3XAY/aPeacefulSceneBlot/README.md

# UPDATE: BLOT HAS BEEN CANCELLED, THIS REPO IS NO LONGER BEING WORKED ON - 3XAY

# Blot, the plotter bot from Hack Club

**[🕸 Landing Page](https://blot.hackclub.com)** | **[💻 Online Editor](https://blot.hackclub.com/editor)** | **[👀 Gallery](https://blot.hackclub.com/gallery)**

Create programmatic art in our web-based editor and submit it to the gallery and we'll send you a CNC machine which can make that art for free.
Blot is a [**You Ship, We Ship**](https://github.com/hackclub/blot/tree/main?tab=readme-ov-file#you-ship-we-ship) project from [Hack Club](https://hackclub.com). 

> Everything about Blot is open source. The online editor and drawing library can be freely used by anyone, and we encourage all to submit to the gallery through PRs! However, you must be a teenager or younger to receive a free machine.

blot-white-bg

A piece of art made for Blot can be the first program you ever write, but it can also be a challenge for a master programmer. Check out some of the art made already in our [gallery](https://blot.hackclub.com/gallery). Every piece of art you see is actually a program. Many of them create unique pieces every time the art is run. You may be looking at an artwork which has never been seen before, even by the creator.

For a short video introduction to Blot [check out our 38 second trailer](https://www.youtube.com/watch?v=d1noJNmfvC0).

<a href="https://www.youtube.com/watch?v=d1noJNmfvC0">
  
</a>

# How It Works

### 1) Create a piece of programmatic art in the web editor.

To learn the Blot drawing library follow our [getting started guide](https://blot.hackclub.com/editor?guide=start). Check out the examples in the [gallery](https://blot.hackclub.com/gallery) and then follow along with some of our [guides](https://blot.hackclub.com/guides).

editor

### 2) Submit that art to the public gallery.

The [submission rules to get a Blot for a PR are here](https://github.com/hackclub/blot/blob/main/docs/GET_A_BLOT.md). **You must be a teenager (or younger to qualify for a free machine)** but anyone can make art and make a PR.

[](https://blot.hackclub.com/gallery)

### 3) Receive the parts to build your own Blot that can draw that art in real life.

The [bill of materials can be found here](/docs/BOM.toml) and an [assembly guide here](https://blot.hackclub.com/assembly).

all-parts



<!-- <img height="341" alt="drawing" src="https://github.com/hackclub/blot/assets/27078897/2f7c9c17-3b67-4674-b2ca-2a4dbd26a3d1" /> -->

# Blot is...

**A custom CNC drawing machine** designed from scratch to introduce you to digital fabrication. 
It's made of 6 unique 3D printed parts with a custom control board and easy to understand firmware, which can be interfaced with through JavaScript in the browser.
Blot is designed in OnShape. Check out the [3D model of the project](https://cad.onshape.com/documents/536478c2ac00624edd8e2182/w/945ceabd15096661108b7650/e/61fd4346c9fdab983c6ba24d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).
You can find the [bill of materials here](https://blot.hackclub.com/assembly) and, if you'd like to 3D print your Blot, [the parts are here](https://github.com/hackclub/blot/tree/main/hardware/mechanical/drawing-thing-v4). The entire build costs about $150 dollars. If you're a teen we will give you all the parts for a PR with your an art piece you coded yourself.

**A web based editor for programmatic art** that we designed specifically for pen plotting with a [custom geometry library](/docs/DOCUMENTATION.md).
We practiced programmatic pen plotting with [some](https://github.com/LingDong-) [amazing artists](https://static1.squarespace.com/static/63fbc39db5b01b5fa30423db/t/649b424d33b2ce3e0d5b63a5/1687896656015/June+Cohort+Zine.pdf). 
There is so much to learn and explore on the programming and the aesthetic side. 

parts



# Blot Docs

Here are a collection of resources for Blot:

- [Complete documentation of the drawing library in the editor](https://github.com/hackclub/blot/blob/main/docs/DOCUMENTATION.md)
- [Short documentation shown in the Blot editor](https://github.com/hackclub/blot/blob/main/public/TOOLKIT.md)
- [The Blot assembly and operation guide](https://github.com/hackclub/blot/blob/main/docs/assembly/ASSEMBLY.md)
- [The source of truth bill of materials (BOM)](https://github.com/hackclub/blot/blob/main/docs/BOM.toml)
- [Criteria for how to get a Blot and a guide on how to submit a PR](https://github.com/hackclub/blot/blob/main/docs/GET_A_BLOT.md)
- [A guide on how to review Blot submissions](https://github.com/hackclub/blot/blob/main/docs/BLOT_REVIEW.md)
- [A brief guide on how to approve Blot requests for Blot shipments](https://github.com/hackclub/blot/blob/main/docs/APPROVING_BLOT_REQUESTS.md)
- [Information on how we order Blot supplies from our manufacturing partners](https://github.com/hackclub/blot/blob/main/docs/ORDERING_BLOT_KITS.md)
- [The files for the 3D printed parts](https://github.com/hackclub/blot/tree/main/hardware/mechanical/blot-v6)
- [The source files for the control PCB](https://github.com/hackclub/blot/tree/main/hardware/motor-control-board/circuit/controller)
- [The source files for the power delivery PCB](https://github.com/hackclub/blot/tree/main/hardware/motor-control-board/circuit/power-delivery)
- [The firmware for the Blot control board](https://github.com/hackclub/blot/blob/main/hardware/motor-control-board/firmware/firmware.ino)
- [Sample Blot based lesson plan](https://github.com/hackclub/blot/blob/main/docs/lesson/LESSON-PLAN.md)
- [Video of a Blot being assembled](https://www.youtube.com/watch?v=7N-Nu6_oo4I)
- [Video of operating a Blot](https://www.youtube.com/watch?v=qDP5CNjFHJE)
- [Video of making a Blot submission](https://www.youtube.com/watch?v=AmbjNEPuv14)
- [Video Blot promo trailer](https://www.youtube.com/watch?v=d1noJNmfvC0)
- [Video introduction to JavaScript in the context of Blot](https://www.youtube.com/watch?v=3KAan1PzmxA)
- [Video introduction to Blot editor](https://www.youtube.com/watch?v=OZ9KaFr1V_o)
- [Video demonstrating working through a Blot guide](https://www.youtube.com/watch?v=mP4rUdaF8ng)

# What are People Making with Blot

Blot has been in development since January 2023 and was released April 2024. We've had lots of people use the Blot editor and the Blot machine to create visual art, run workshops and as part of interactive installations. Here's a sense of what can be done with Blot.

### Programmatic Art

There are all sorts of styles of programmatic art. Here are some examples of great Blot submissions that show a range of styles. This list is by no means exhaustive.

**The natural scene** is a common source of artistic inspiration. This could be called figurative or representational art when it tries to depict a real thing with some fidelity. One example are these roots by Kai (age 17).

<a href="https://blot.hackclub.com/editor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">
  collection
</a>

**The geometric pattern** is natural avenue to pursue when making art with computers because code is a great way to describe patterns. Oz's approach of clipping overlapping segments creates a wonderful sense of depth.

<a href="https://blot.hackclub.com/editor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">
  
</a>

**The tech demo (with composition)** is focusing on a specific technical approach like in Henry's (age 15) ray marcher. The art piece isn't complete though until the artists uses the technique to make a composition.

<a href="https://blot.hackclub.com/editor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">
  <picture>
    <source media="(prefers-color-scheme: dark)" srcset="https://github.com/hackclub/blot/assets/61765149/d65464eb-8cc2-4bf3-be82-0b4cc12070bd">
    <source media="(prefers-color-scheme: light)" srcset="https://github.com/hackclub/blot/assets/27078897/90c01a52-0404-423f-8ae9-763bc591ff9f">
    
  </picture>
</a>

**The data transformation** can be seen in Kieran's (age 15) self portrait. It takes data from an SVG but modifies it programmatically to produce an art piece. This approach could be used to visualize data that may not of been visual to begin with.

<a href="https://blot.hackclub.com/editor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">
  
</a>

**The concept** is important with any artwork and can be mixed with any of the genres above. Ultimately an interesting idea can be what elevates something that is visually pretty simple, one example by Ayush is the Blot's own self portrait.

<a href="https://blot.hackclub.com/editor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">
  <picture>
    <source media="(prefers-color-scheme: dark)" srcset="https://github.com/hackclub/blot/assets/61765149/12044cdf-a498-438c-814b-48622488e42f">
    <source media="(prefers-color-scheme: light)" srcset="https://github.com/hackclub/blot/assets/27078897/1f367d9b-aa74-4fca-8623-259a06800335">
    
  </picture>
</a>

For way more examples check out the [gallery](https://blot.hackclub.com/gallery).

### Blot as Creative Material

You ship we ship projects are developed to provide technological creative material. The Blot was developed to not just create visual programs on computers but also to explore robotic and interactive technology. Here are some ways the machine or project has been used to create interactive technology experiences.

[**Lineflow**](https://github.com/leomcelroy/lineflow) was developed as an interactive art piece for an MIT Museum event. Participants would create a single line drawing on the computer and would then watch a simulation of a line folding into their drawing. Three frames of that simulation were strung together to create a timeline of the animation that would be drawn by a Blot to be brought home by the participant.





**The infinite gallery** at [Outernet](https://www.youtube.com/watch?v=O1s5HqSqKi0) (Hack Club's 2023 summer hackathon). Leo, Kai, and Henry constructed a black out box that contained an infinite art gallery. Participant's entered a room sized black box with one wall illuminated with artwork and a giant joystick in the center. They could navigate the gallery with the joystick and as they explored new (possibly never before seen) art was generated based on their location. 



**Chinese calligraphy workshop** was developed for and run at the [Hack Club leader summit 2024](https://www.youtube.com/watch?v=UZEm5lONg7g) by Bright Li (age 15). During it participants learned how to draw Chinese calligraphy programmatically and then handed ink brushes to Bright's Blot robot to put the drawings to the page.



# It's All Open Source

Every part of Blot is freely available for you to investigate and discover. 
That includes the editor, the hardware design, the electronics, and even the finances around the project.
We think people deserve tools they can take ownership of. That's why we give away the source for free. 

Our projects at Hack Club have hundreds of teenage contributors from all over the world. If you want to learn how to program, we invite you to jump in and start building tools used by thousands.

You're also welcome to participate and use our tools if you aren't a teen (like making art or building your own blot), but our [online community](https://hackclub.com/slack) is for teens only.

# You Ship, We Ship

At Hack Club we're reimagining a new type of public education for technology. We believe people learn best by creating things they care about and sharing them with others. We build open source creative tools with young people all around the world. These tools are gateways to new subjects in technology like [embedded systems](https://sprig.hackclub.com), [circuits](https://onboard.hackclub.com) or digital fabrication robotics. When teenagers build things with our tools we send them more creative materials for free. 

Our goal is to build a new type of library online that offers learners not just media to consume but tools to create. And it is free and open source to all. We're just getting started...

# Development

Join the `#blot` channel on the [Hack Club Slack](https://hackclub.com/slack). 

The Blot editor is run with an Express server.

After installing `Git`, `Node.js`, and `Yarn`, clone the repo.

```
git clone https://github.com/hackclub/blot/
yarn install
```

To run the development server:

```
yarn dev
```

# License
The Hack Club Blot is open source and licensed under the [MIT License](https://github.com/hackclub/blot/LICENSE.md). Fork, remix, and make it your own! Pull requests and other contributions greatly appreciated.

# Acknowledgements

Many people have contributed to Blot, to mention a few and give much thanks too...

MIT's Center for Bits and Atoms for providing expert advice and occasionally a space to work. 

Sam Hu and his team at ISourceAsia for supplying Blot parts and becoming a critical part of the Blot team. 

Paul Hamilton for his contributions to embedded circuit designs.

Oz Nova for writing an excellent getting started guide.
