3XAY/aPeacefulSceneBlot/art/3D-Raycasting-Jaiden/snapshots/snapshot3.png

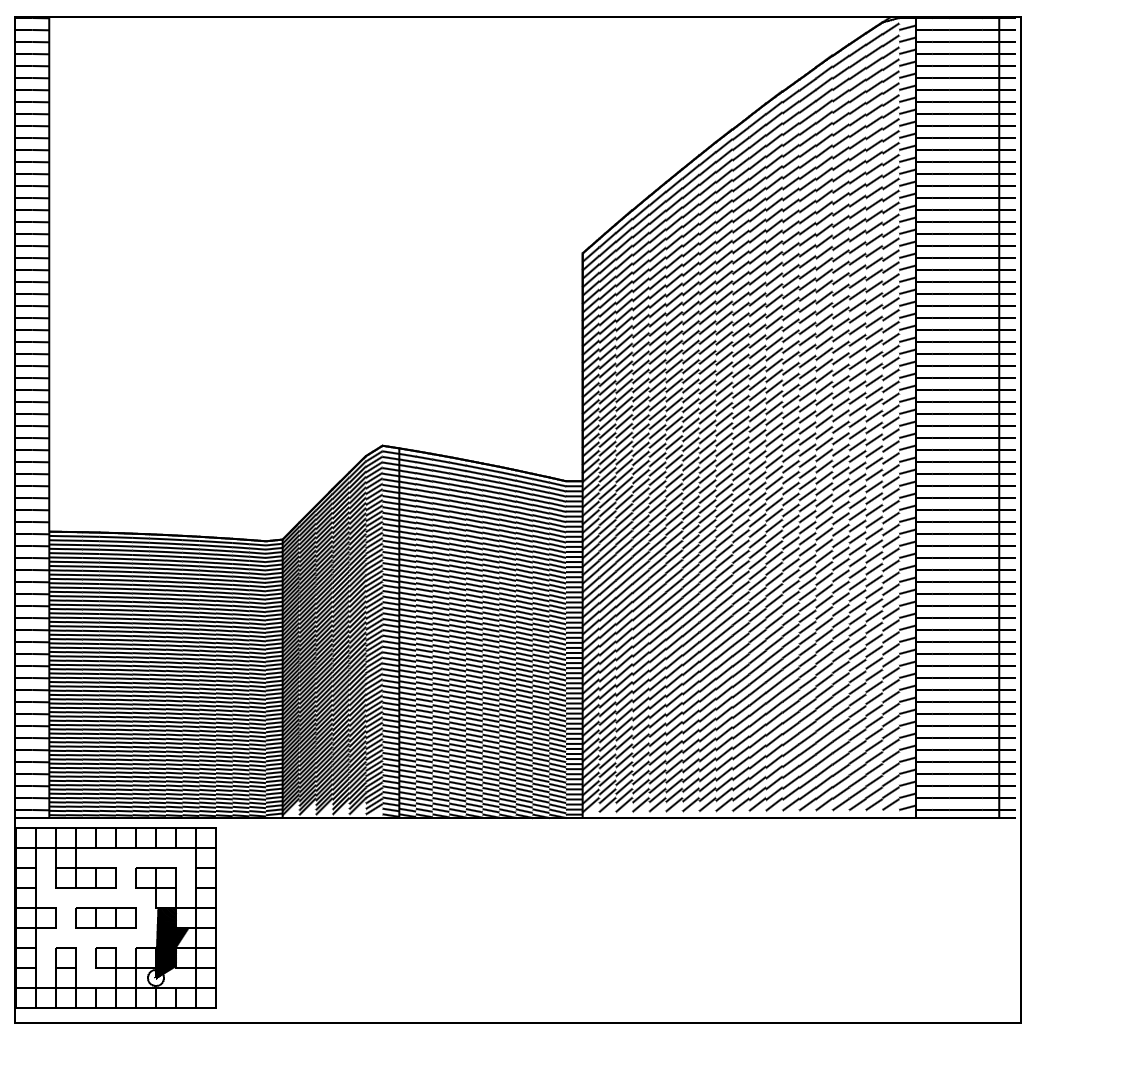
art/3D-Raycasting-Jaiden/snapshots/snapshot3.png
