3XAY/aPeacefulSceneBlot/art/3DGameOfLife/snapshots/snapshot0.png

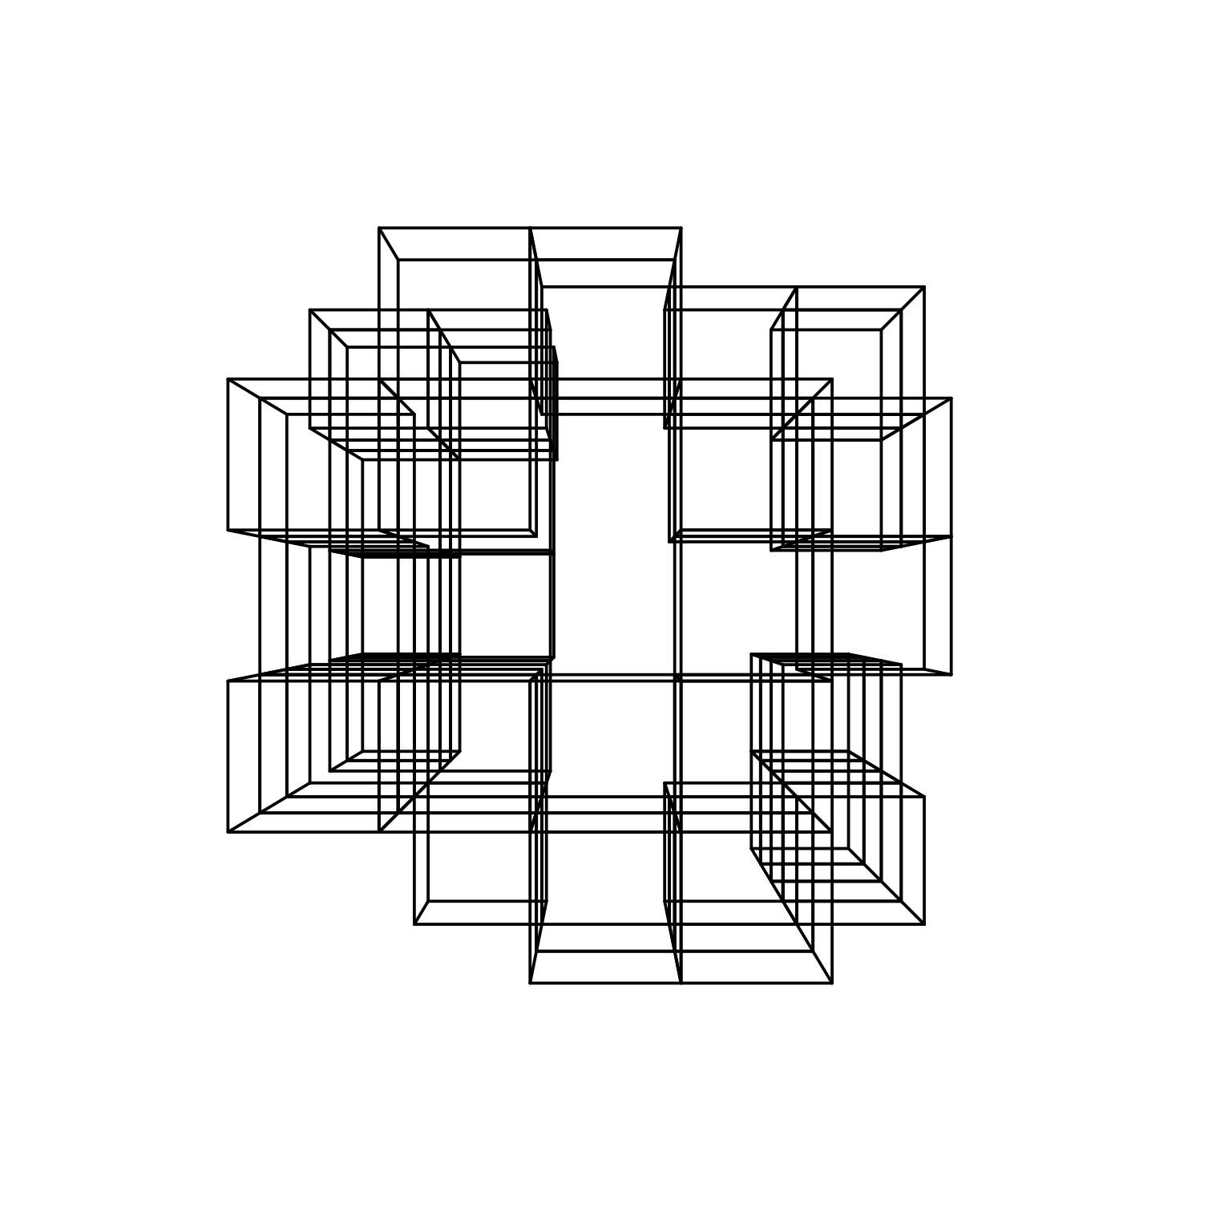
art/3DGameOfLife/snapshots/snapshot0.png
