3XAY/aPeacefulSceneBlot/art/3DGameOfLife/snapshots/snapshot1.png

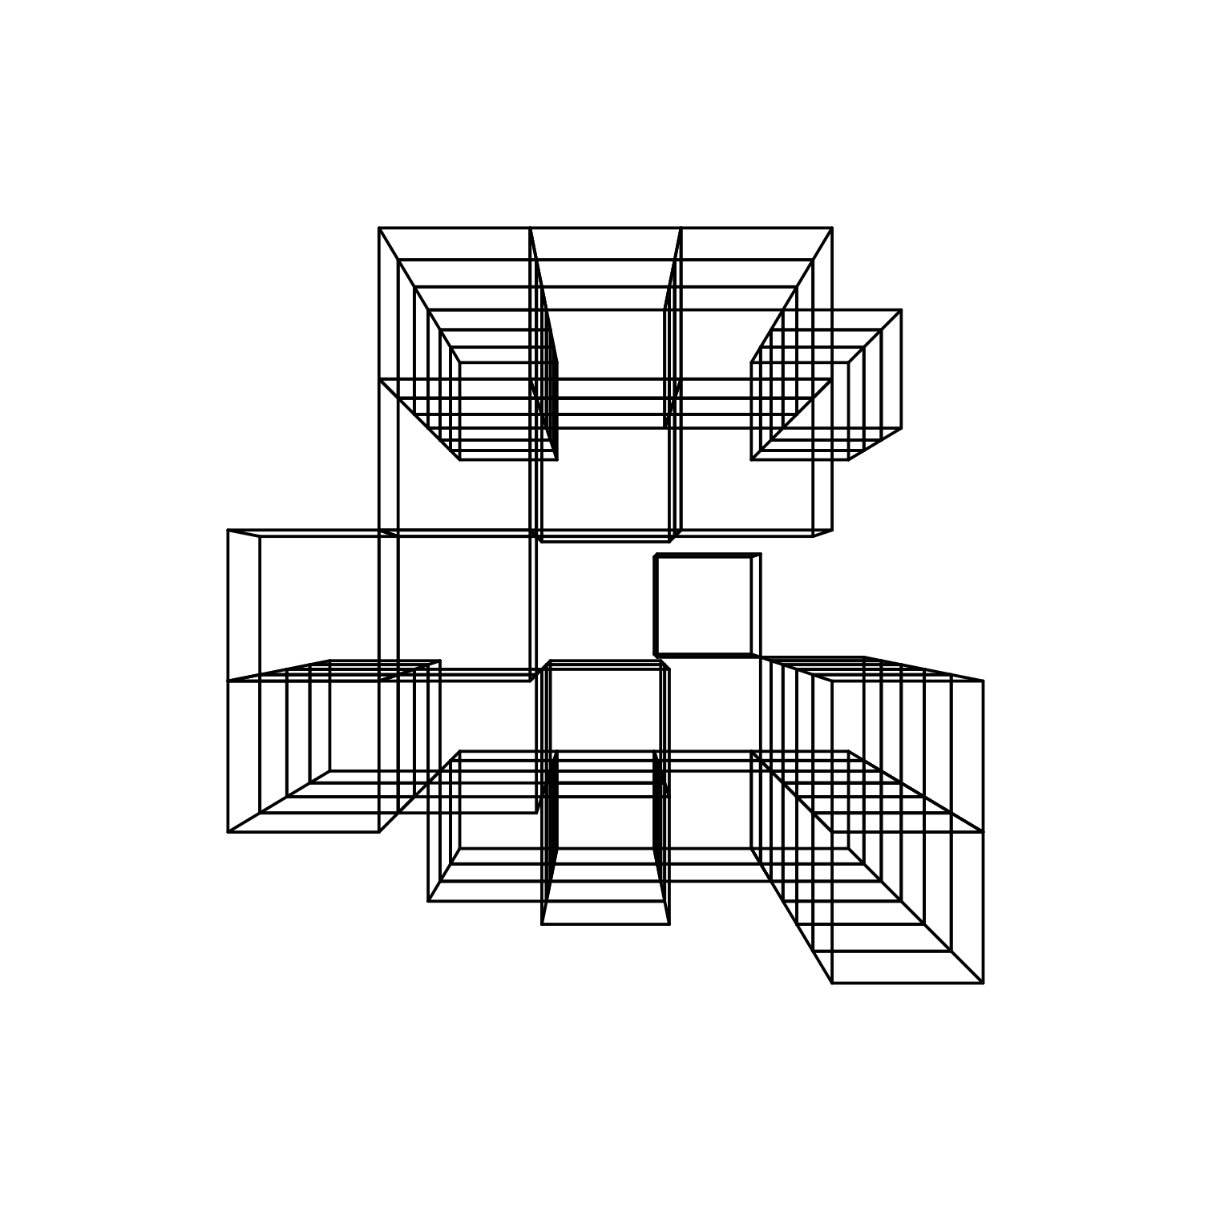
art/3DGameOfLife/snapshots/snapshot1.png
