3XAY/aPeacefulSceneBlot/art/3DRoom-AgrimBansal/snapshots/1.png

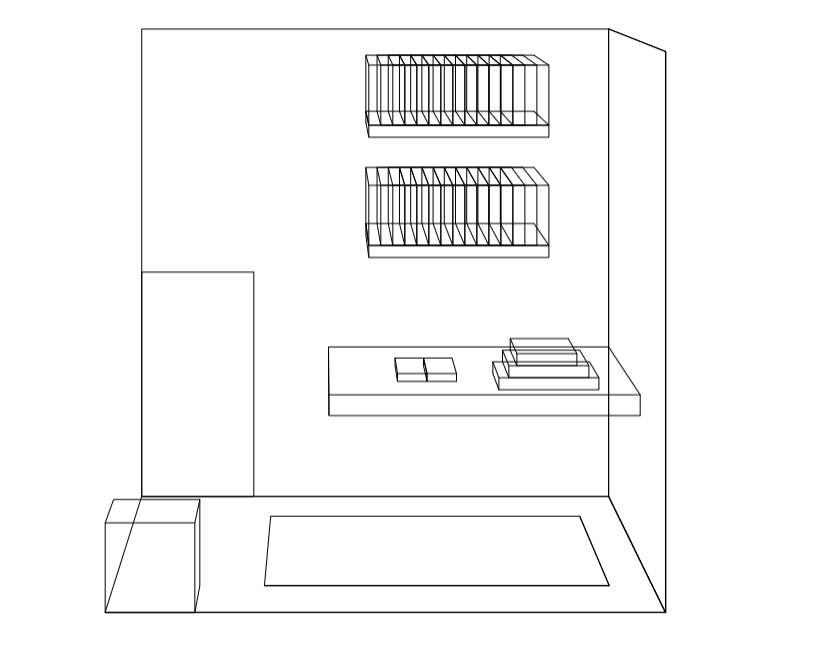
art/3DRoom-AgrimBansal/snapshots/1.png
