3XAY/aPeacefulSceneBlot/art/3DRoom-AgrimBansal/snapshots/2.png

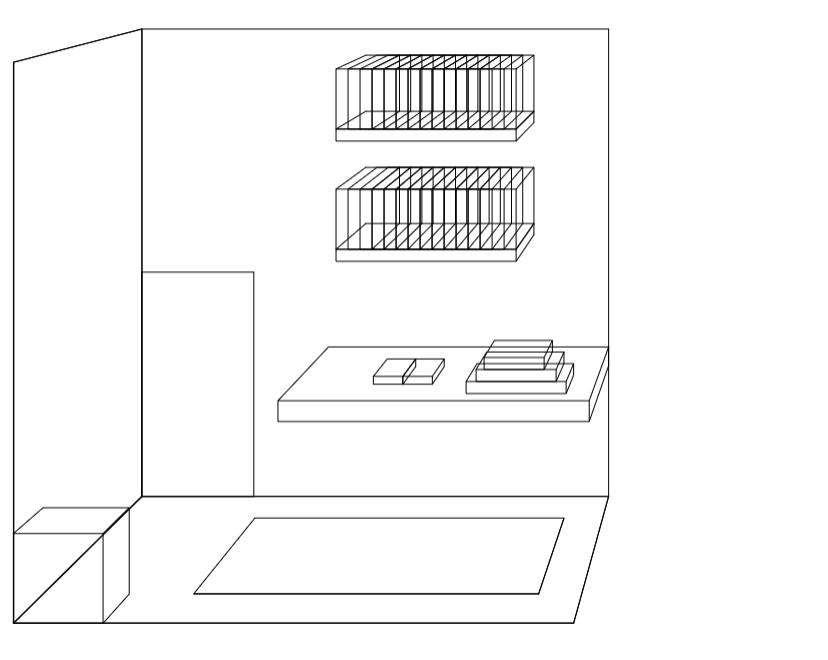
art/3DRoom-AgrimBansal/snapshots/2.png
