3XAY/aPeacefulSceneBlot/art/AtomElectronConfig-Jonak-Adipta-Kalita/snapshots/snapshot2-Magnesium.png

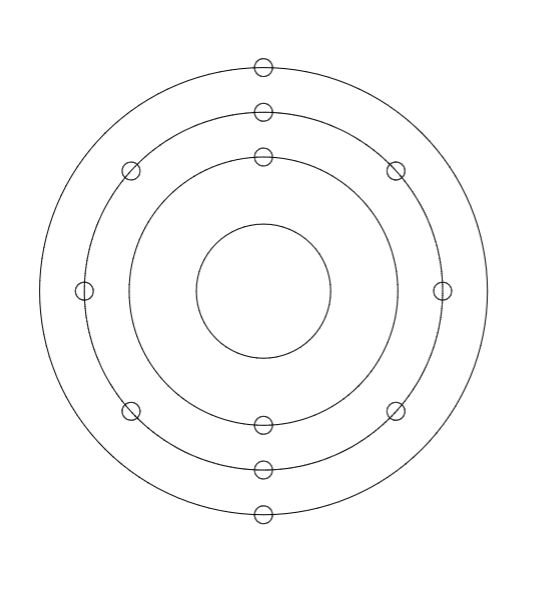
art/AtomElectronConfig-Jonak-Adipta-Kalita/snapshots/snapshot2-Magnesium.png
