3XAY/aPeacefulSceneBlot/art/AtomElectronConfig-Jonak-Adipta-Kalita/snapshots/snapshot2-Oxygen.png

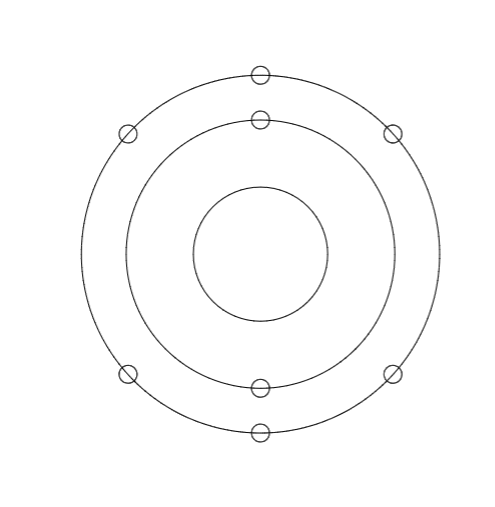
art/AtomElectronConfig-Jonak-Adipta-Kalita/snapshots/snapshot2-Oxygen.png
