3XAY/aPeacefulSceneBlot/art/BeautifulSaturn-AlexB/snapshots/snapshot1.png

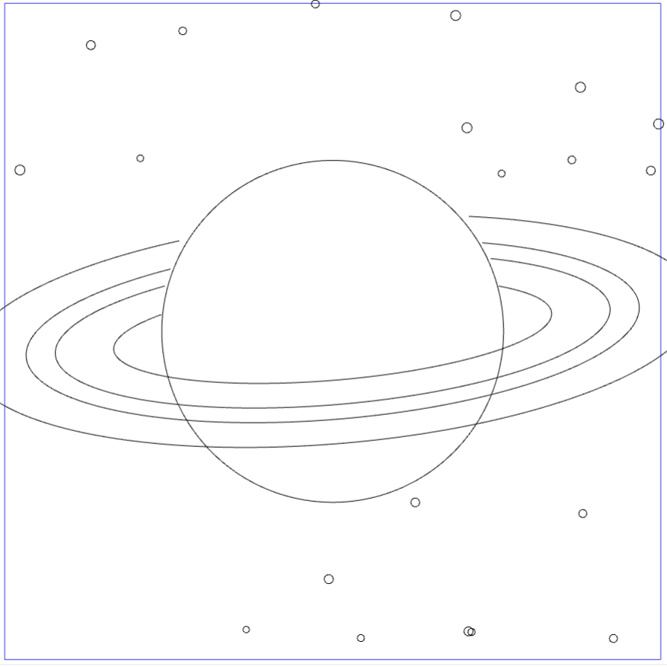
art/BeautifulSaturn-AlexB/snapshots/snapshot1.png
