3XAY/aPeacefulSceneBlot/art/blog!-alan/snapshots/blog1!.png

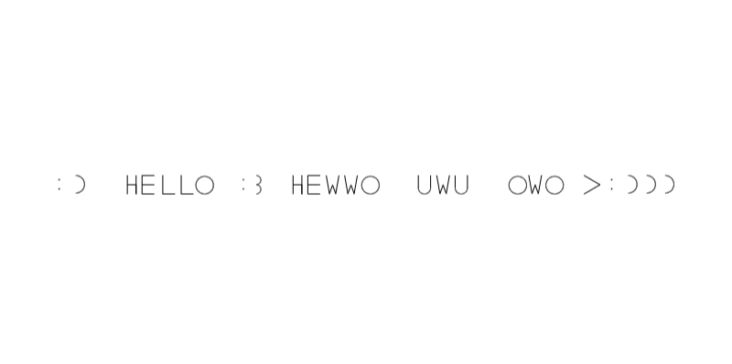
art/blog!-alan/snapshots/blog1!.png
