3XAY/aPeacefulSceneBlot/art/blotchess-blazecoding2009/snapshots/snapshot2.png

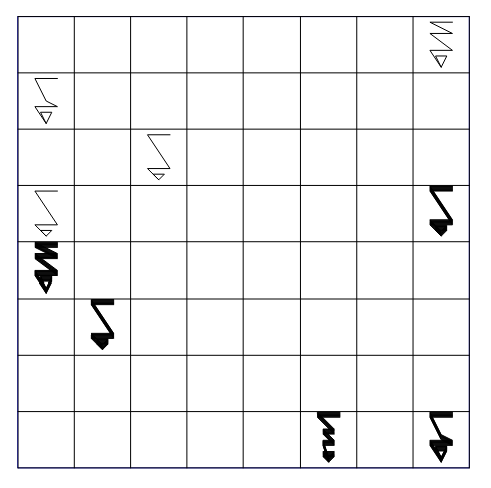
art/blotchess-blazecoding2009/snapshots/snapshot2.png
