3XAY/aPeacefulSceneBlot/art/BlottleShip-LinusC/snapshots/Blottleship2.png

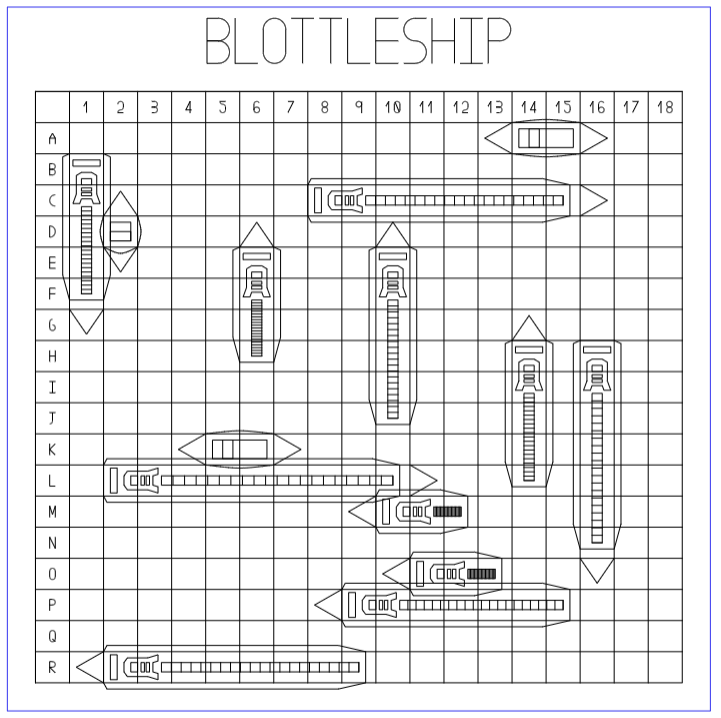
art/BlottleShip-LinusC/snapshots/Blottleship2.png
