3XAY/aPeacefulSceneBlot/art/BlottleShip-LinusC/snapshots/Blottleship.png

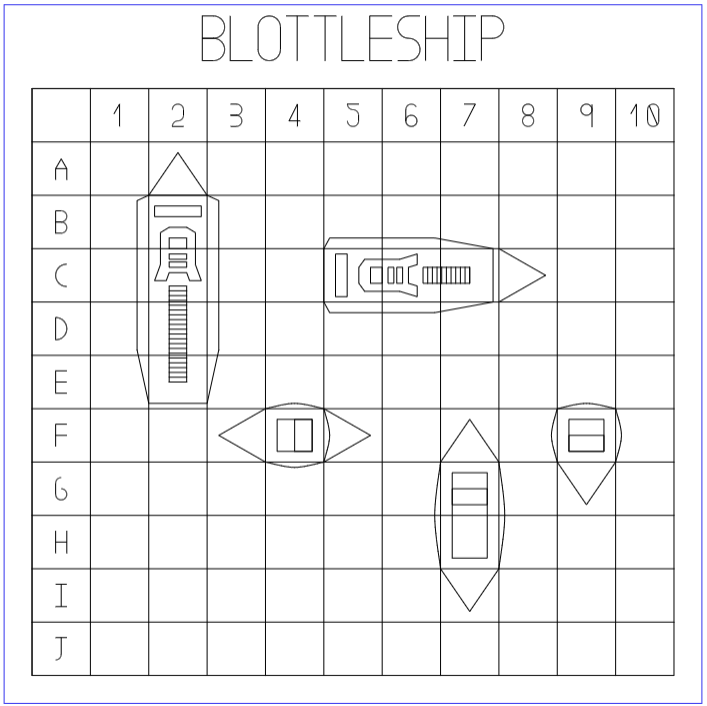
art/BlottleShip-LinusC/snapshots/Blottleship.png
