3XAY/aPeacefulSceneBlot/art/chaosGame-hughWilks/snapshots/DetailedPentagon.png

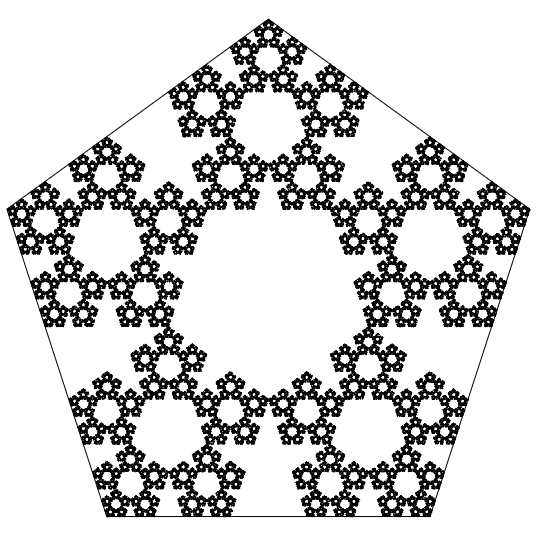
art/chaosGame-hughWilks/snapshots/DetailedPentagon.png
