3XAY/aPeacefulSceneBlot/art/circleDisarray--tyler/snapshots/3.png

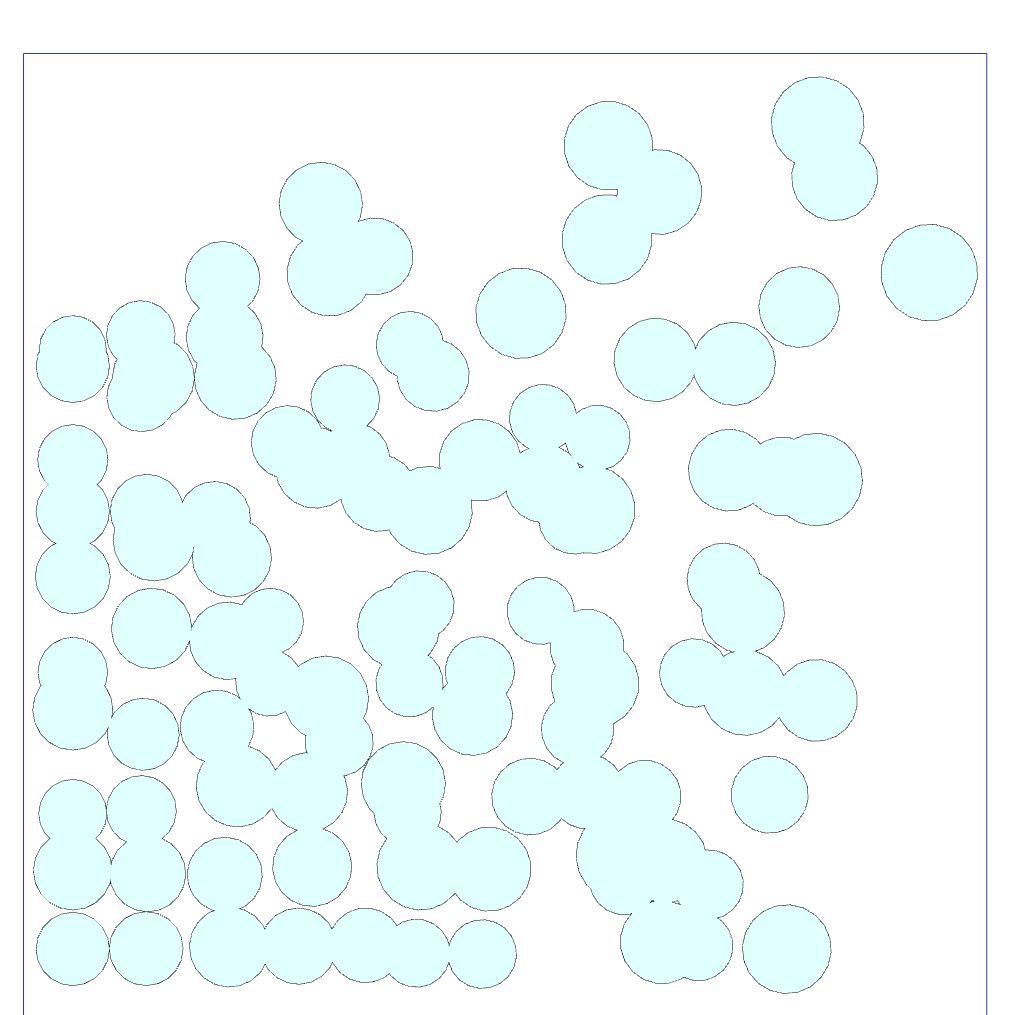
art/circleDisarray--tyler/snapshots/3.png
