3XAY/aPeacefulSceneBlot/art/circlePacker-Brendan/snapshots/circlePacker2.png

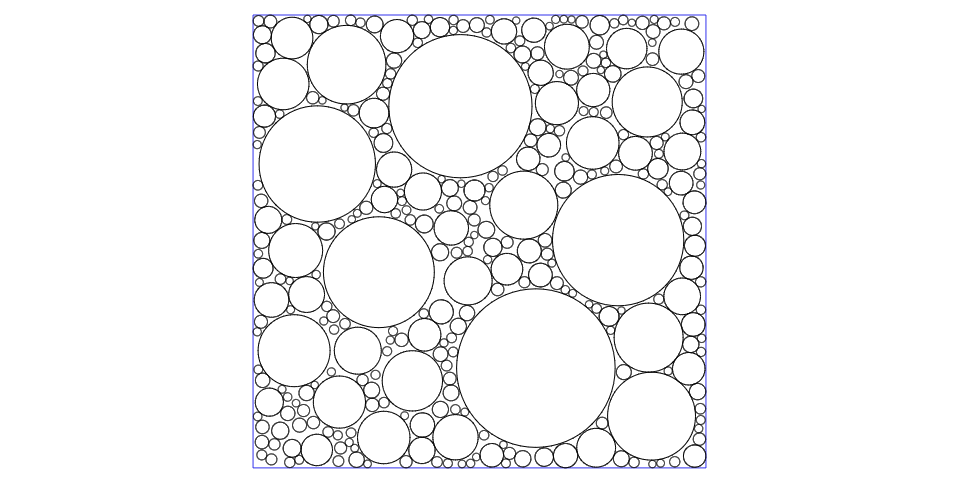
art/circlePacker-Brendan/snapshots/circlePacker2.png
