3XAY/aPeacefulSceneBlot/art/convergence-sashmitAarya/snapshots/screenshot1.png

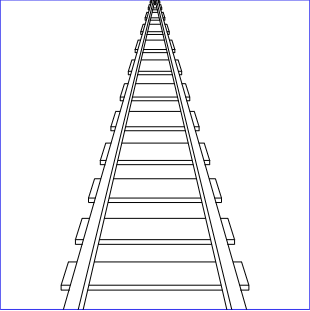
art/convergence-sashmitAarya/snapshots/screenshot1.png
