3XAY/aPeacefulSceneBlot/art/convergence-sashmitAarya/snapshots/screenshot3.png

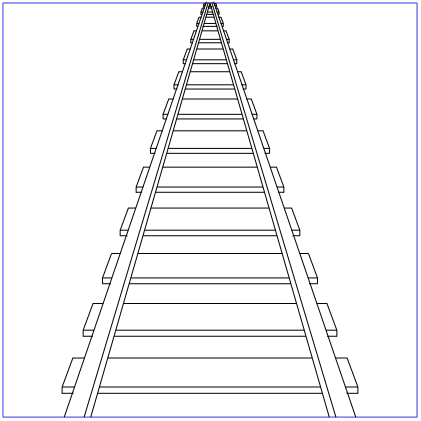
art/convergence-sashmitAarya/snapshots/screenshot3.png
