3XAY/aPeacefulSceneBlot/art/convergence-sashmitAarya/snapshots/screenshot4.png

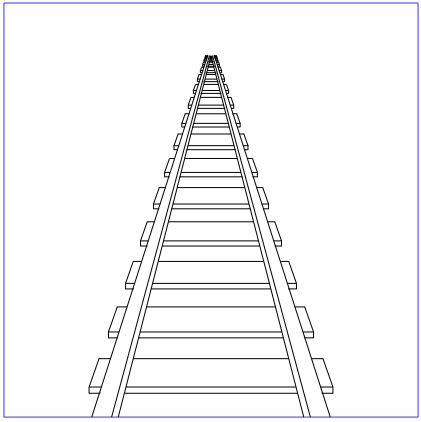
art/convergence-sashmitAarya/snapshots/screenshot4.png
