3XAY/aPeacefulSceneBlot/art/DellPowerEdge-Ssmidge/snapshots/snapshot2.png

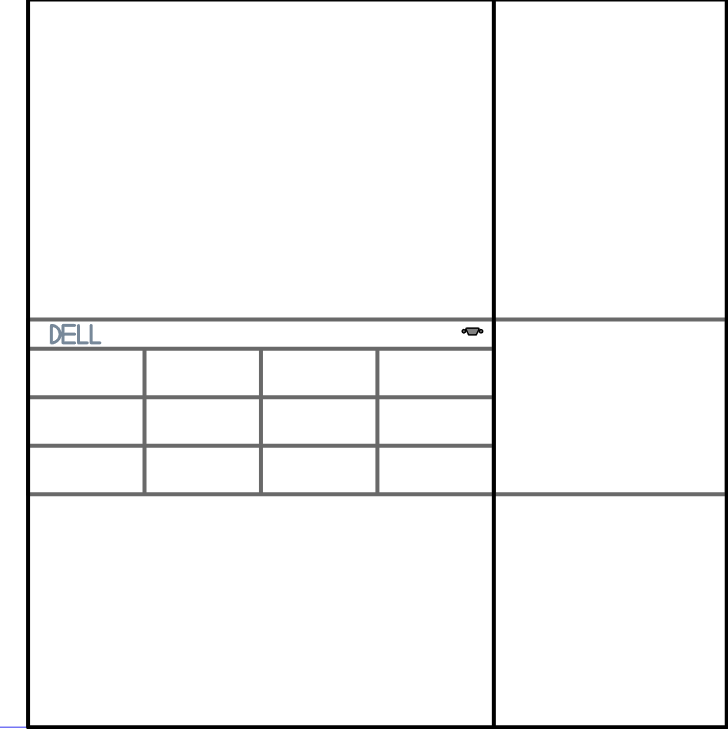
art/DellPowerEdge-Ssmidge/snapshots/snapshot2.png
