3XAY/aPeacefulSceneBlot/art/Desert-minimal-Nikhil/snapshots/2.png

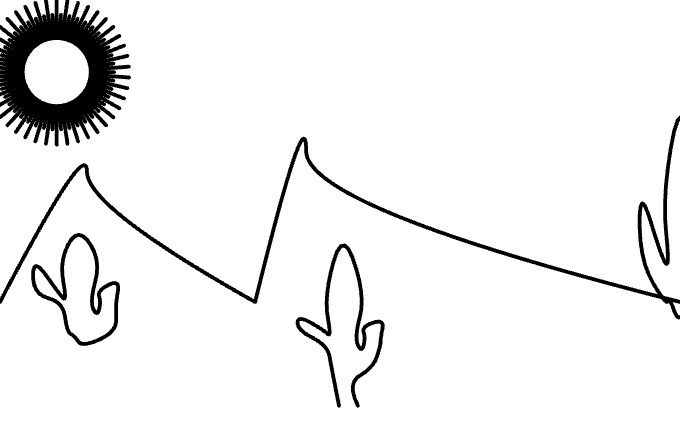
art/Desert-minimal-Nikhil/snapshots/2.png
