3XAY/aPeacefulSceneBlot/art/dexter_sunnyhouse/snapshots/image_4.png

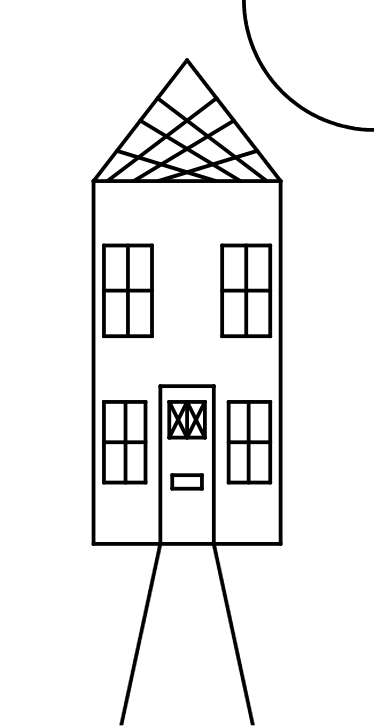
art/dexter_sunnyhouse/snapshots/image_4.png
