3XAY/aPeacefulSceneBlot/art/eca-henry/snapshots/eca3.png

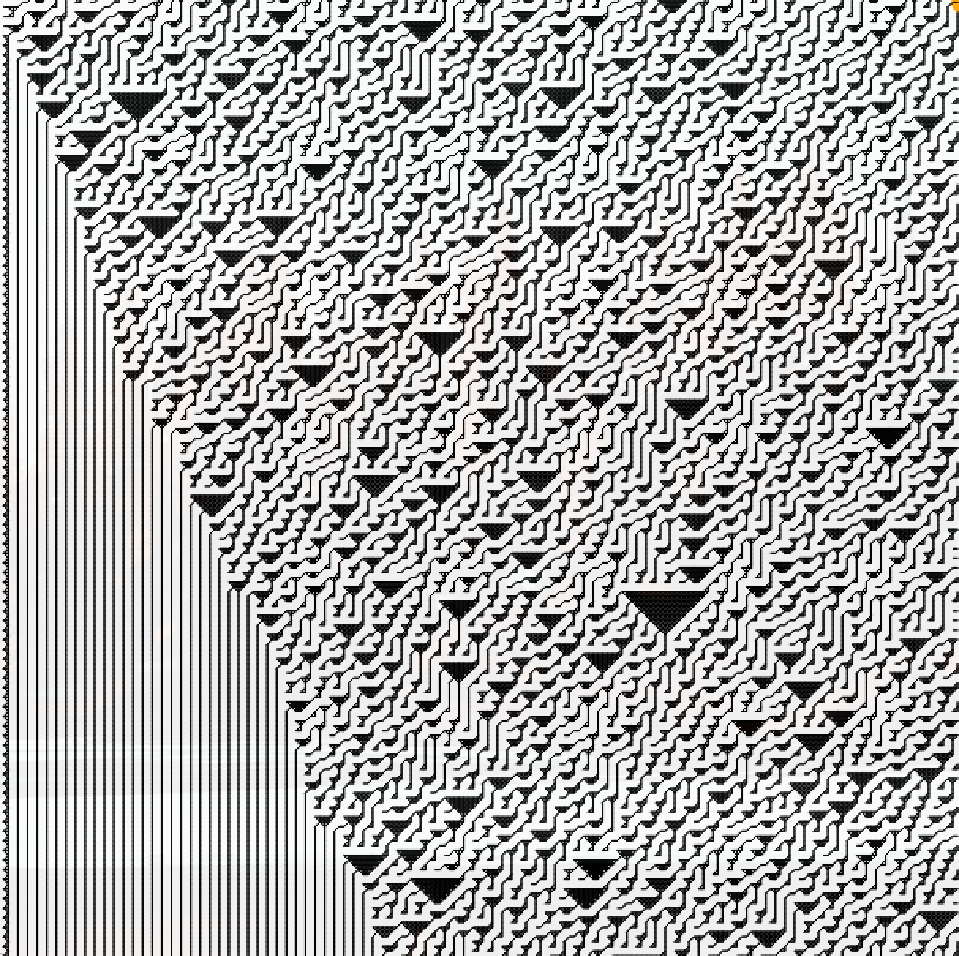
art/eca-henry/snapshots/eca3.png
