3XAY/aPeacefulSceneBlot/art/ena-edna/snapshots/snapshot2.png

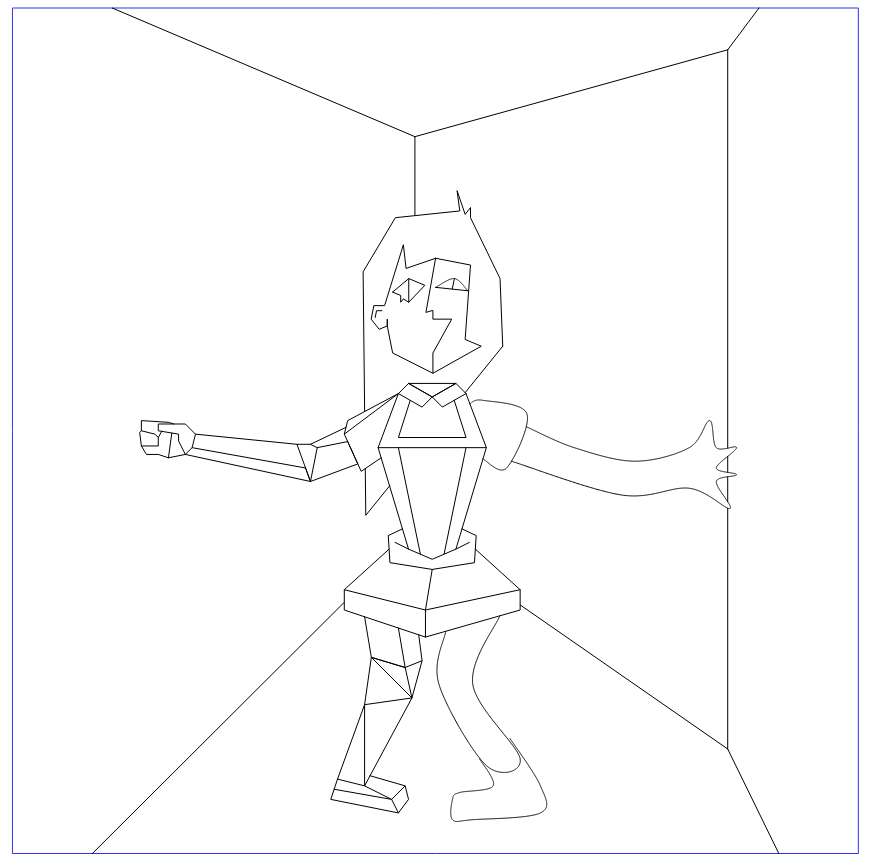
art/ena-edna/snapshots/snapshot2.png
