3XAY/aPeacefulSceneBlot/art/endlessFaces-mithilp/snapshots/image4.png

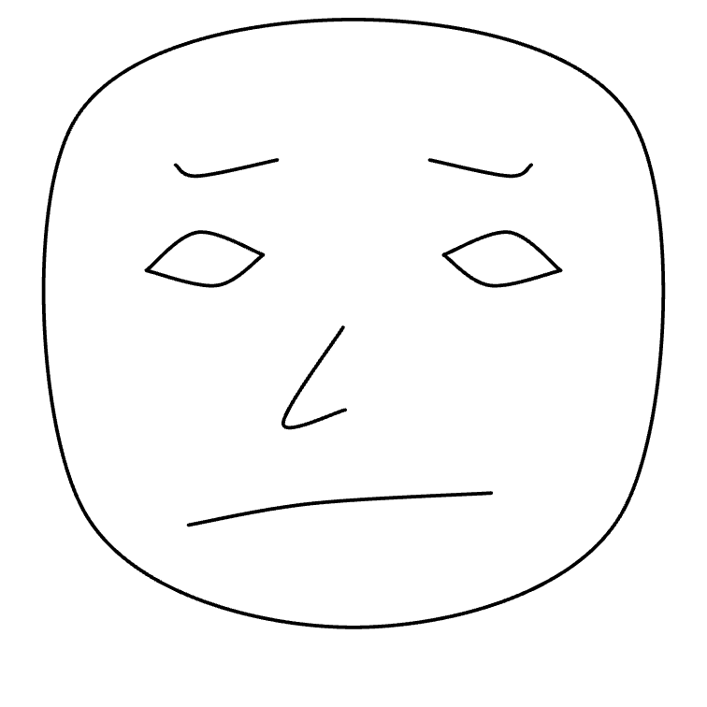
art/endlessFaces-mithilp/snapshots/image4.png
