3XAY/aPeacefulSceneBlot/art/energyBall-not_a_robot/snapshots/ball1.png

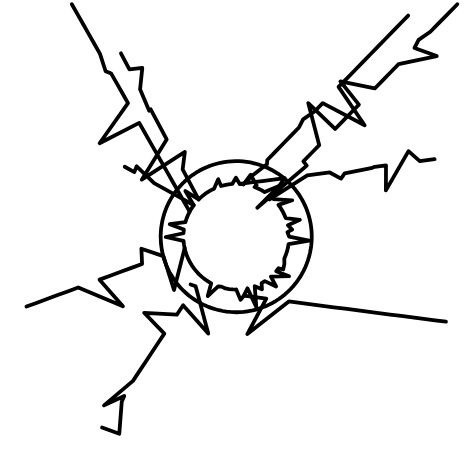
art/energyBall-not_a_robot/snapshots/ball1.png
