3XAY/aPeacefulSceneBlot/art/energyBall-not_a_robot/snapshots/ball2.png

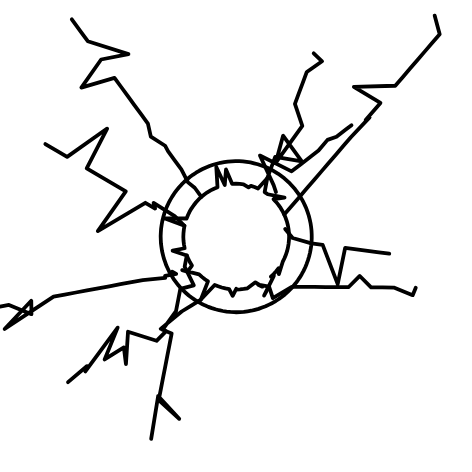
art/energyBall-not_a_robot/snapshots/ball2.png
