3XAY/aPeacefulSceneBlot/art/EulerClimbsTheTreeOfPythagoras-JuliusRompf/snapshots/1.png

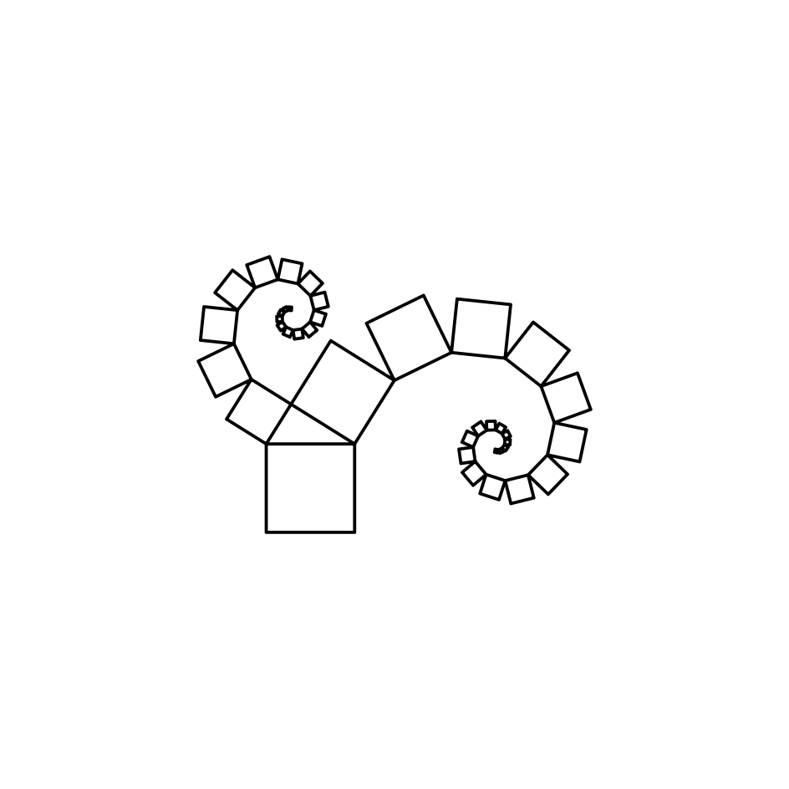
art/EulerClimbsTheTreeOfPythagoras-JuliusRompf/snapshots/1.png
