3XAY/aPeacefulSceneBlot/art/flower-gwentigges/snapshots/flower2.png

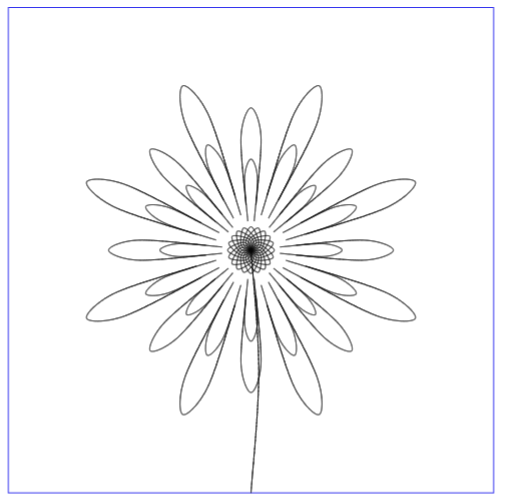
art/flower-gwentigges/snapshots/flower2.png
