3XAY/aPeacefulSceneBlot/art/FlowingCurrents-KfirElyahu/snapshots/2.png

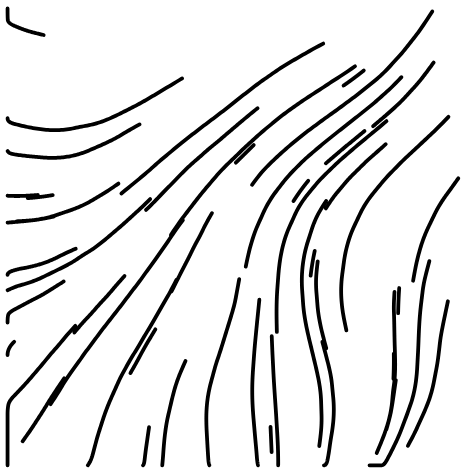
art/FlowingCurrents-KfirElyahu/snapshots/2.png
