3XAY/aPeacefulSceneBlot/art/Flute-Apoorv/snapshots/Snap2.png

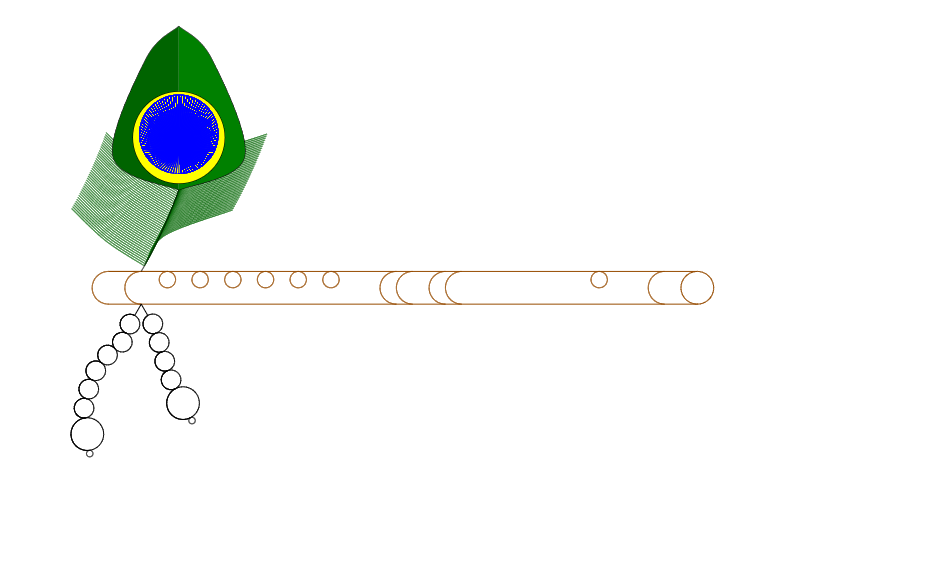
art/Flute-Apoorv/snapshots/Snap2.png
