3XAY/aPeacefulSceneBlot/art/fractal_circle-Nicolas_Landucci/snapshots/1.png

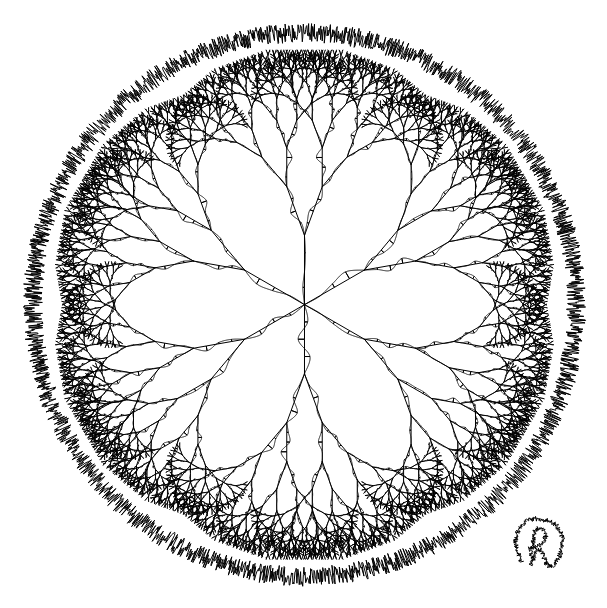
art/fractal_circle-Nicolas_Landucci/snapshots/1.png
