3XAY/aPeacefulSceneBlot/art/fractal_circle-Nicolas_Landucci/snapshots/2.png

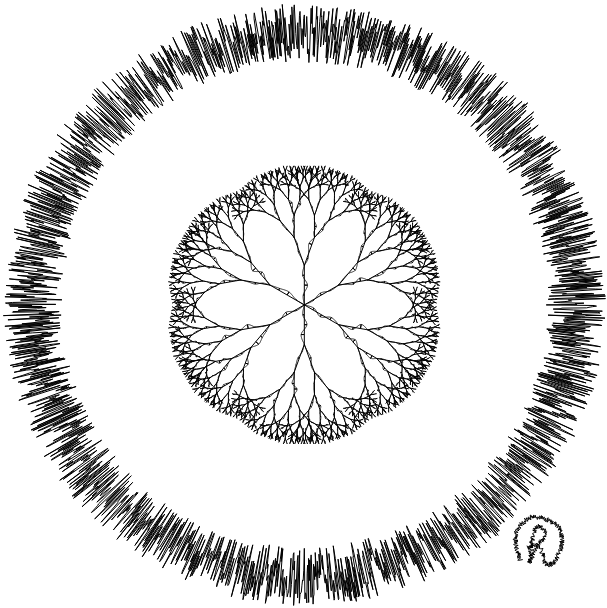
art/fractal_circle-Nicolas_Landucci/snapshots/2.png
