3XAY/aPeacefulSceneBlot/art/fractures-msw/snapshots/image_17.png

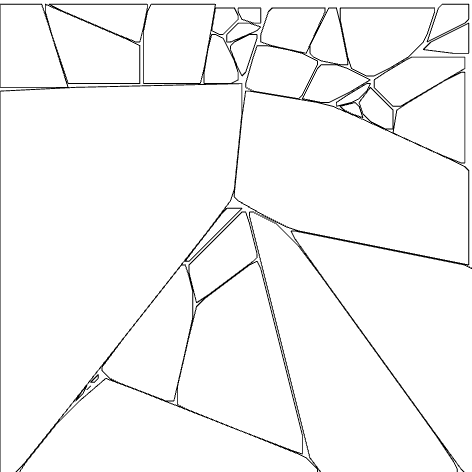
art/fractures-msw/snapshots/image_17.png
