3XAY/aPeacefulSceneBlot/art/FragmentedHorizon-Aleks/snapshots/snapshot2.png

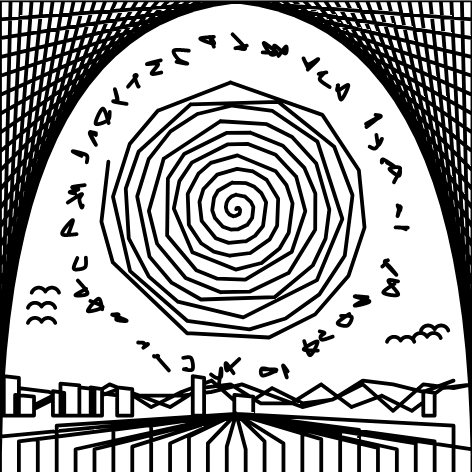
art/FragmentedHorizon-Aleks/snapshots/snapshot2.png
