3XAY/aPeacefulSceneBlot/art/FramedChildishDrawing-ValeriaDA/snapshots/snapshot1.png

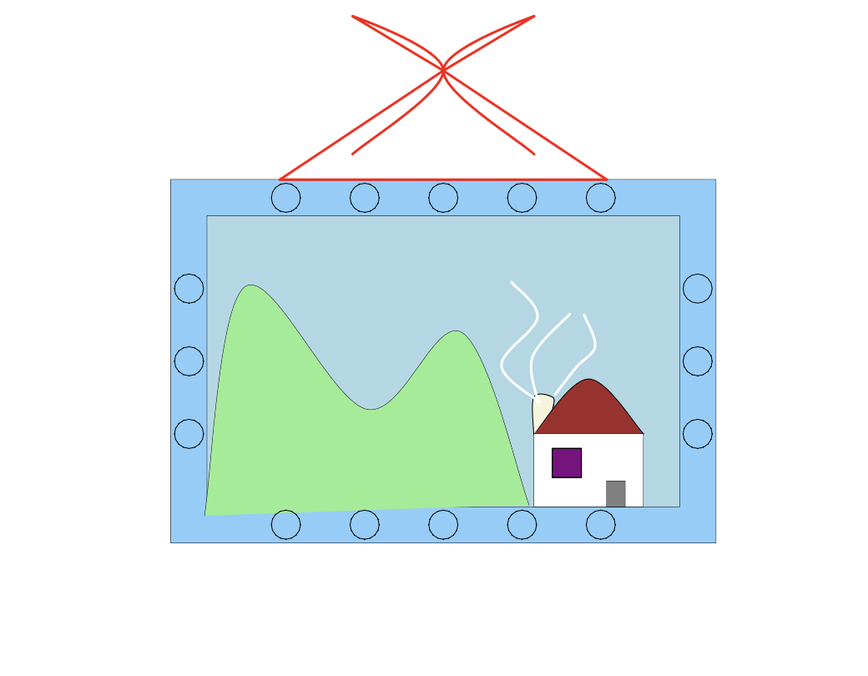
art/FramedChildishDrawing-ValeriaDA/snapshots/snapshot1.png
