3XAY/aPeacefulSceneBlot/art/Gallifreyan/snapshots/snapshot0.png

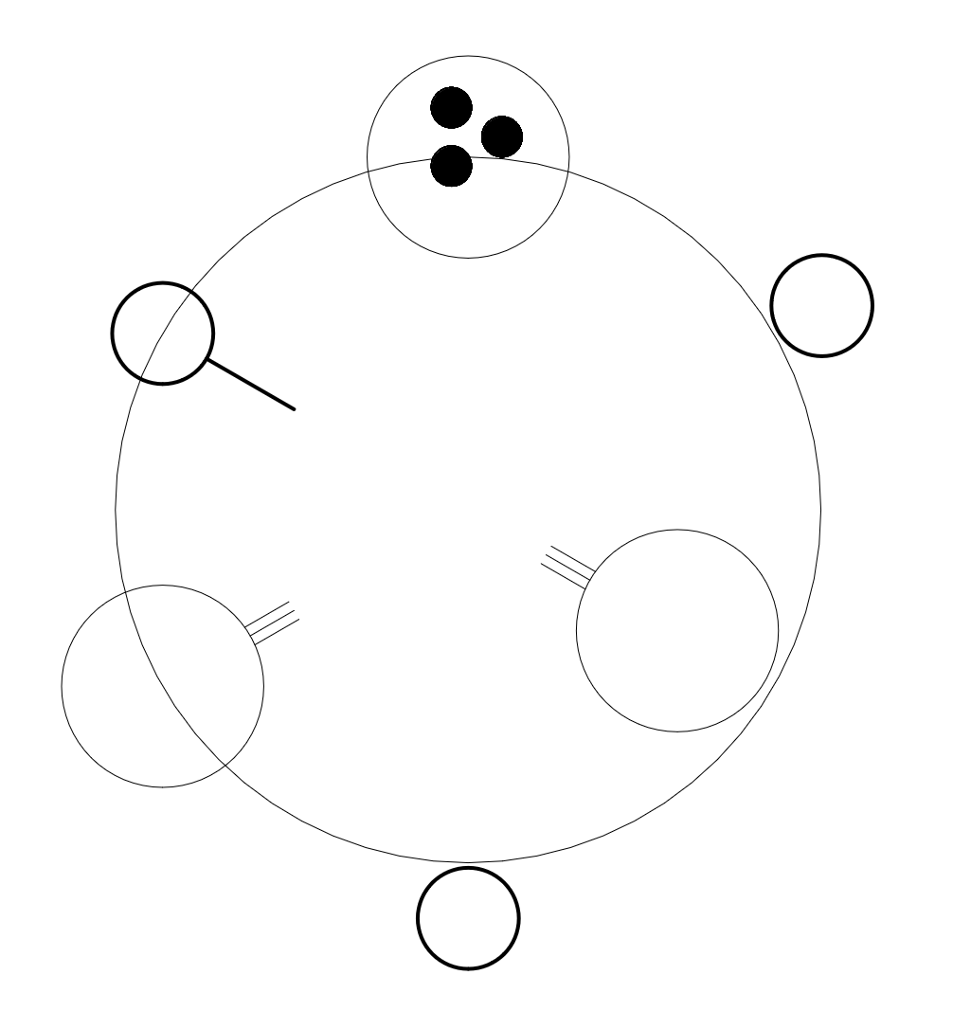
art/Gallifreyan/snapshots/snapshot0.png
