3XAY/aPeacefulSceneBlot/art/girlface-gianna/snapshots/Screenshot 2024-05-30 172307.png

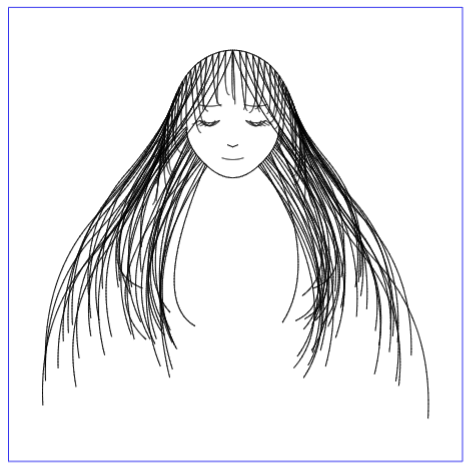
art/girlface-gianna/snapshots/Screenshot 2024-05-30 172307.png
