3XAY/aPeacefulSceneBlot/art/kirby-thaddeuskkr/snapshots/random-2.png

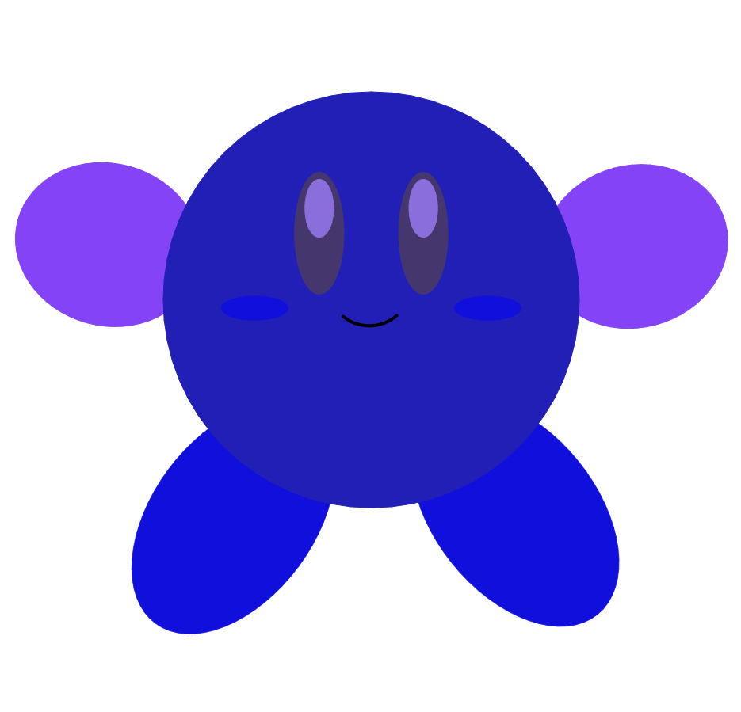
art/kirby-thaddeuskkr/snapshots/random-2.png
