3XAY/aPeacefulSceneBlot/art/KochsEye-AdwayaGupta/snapshots/depth10full.png

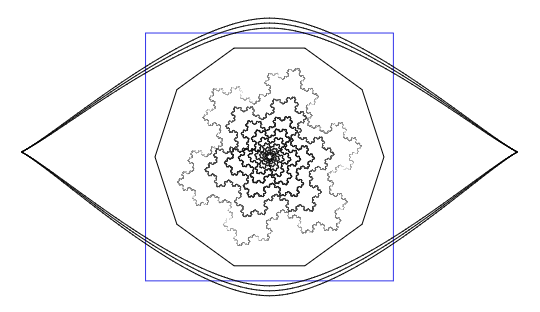
art/KochsEye-AdwayaGupta/snapshots/depth10full.png
