3XAY/aPeacefulSceneBlot/art/L-system-reva/snapshots/branches.png

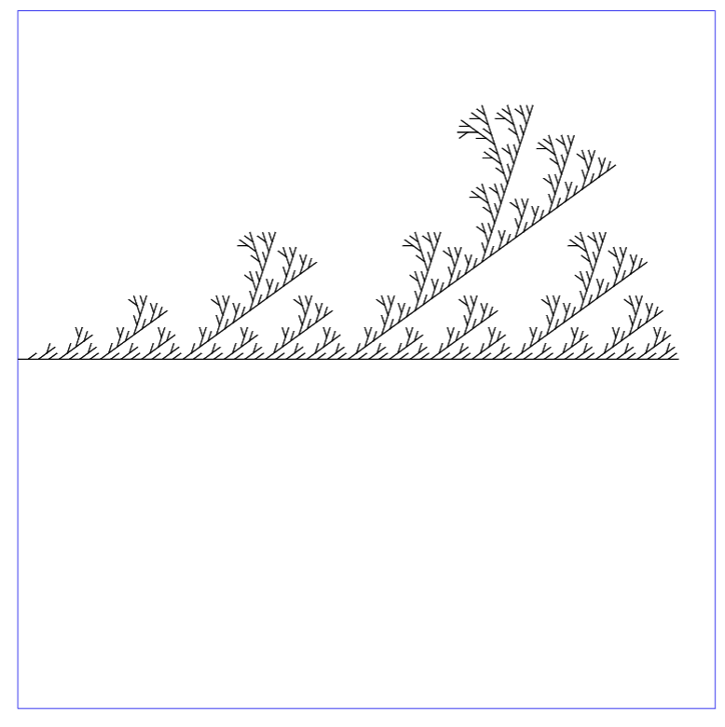
art/L-system-reva/snapshots/branches.png
