3XAY/aPeacefulSceneBlot/art/L-system-reva/snapshots/person.png

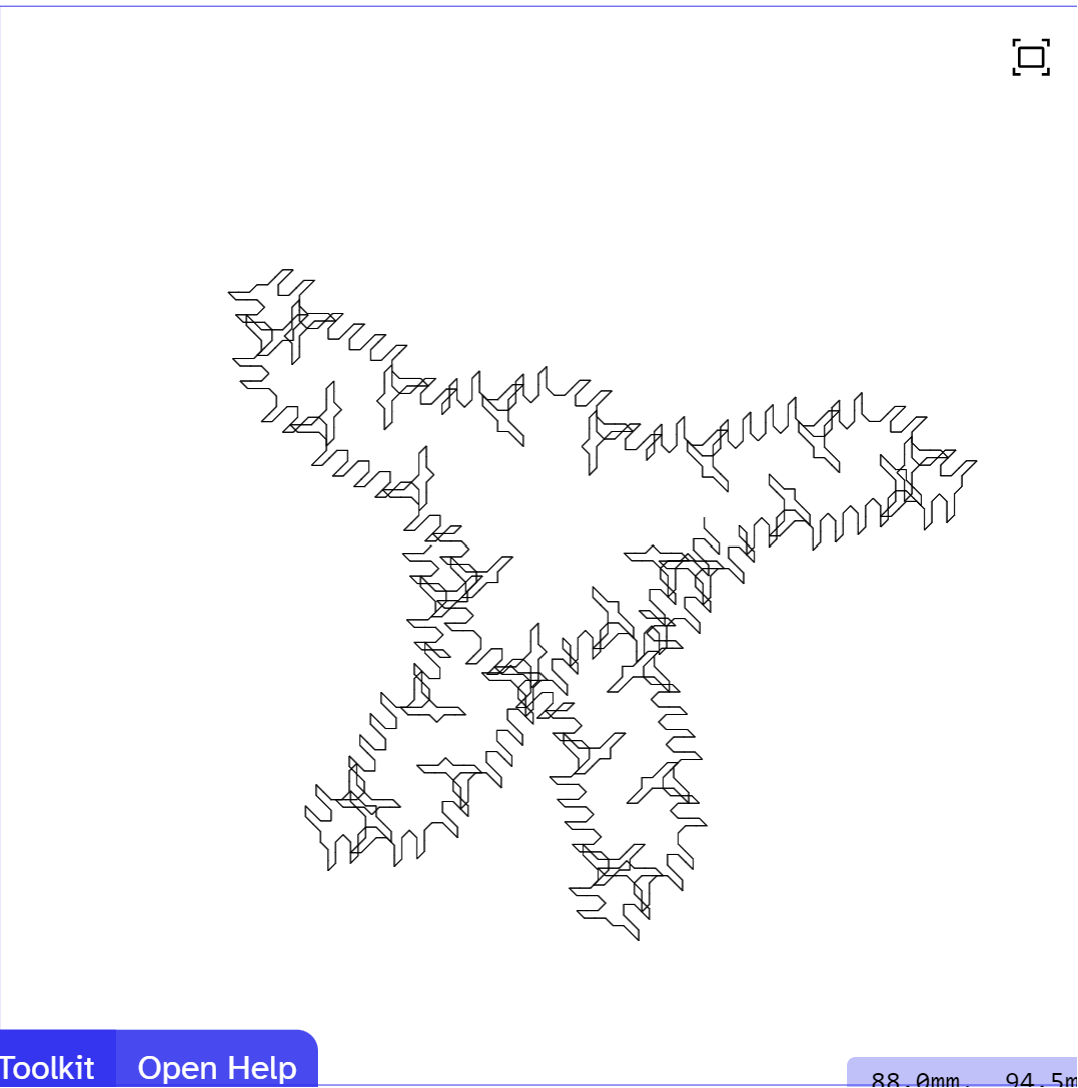
art/L-system-reva/snapshots/person.png
