3XAY/aPeacefulSceneBlot/art/LineyPeaks-Jannik/snapshots/2.png

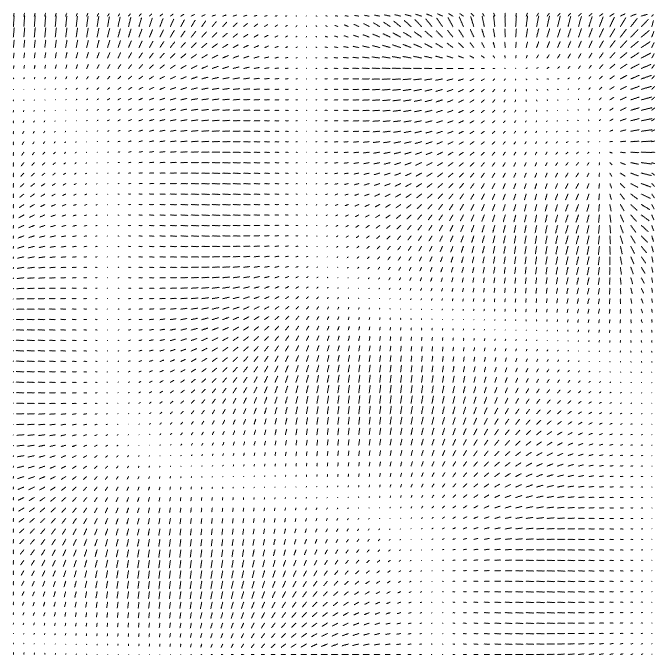
art/LineyPeaks-Jannik/snapshots/2.png
