3XAY/aPeacefulSceneBlot/art/LineyPeaks-Jannik/snapshots/3.png

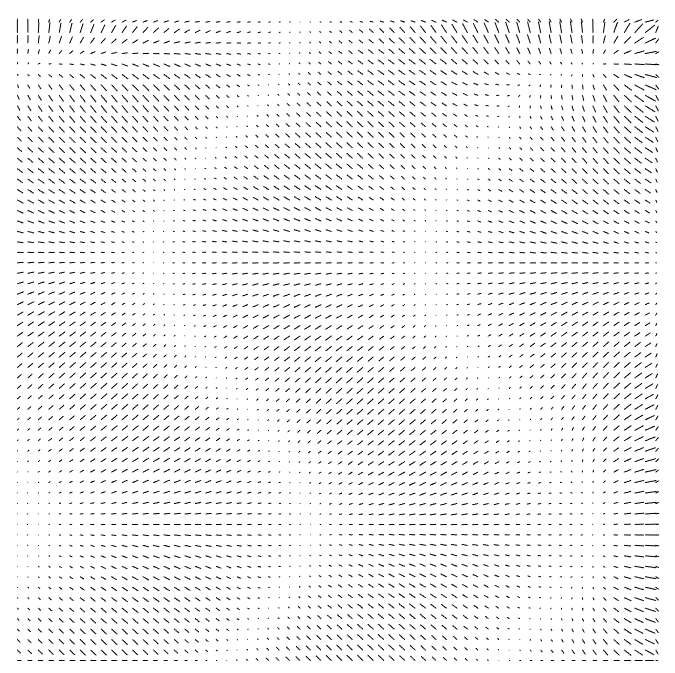
art/LineyPeaks-Jannik/snapshots/3.png
