3XAY/aPeacefulSceneBlot/art/Mandelbrot-Oskar/snapshots/1.png

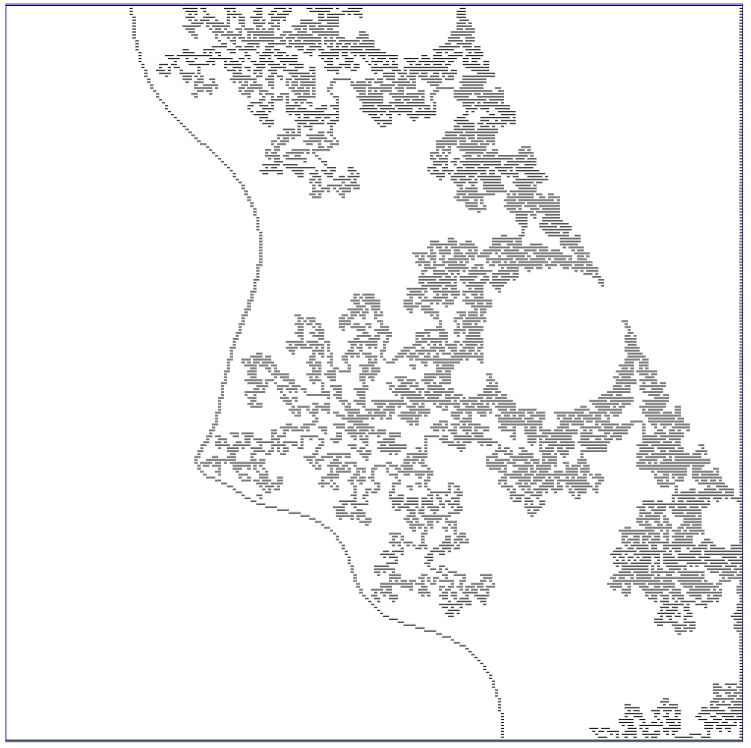
art/Mandelbrot-Oskar/snapshots/1.png
