3XAY/aPeacefulSceneBlot/art/MazeGenerator-IsaacWu/snapshots/snapshot0.png

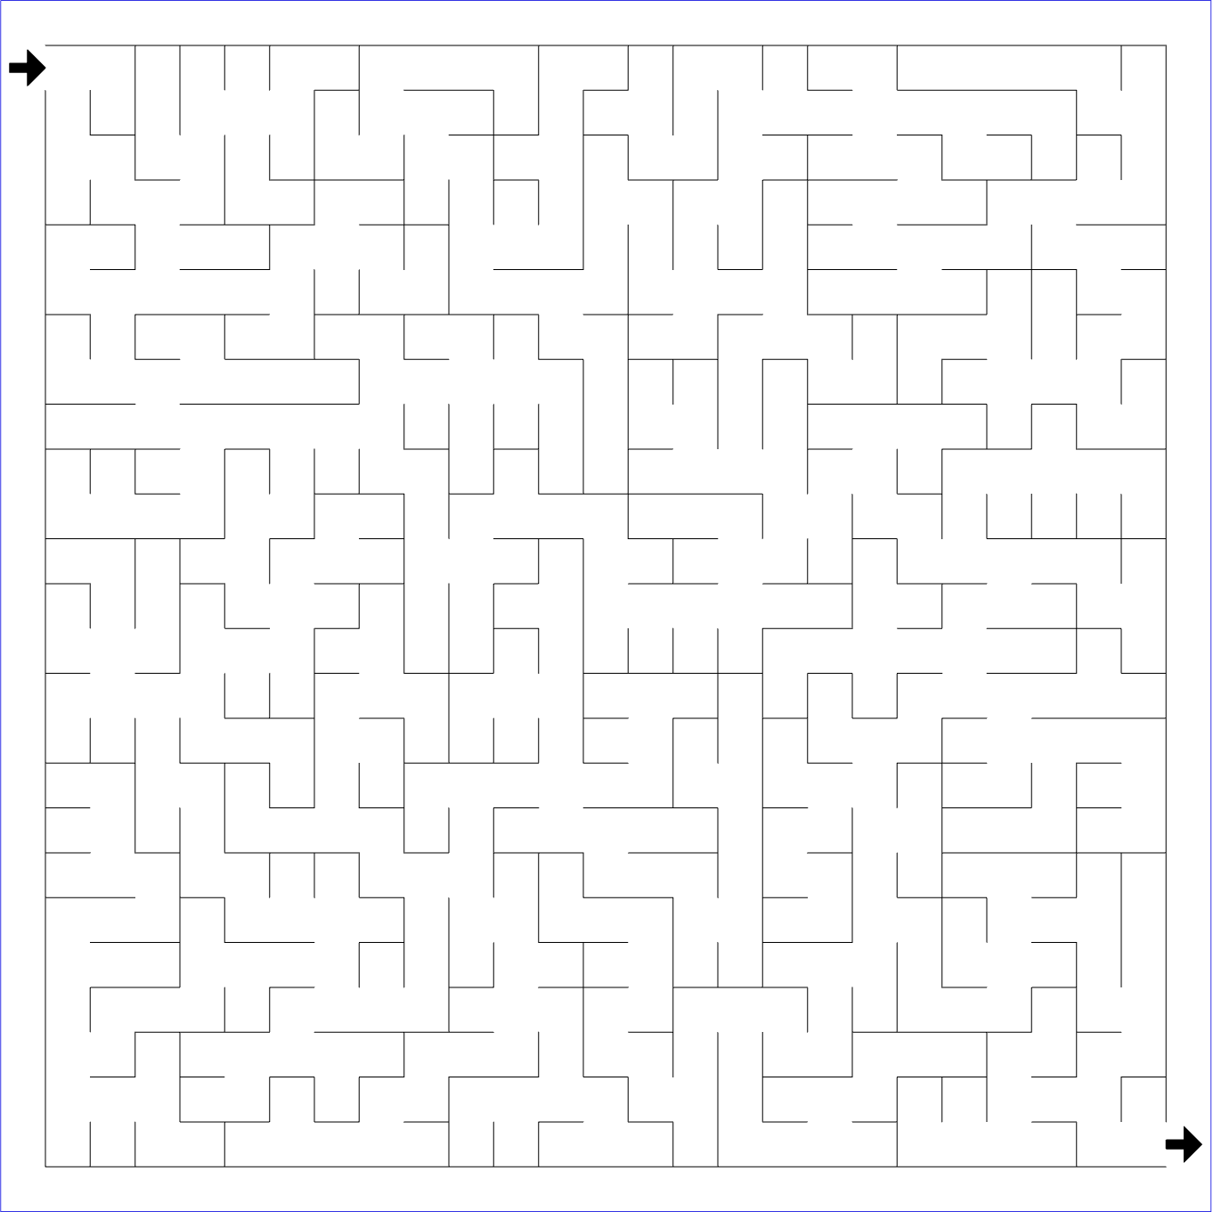
art/MazeGenerator-IsaacWu/snapshots/snapshot0.png
