3XAY/aPeacefulSceneBlot/art/MazeGenerator-IsaacWu/snapshots/snapshot1.png

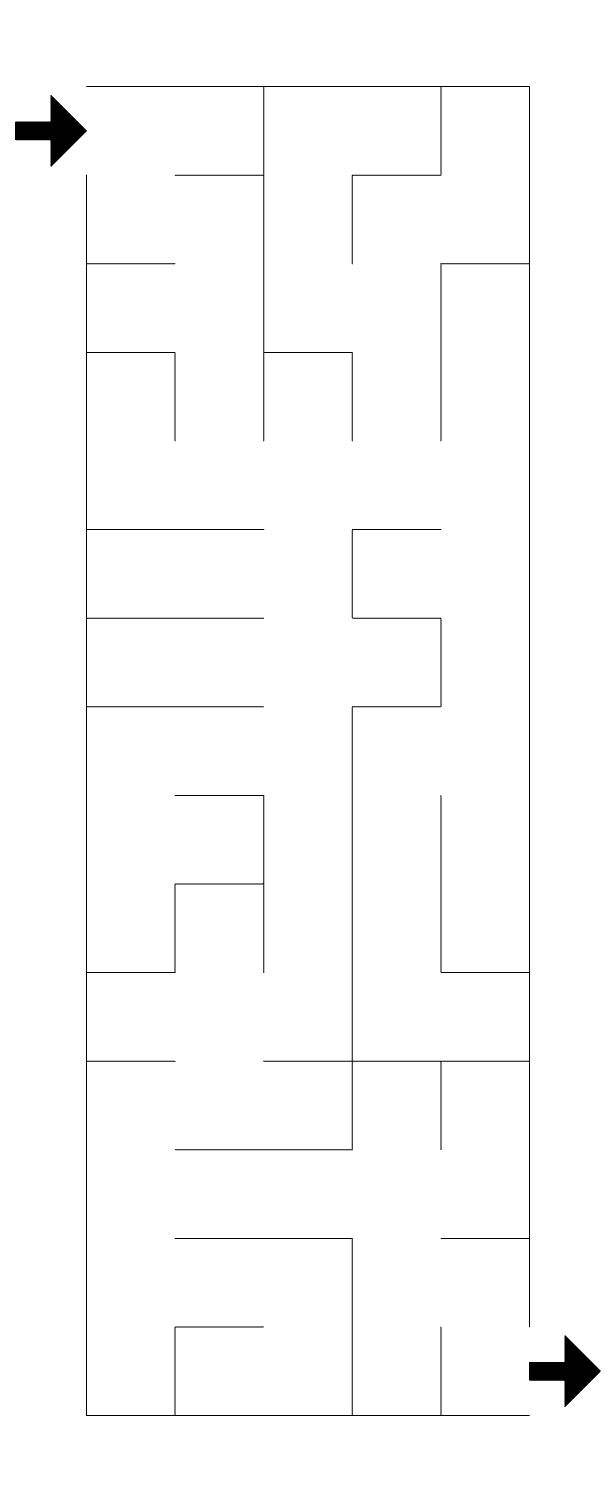
art/MazeGenerator-IsaacWu/snapshots/snapshot1.png
