3XAY/aPeacefulSceneBlot/art/Metal_Gear_Solid_Codec-Avyan/snapshots/Heroes.jpg

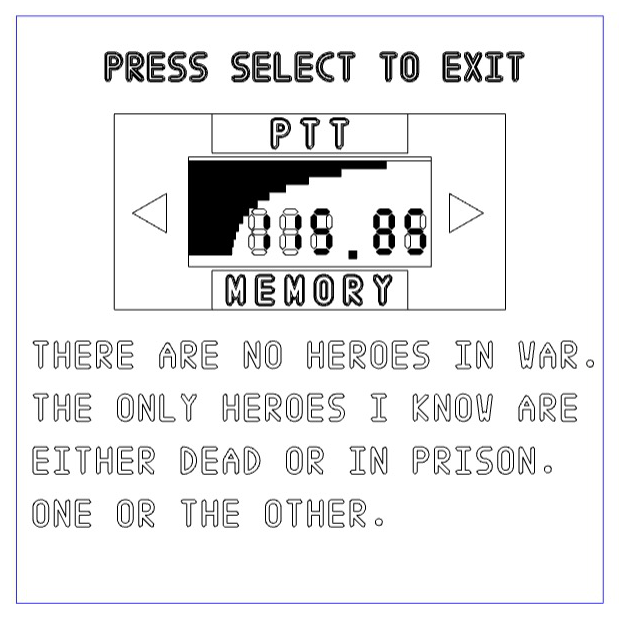
art/Metal_Gear_Solid_Codec-Avyan/snapshots/Heroes.jpg
