3XAY/aPeacefulSceneBlot/art/Minesweeper-LiterallyEverything/snapshots/image3.png

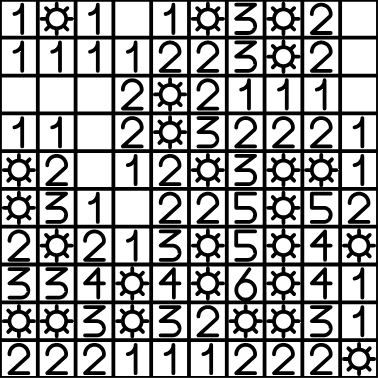
art/Minesweeper-LiterallyEverything/snapshots/image3.png
