3XAY/aPeacefulSceneBlot/art/MoonlitRoad-Ben/snapshots/2.PNG

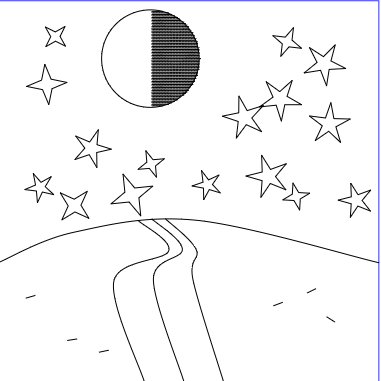
art/MoonlitRoad-Ben/snapshots/2.PNG
