3XAY/aPeacefulSceneBlot/art/nightLandscape-Yancheng/snapshots/snapshot3.png

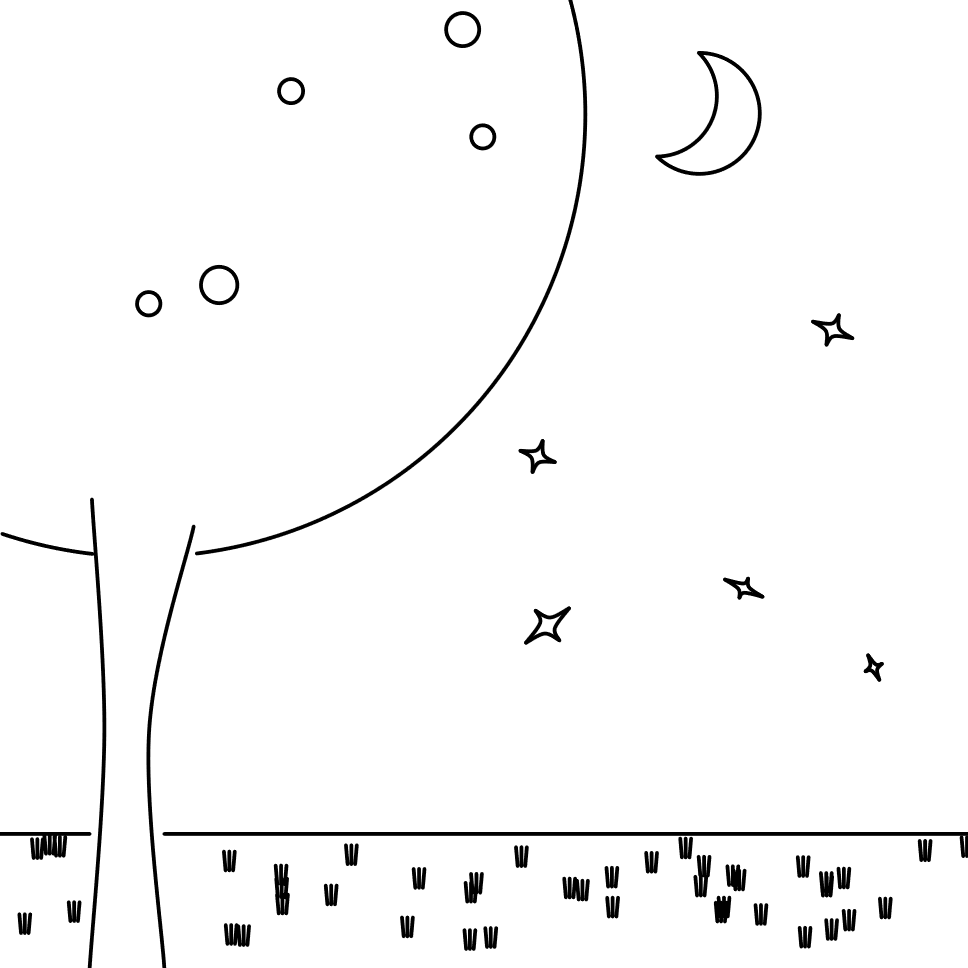
art/nightLandscape-Yancheng/snapshots/snapshot3.png
