3XAY/aPeacefulSceneBlot/art/Ocean-dkim19375/snapshots/snapshot0.png

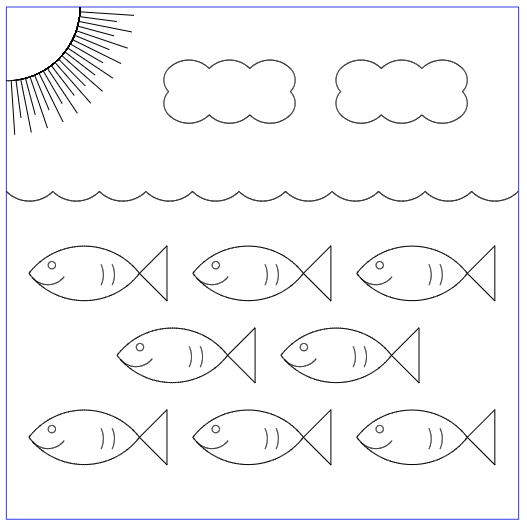
art/Ocean-dkim19375/snapshots/snapshot0.png
