3XAY/aPeacefulSceneBlot/art/Ocean-dkim19375/snapshots/snapshot2.png

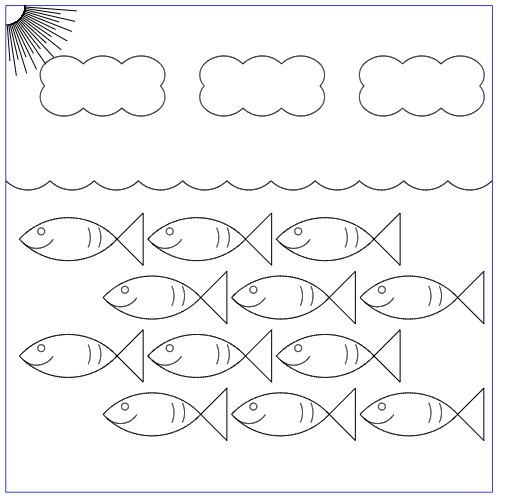
art/Ocean-dkim19375/snapshots/snapshot2.png
