3XAY/aPeacefulSceneBlot/art/optical-illusion-Sajeg/snapshots/image0.png

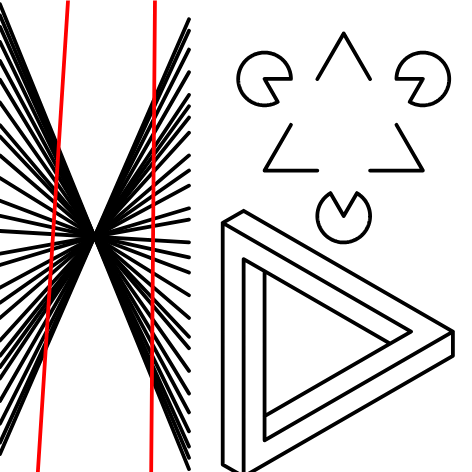
art/optical-illusion-Sajeg/snapshots/image0.png
