3XAY/aPeacefulSceneBlot/art/optical-illusion-Sajeg/snapshots/image1.png

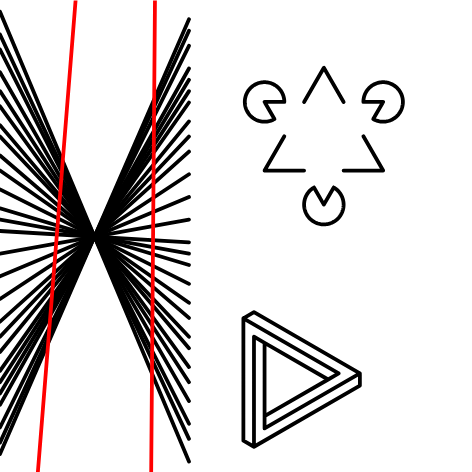
art/optical-illusion-Sajeg/snapshots/image1.png
