3XAY/aPeacefulSceneBlot/art/optical-illusion-Sajeg/snapshots/image2.png

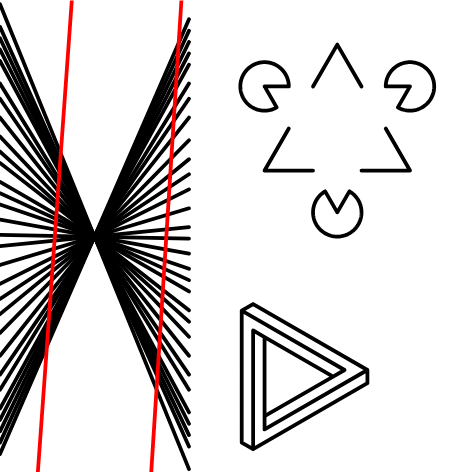
art/optical-illusion-Sajeg/snapshots/image2.png
