3XAY/aPeacefulSceneBlot/art/outer_space-Loewe111/snapshots/snapshot2.png

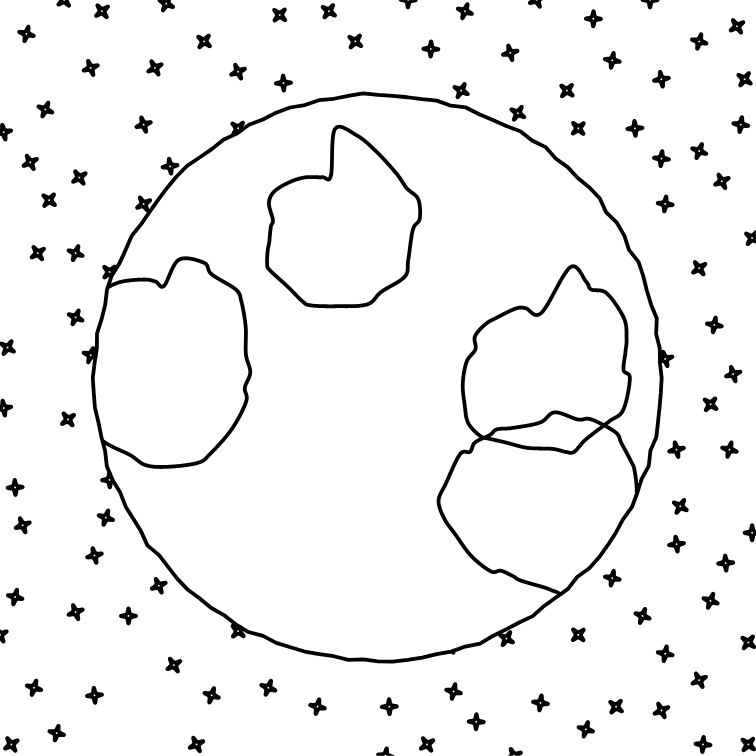
art/outer_space-Loewe111/snapshots/snapshot2.png
