3XAY/aPeacefulSceneBlot/art/palmTree-Daniel/snapshots/image3.png

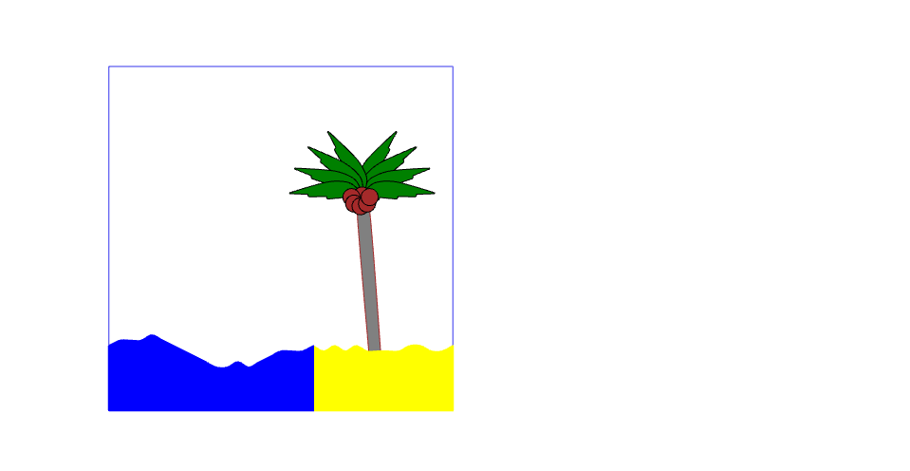
art/palmTree-Daniel/snapshots/image3.png
