3XAY/aPeacefulSceneBlot/art/PaperCrunch.io-Shaunak/snapshots/snapshot0.png

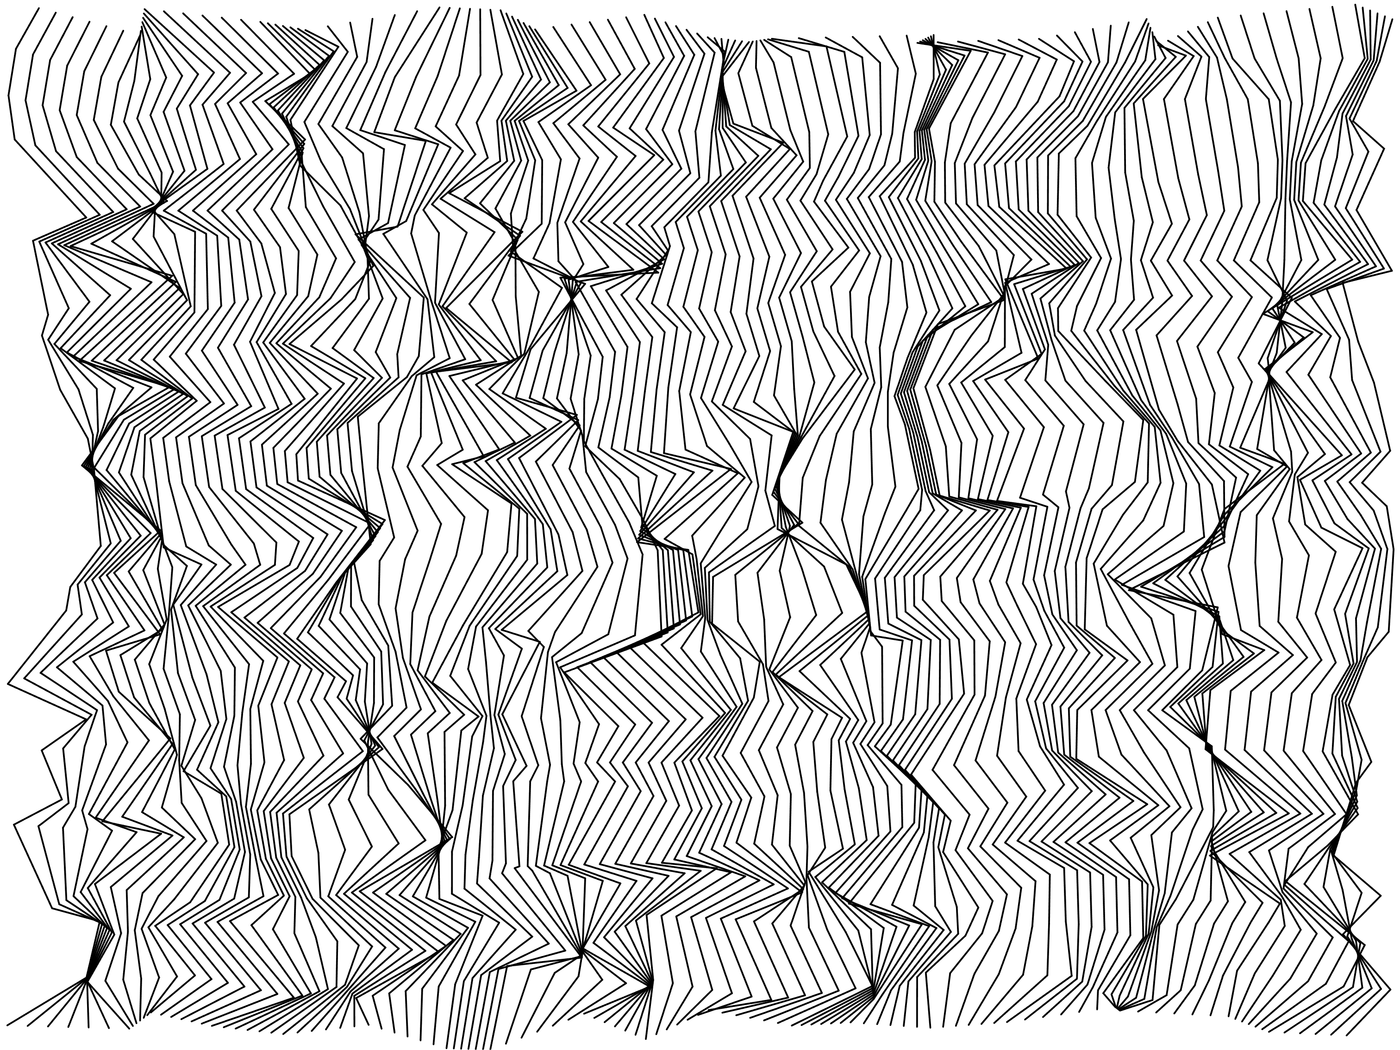
art/PaperCrunch.io-Shaunak/snapshots/snapshot0.png
