3XAY/aPeacefulSceneBlot/art/PaperCrunch.io-Shaunak/snapshots/snapshot1.png

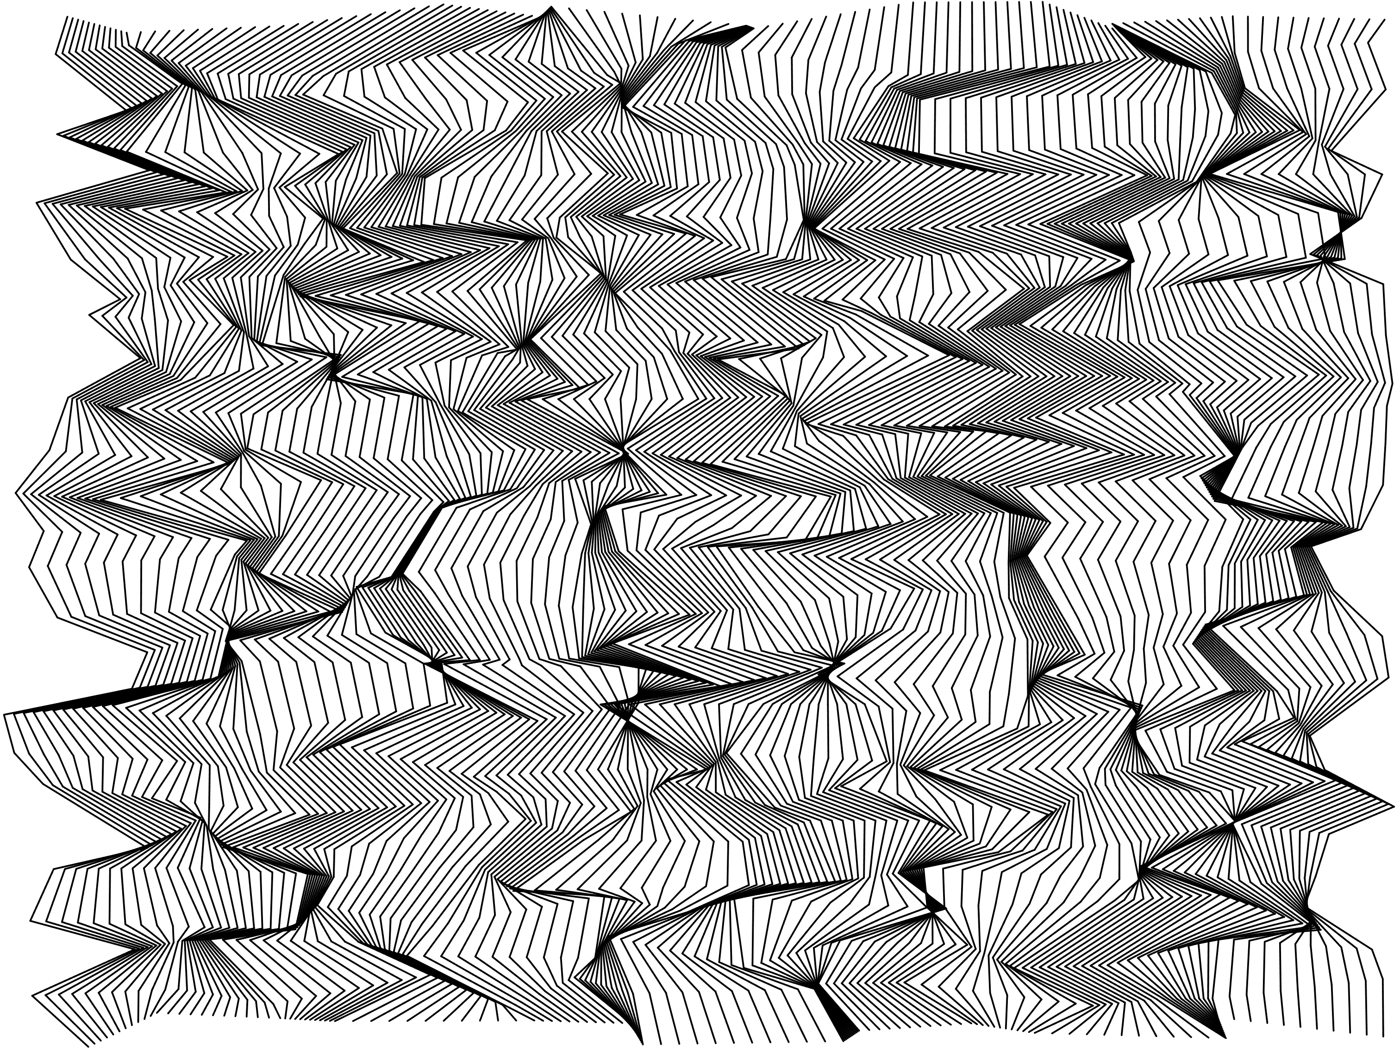
art/PaperCrunch.io-Shaunak/snapshots/snapshot1.png
