3XAY/aPeacefulSceneBlot/art/PaperCrunch.io-Shaunak/snapshots/snapshot2.png

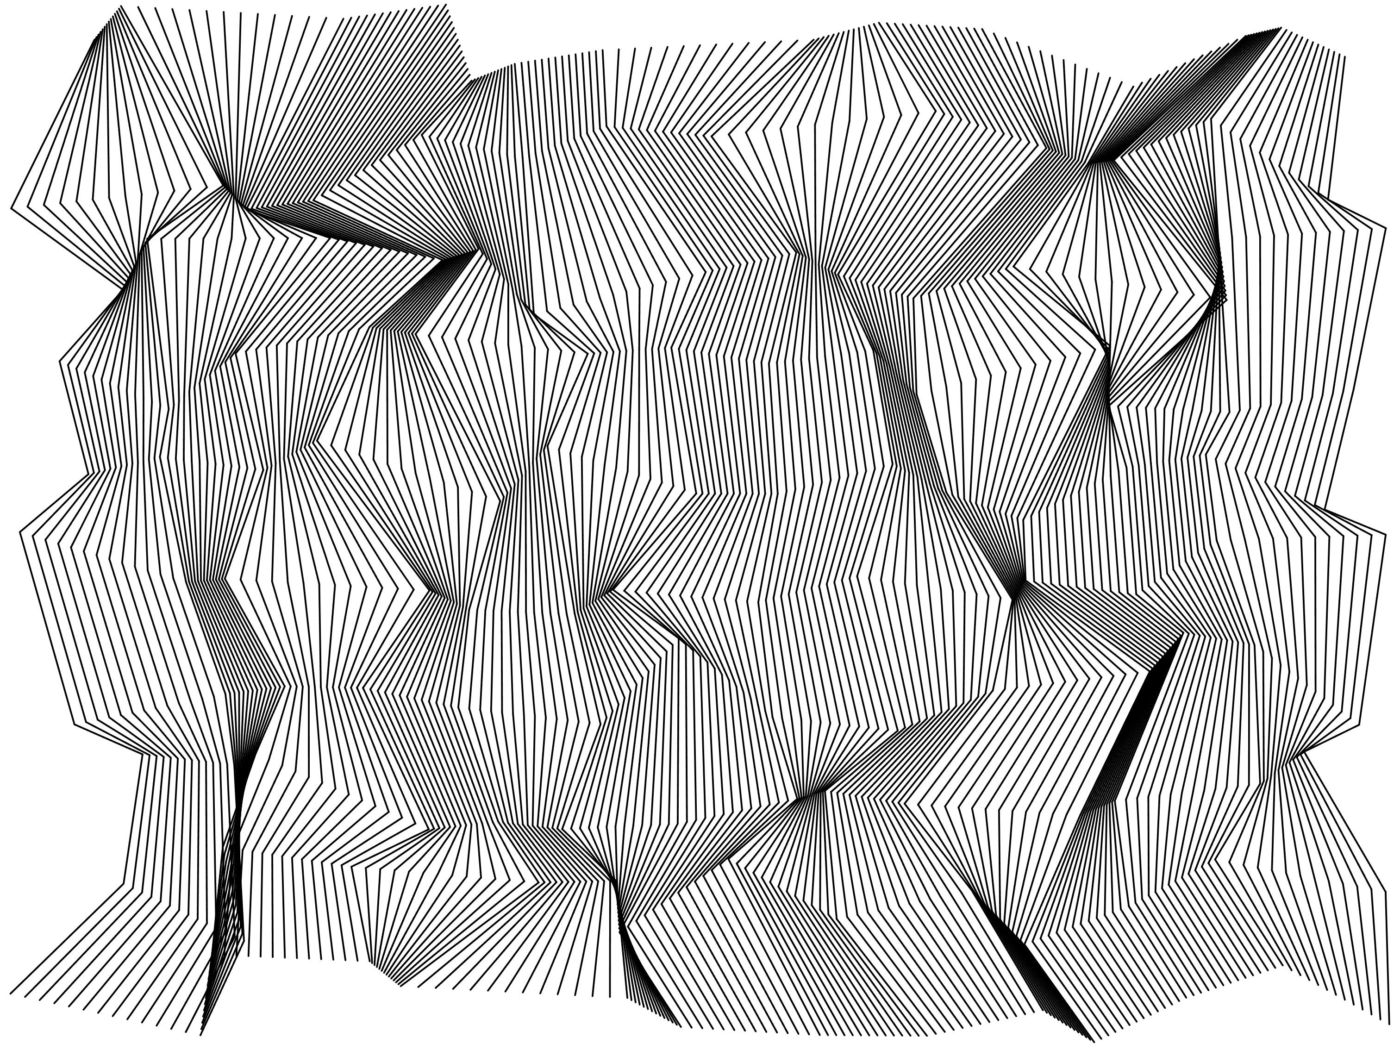
art/PaperCrunch.io-Shaunak/snapshots/snapshot2.png
