3XAY/aPeacefulSceneBlot/art/PartialHatsScenery-Arnav/snapshots/0.png

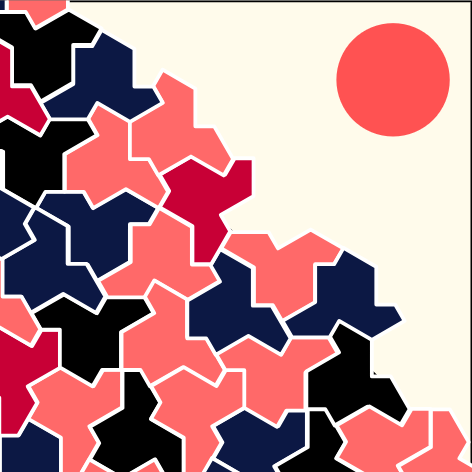
art/PartialHatsScenery-Arnav/snapshots/0.png
