3XAY/aPeacefulSceneBlot/art/PasswordGen/Snapshots/Screenshot 2024-09-16 203122.png

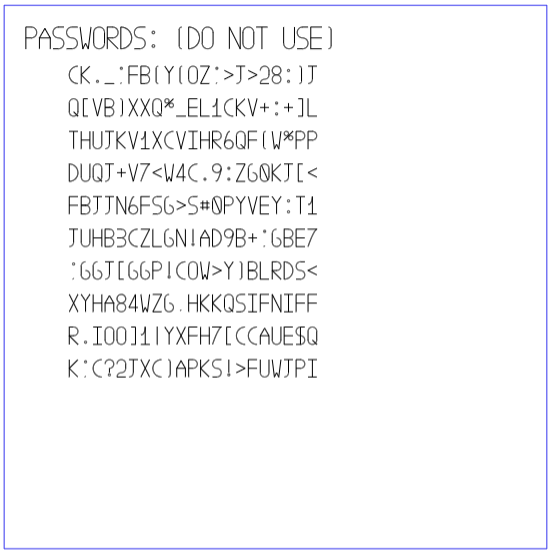
art/PasswordGen/Snapshots/Screenshot 2024-09-16 203122.png
