3XAY/aPeacefulSceneBlot/art/pete_the_cat-AlexRabochii/snapshots/snapshot0.png

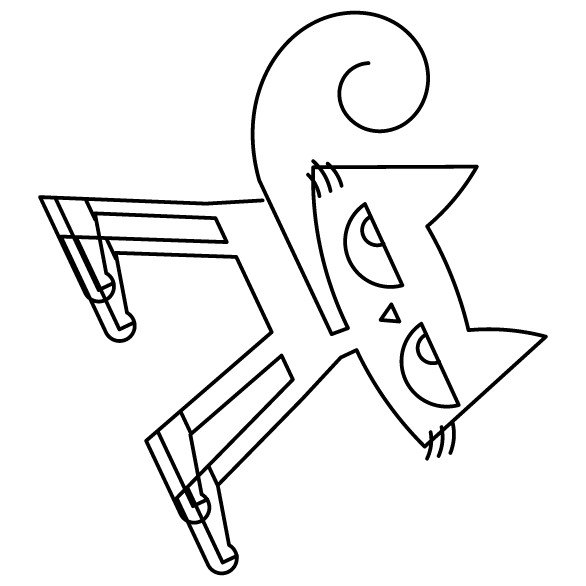
art/pete_the_cat-AlexRabochii/snapshots/snapshot0.png
