3XAY/aPeacefulSceneBlot/art/PokeballShaking-Sriven/snapshots/caught.png

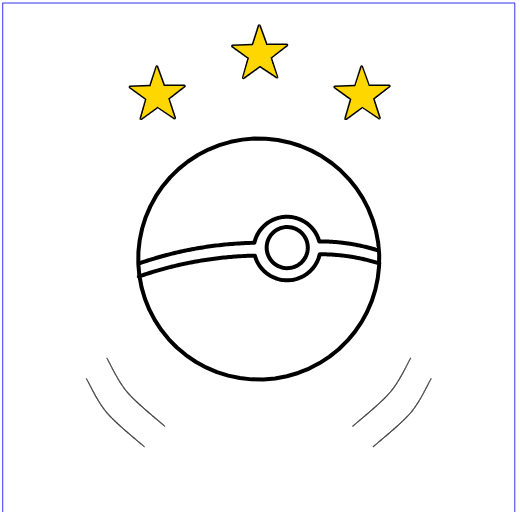
art/PokeballShaking-Sriven/snapshots/caught.png
