3XAY/aPeacefulSceneBlot/art/Pong-Jorge/snapshots/nameOfPicture.png

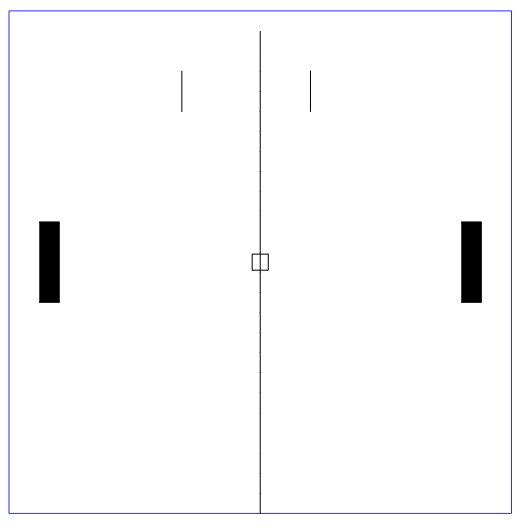
art/Pong-Jorge/snapshots/nameOfPicture.png
