3XAY/aPeacefulSceneBlot/art/Pong-Jorge/snapshots/pong3.png

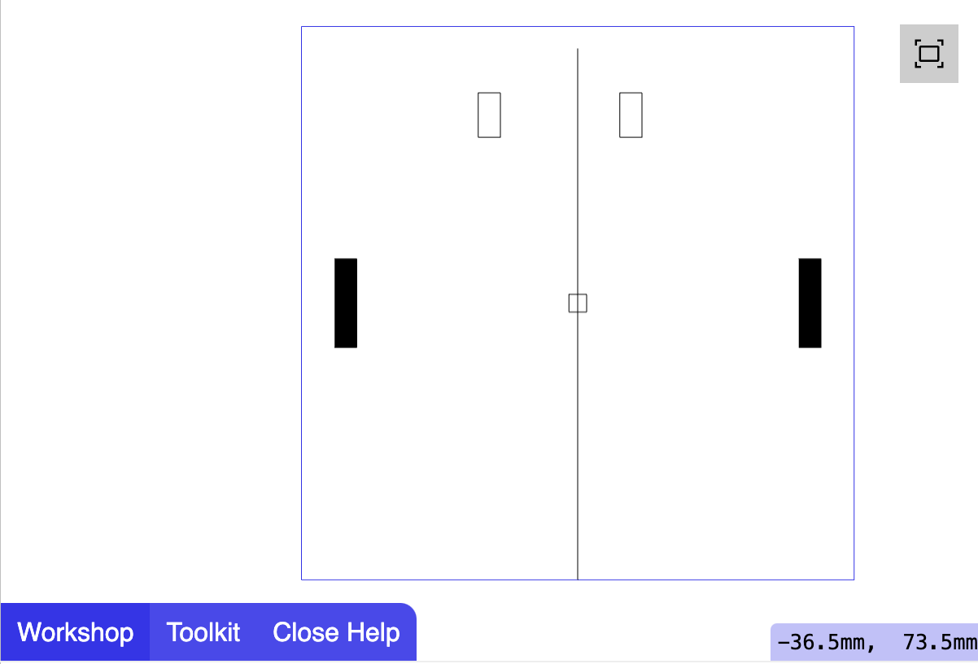
art/Pong-Jorge/snapshots/pong3.png
