3XAY/aPeacefulSceneBlot/art/puzzleGenerator-MaxElder/snapshots/screenshot1.png

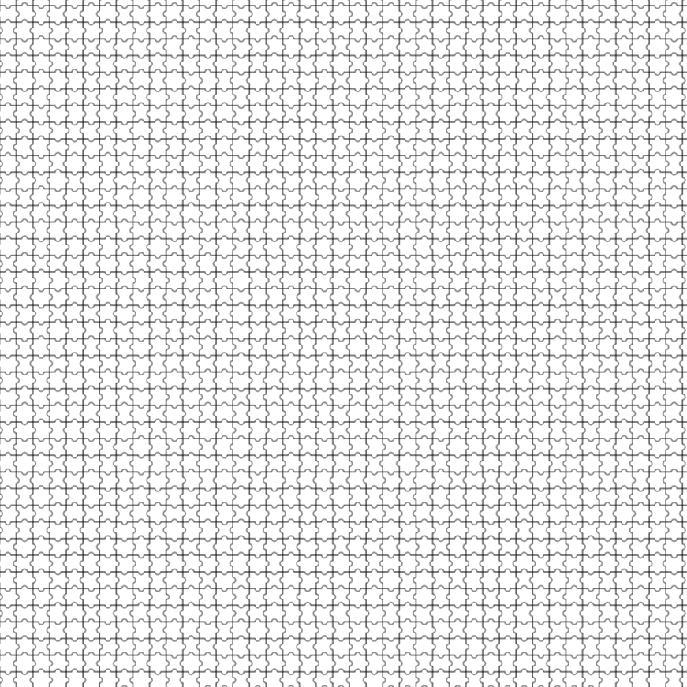
art/puzzleGenerator-MaxElder/snapshots/screenshot1.png
