3XAY/aPeacefulSceneBlot/art/Radio-Neon/snapshots/snapshot3.png

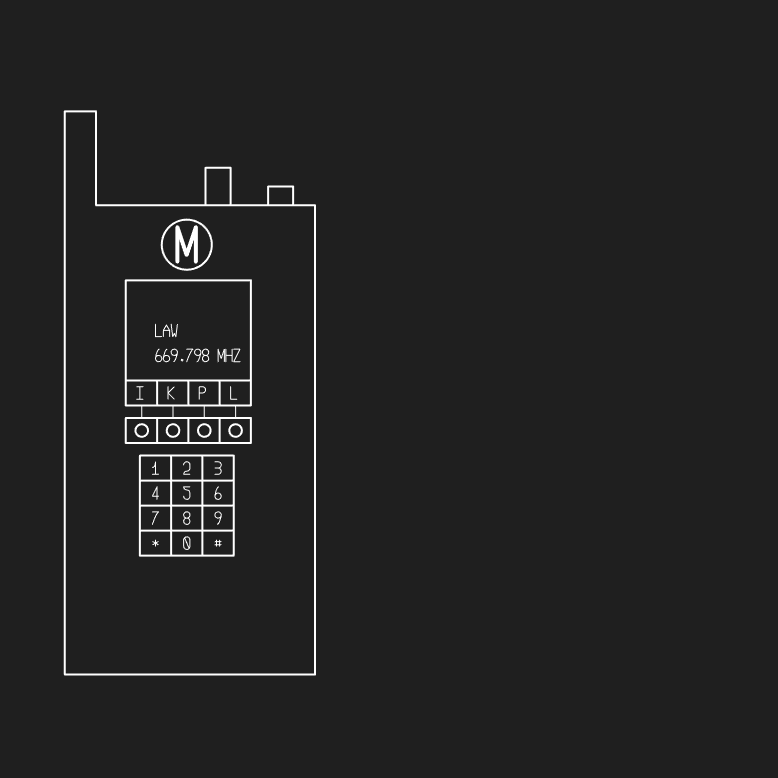
art/Radio-Neon/snapshots/snapshot3.png
