3XAY/aPeacefulSceneBlot/art/ragna-eddie/images/image1.png

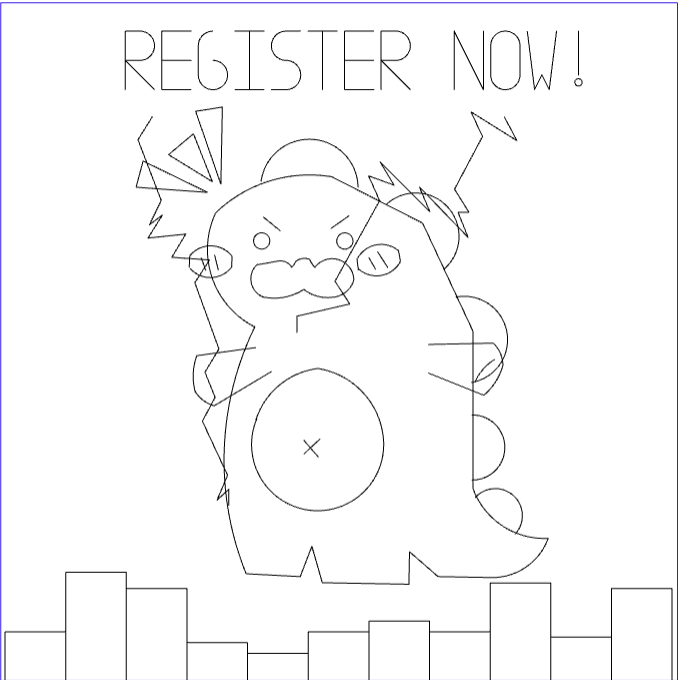
art/ragna-eddie/images/image1.png
