3XAY/aPeacefulSceneBlot/art/ragna-eddie/images/image2.png

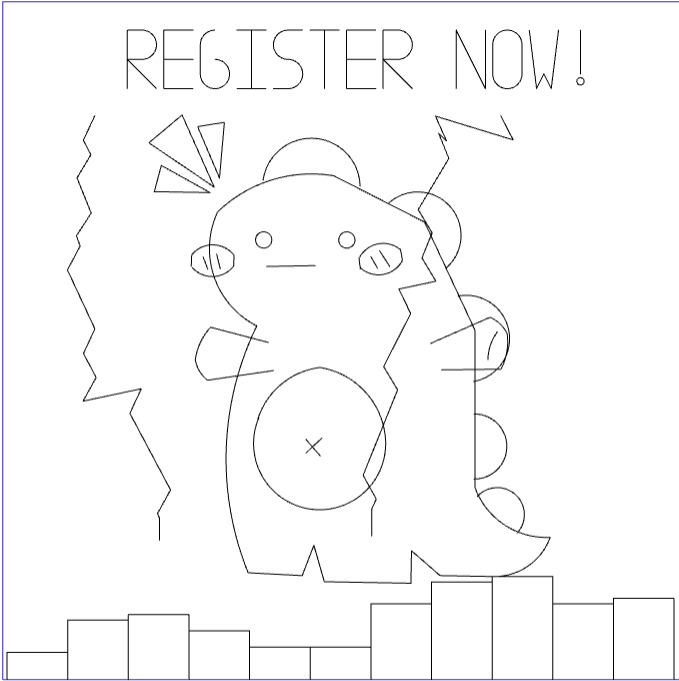
art/ragna-eddie/images/image2.png
