3XAY/aPeacefulSceneBlot/art/ragna-eddie/images/image3.png

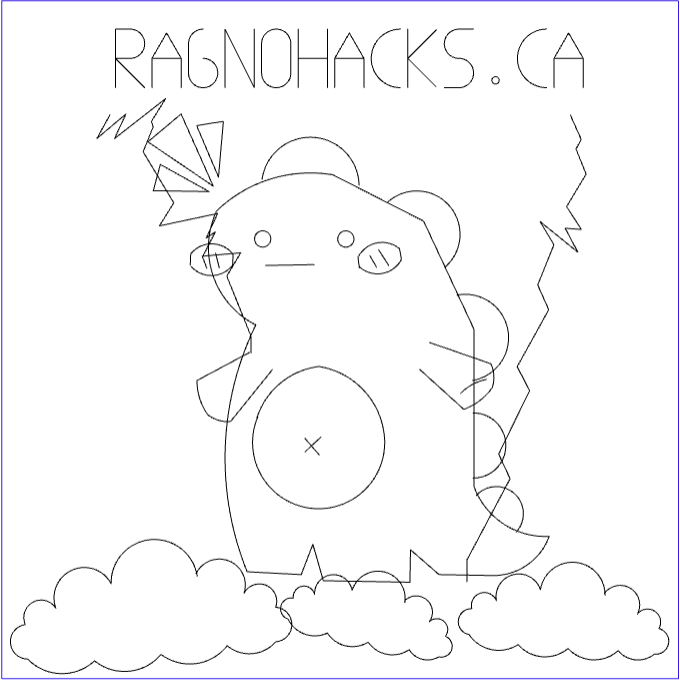
art/ragna-eddie/images/image3.png
