3XAY/aPeacefulSceneBlot/art/raymarching-henry/snapshots/raymarching1.png

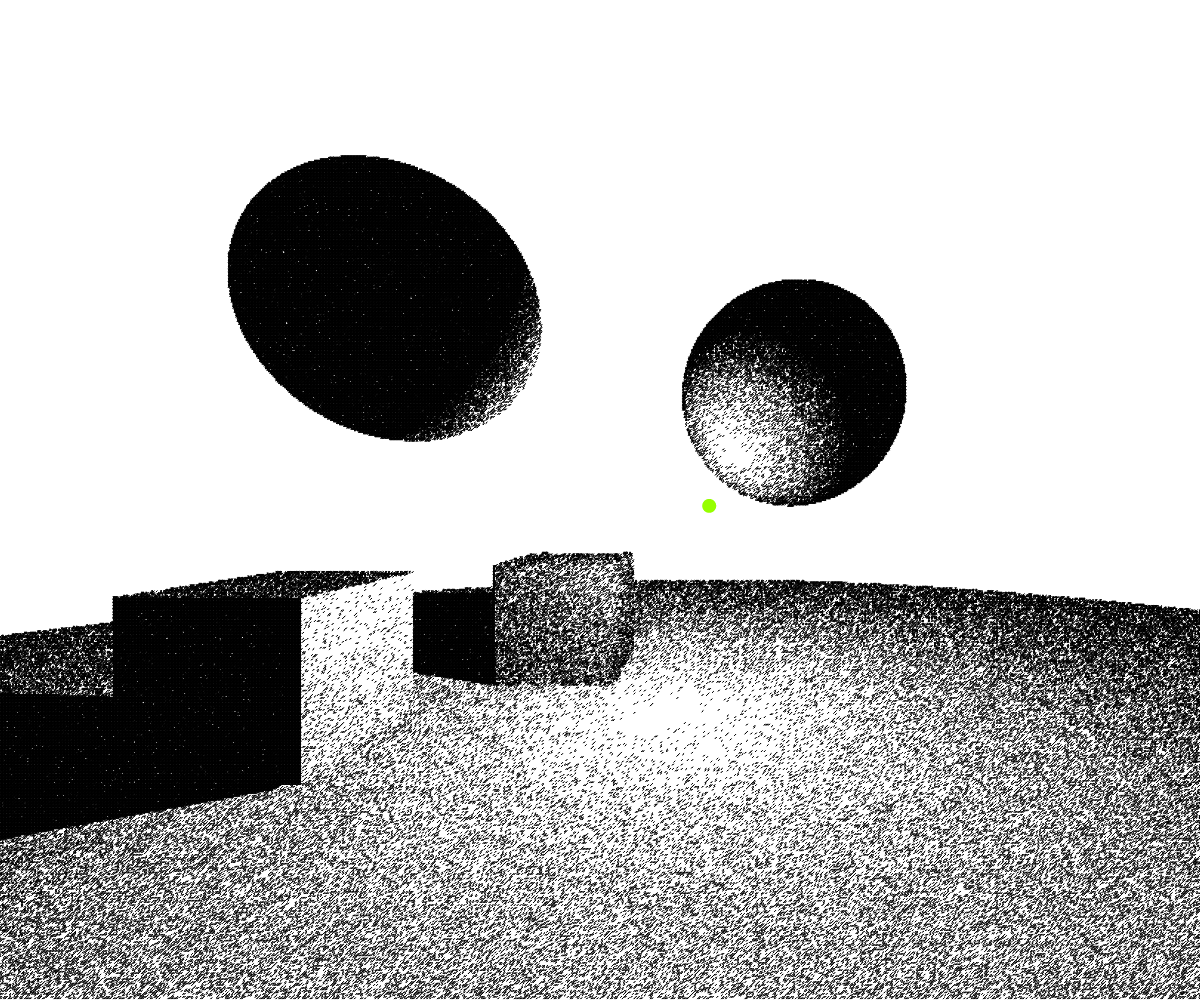
art/raymarching-henry/snapshots/raymarching1.png
