3XAY/aPeacefulSceneBlot/art/RobotClipart-Krishnan/snapshots/image1.png

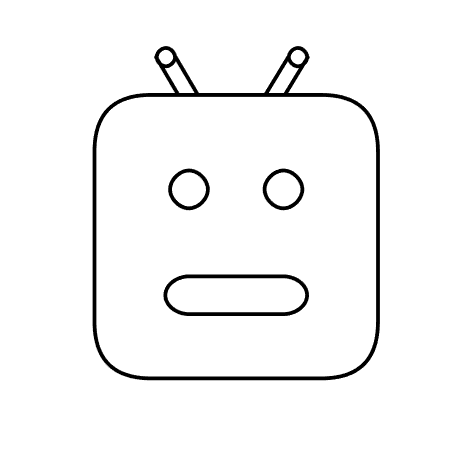
art/RobotClipart-Krishnan/snapshots/image1.png
