3XAY/aPeacefulSceneBlot/art/Royal-Jayden/snapshots/snapshot2.png

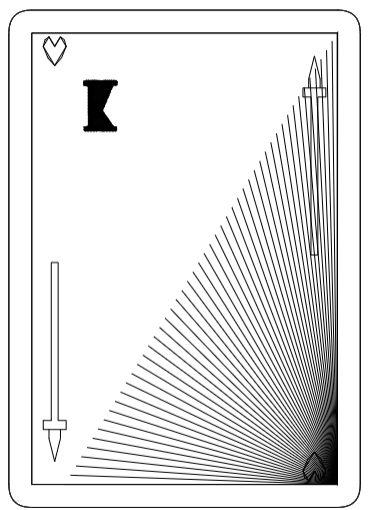
art/Royal-Jayden/snapshots/snapshot2.png
