3XAY/aPeacefulSceneBlot/art/ScannableQRArt-AdrianR3/snapshots/snapshot-3.png

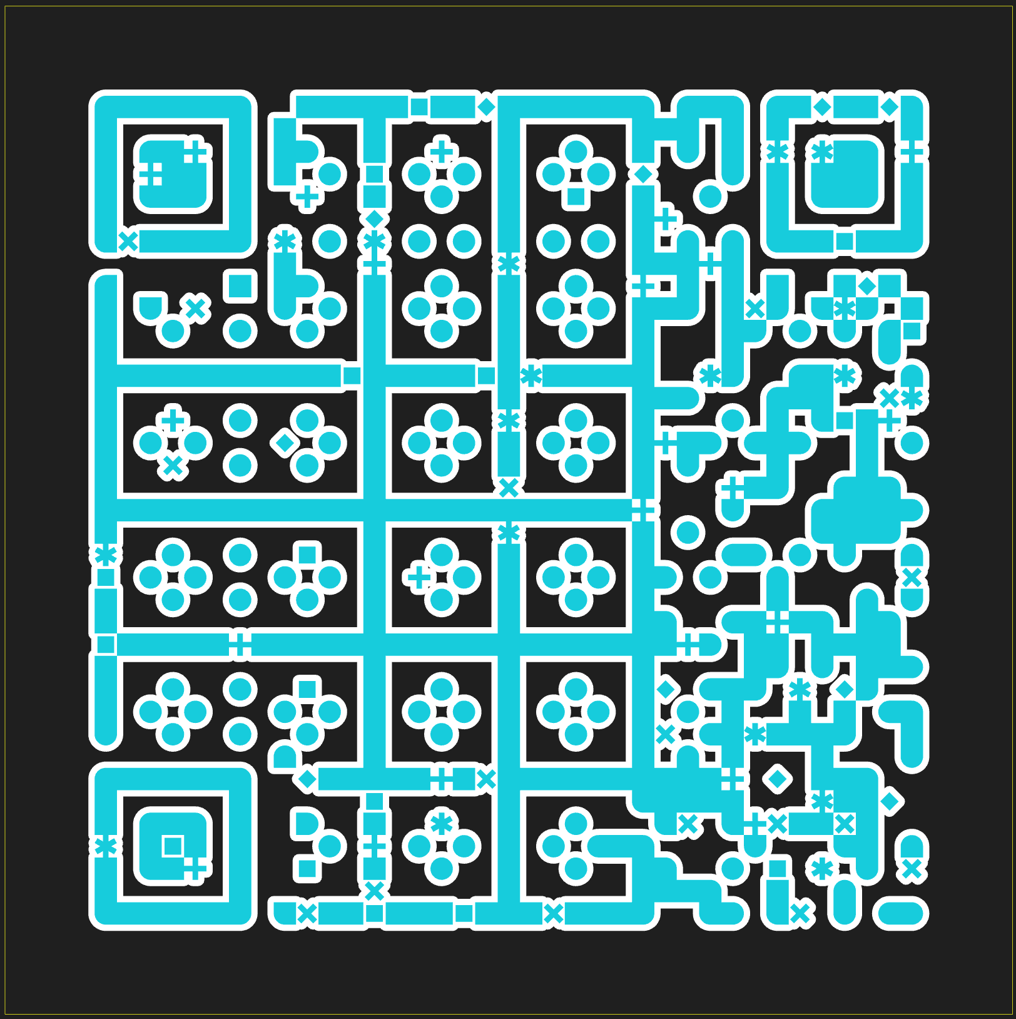
art/ScannableQRArt-AdrianR3/snapshots/snapshot-3.png
