3XAY/aPeacefulSceneBlot/art/self_portrait-kieran/snapshots/snapshot-3.png

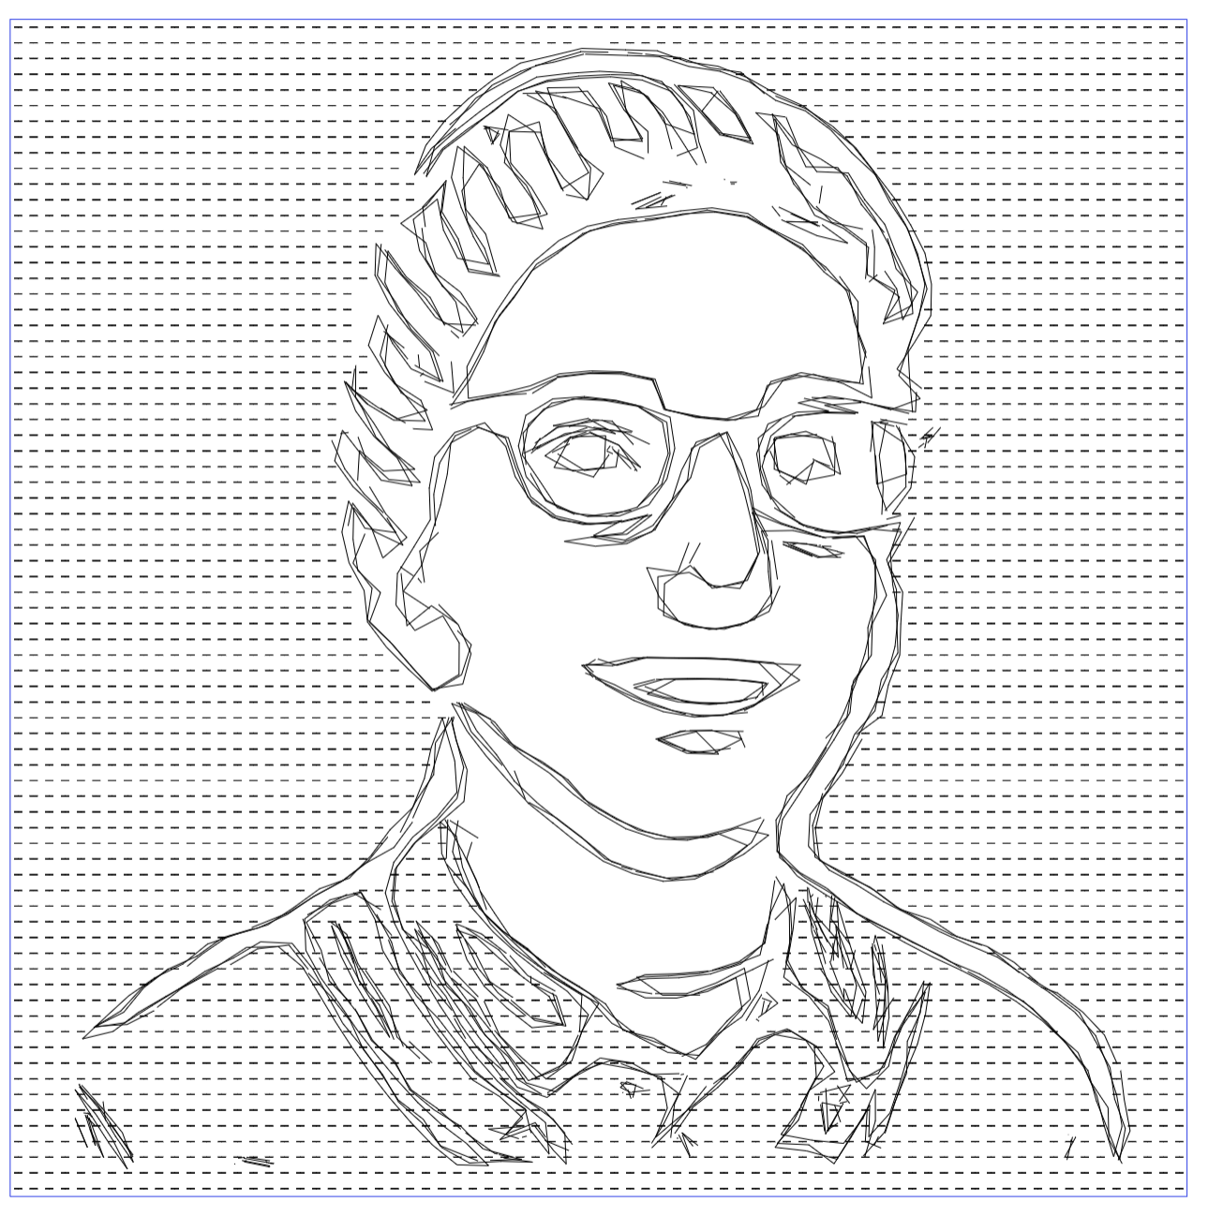
art/self_portrait-kieran/snapshots/snapshot-3.png
