3XAY/aPeacefulSceneBlot/art/shapeGen3D-AliMustafa/snapshots/ShapeGen1.png

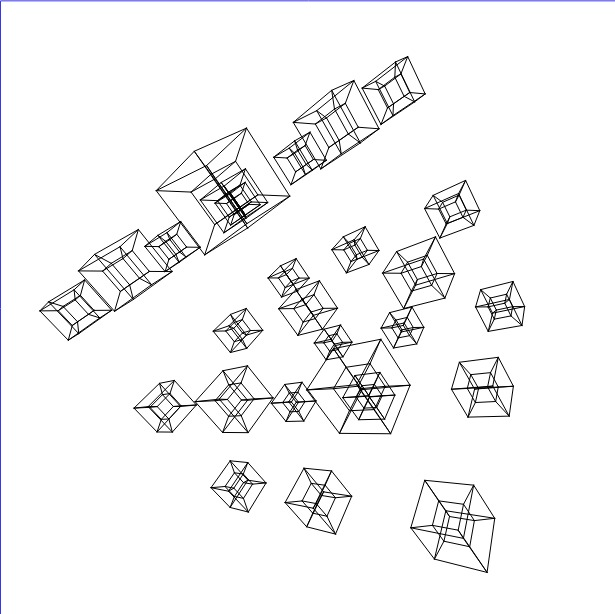
art/shapeGen3D-AliMustafa/snapshots/ShapeGen1.png
