3XAY/aPeacefulSceneBlot/art/sheet_music-nicholasz2510/snapshots/sheet_music3.png

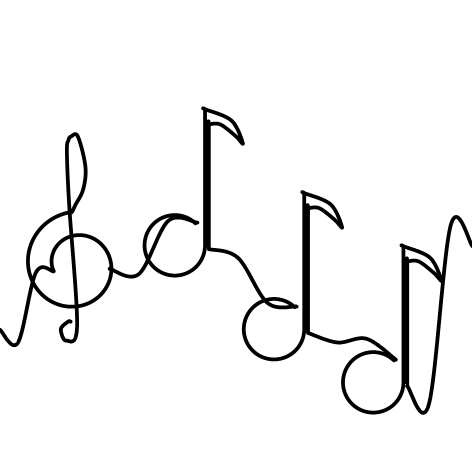
art/sheet_music-nicholasz2510/snapshots/sheet_music3.png
