3XAY/aPeacefulSceneBlot/art/SillyCat-MichaelJ/snapshots/silly_cat3.png

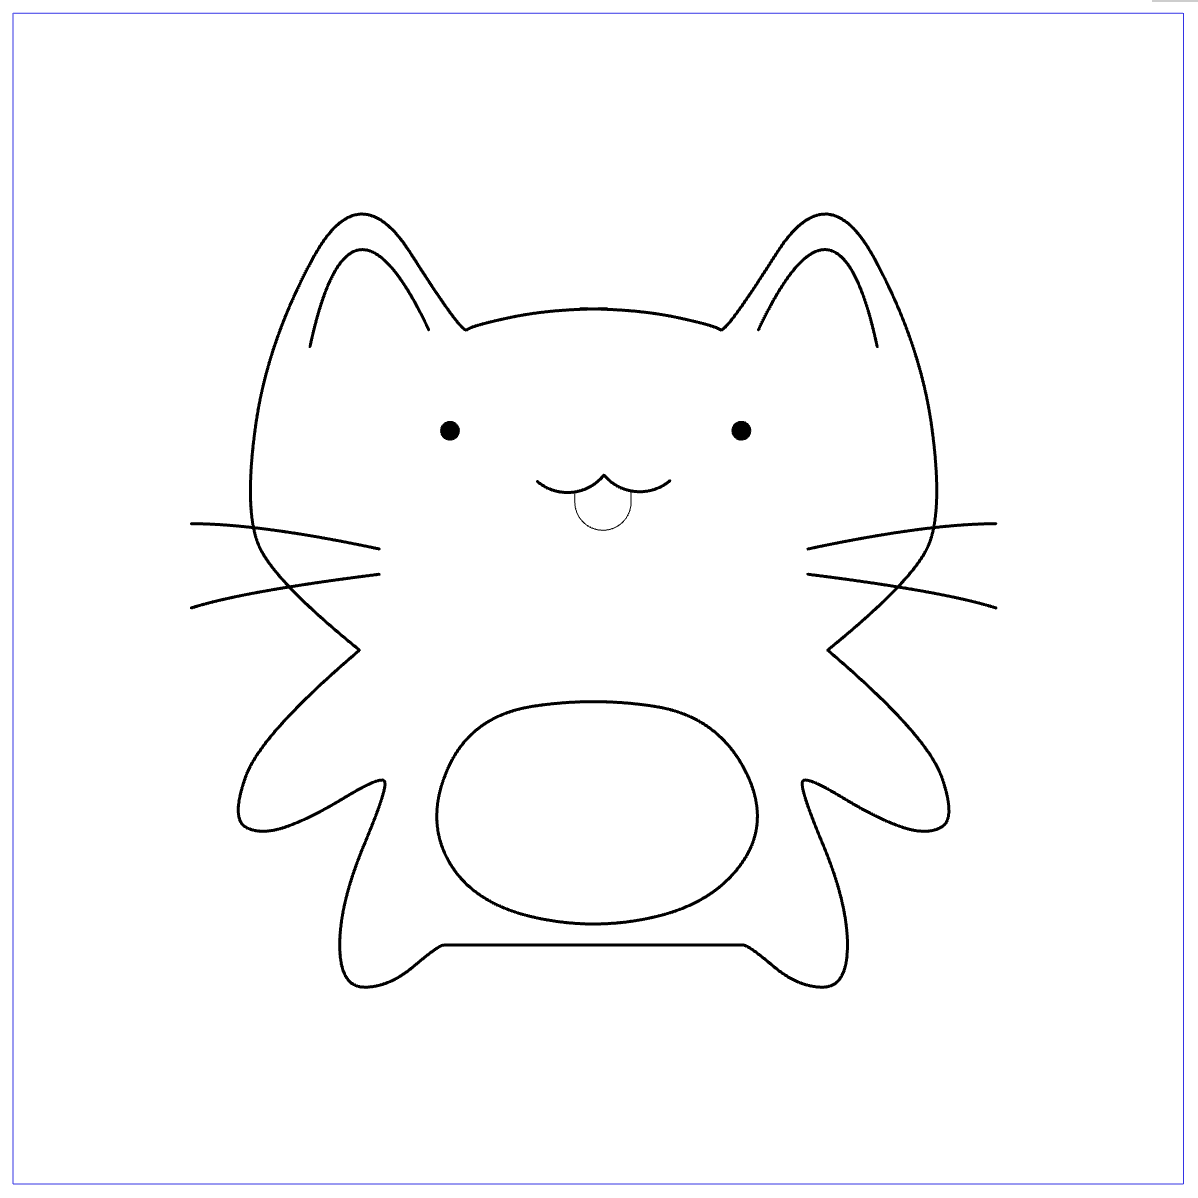
art/SillyCat-MichaelJ/snapshots/silly_cat3.png
