3XAY/aPeacefulSceneBlot/art/SineArt-Ruben/snapshots/bird.png

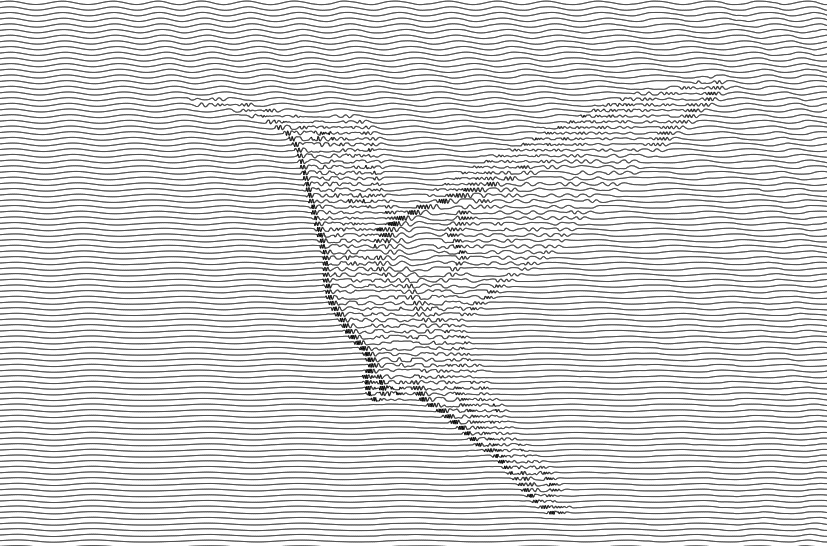
art/SineArt-Ruben/snapshots/bird.png
