3XAY/aPeacefulSceneBlot/art/SpiderWeb-Michelle/snapshots/2.png

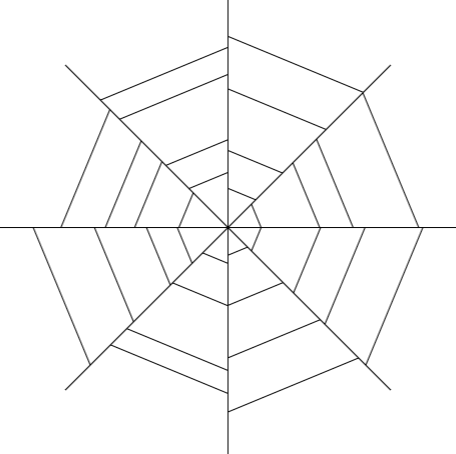
art/SpiderWeb-Michelle/snapshots/2.png
