3XAY/aPeacefulSceneBlot/art/Sunflower-Ofir/snapshots/sunflower1.png

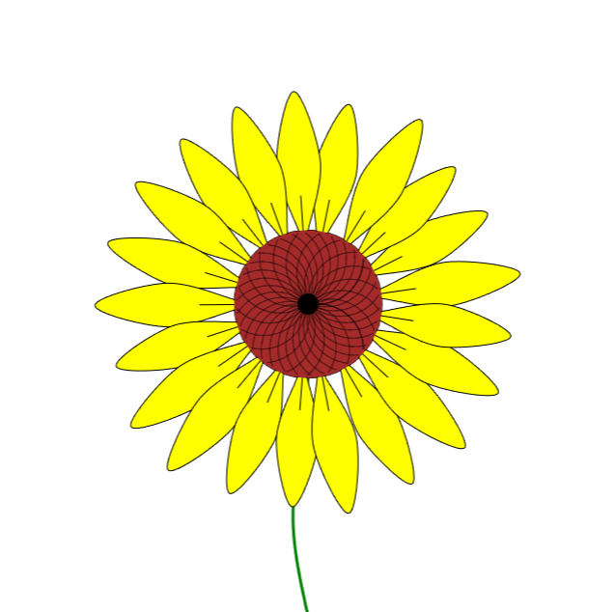
art/Sunflower-Ofir/snapshots/sunflower1.png
