3XAY/aPeacefulSceneBlot/art/tidal-flats-leo-mcelroy/snapshots/3.png

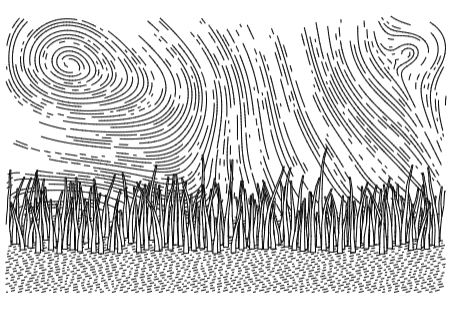
art/tidal-flats-leo-mcelroy/snapshots/3.png
