3XAY/aPeacefulSceneBlot/art/Turtle-Andrew/snapshots/image(8).png

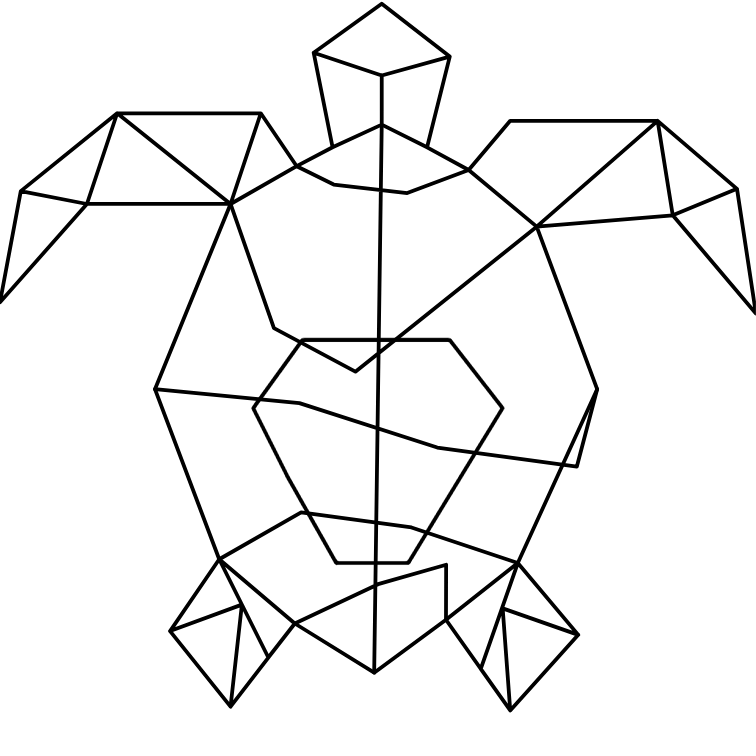
art/Turtle-Andrew/snapshots/image(8).png
