3XAY/aPeacefulSceneBlot/art/usaFlag-gautam/snapshots/snapshot3.png

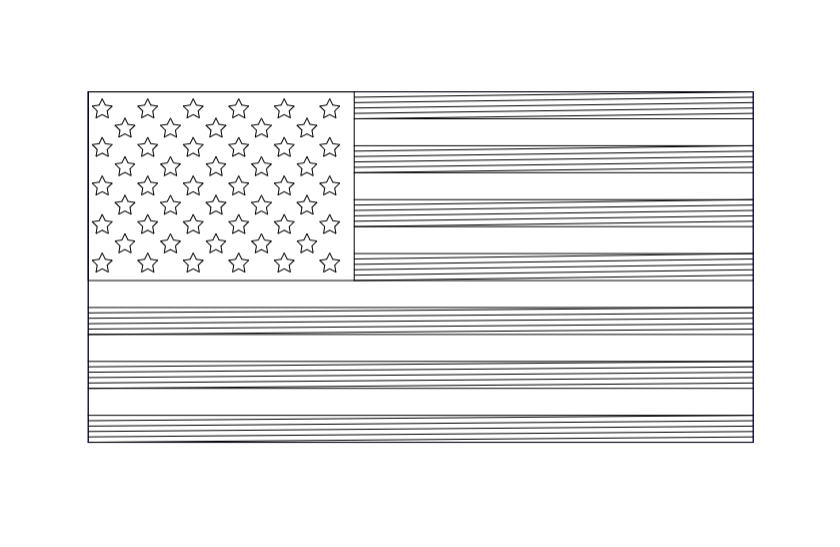
art/usaFlag-gautam/snapshots/snapshot3.png
