3XAY/aPeacefulSceneBlot/art/WaveGrid-Infinity/snapshots/snap_1.png

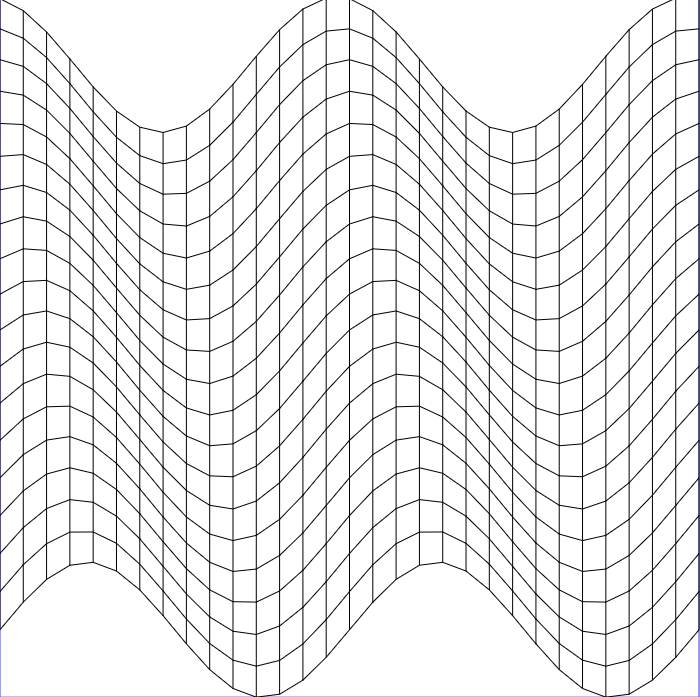
art/WaveGrid-Infinity/snapshots/snap_1.png
