3XAY/aPeacefulSceneBlot/art/weatherreport-rivques/snapshots/weatherreport-main.png

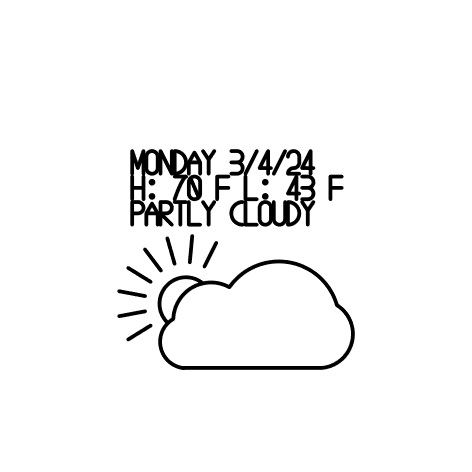
art/weatherreport-rivques/snapshots/weatherreport-main.png
