3XAY/aPeacefulSceneBlot/art/weatherreport-rivques/snapshots/weatherreport-sunshower.png

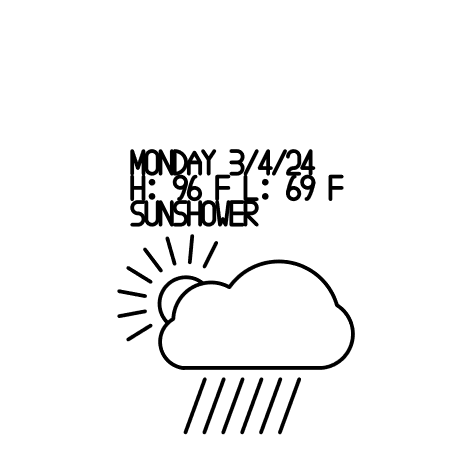
art/weatherreport-rivques/snapshots/weatherreport-sunshower.png
