3XAY/aPeacefulSceneBlot/art/weatherreport-rivques/snapshots/weatherreport-thundersnow.png

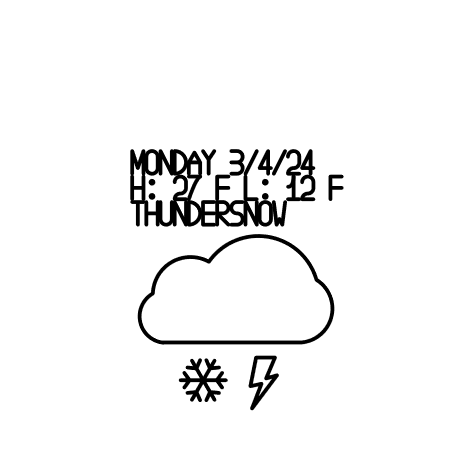
art/weatherreport-rivques/snapshots/weatherreport-thundersnow.png
