3XAY/aPeacefulSceneBlot/art/word_search-scott_c/snapshots/snapshot03.png

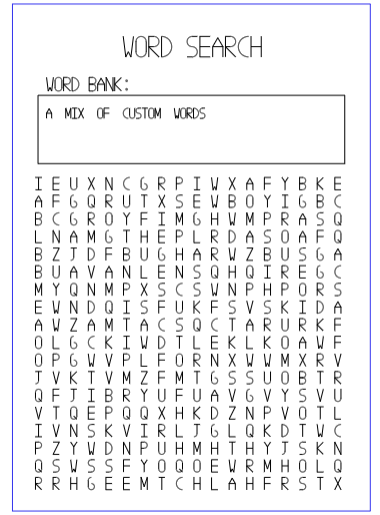
art/word_search-scott_c/snapshots/snapshot03.png
