3XAY/aPeacefulSceneBlot/docs/lesson/assets/base-editor.png

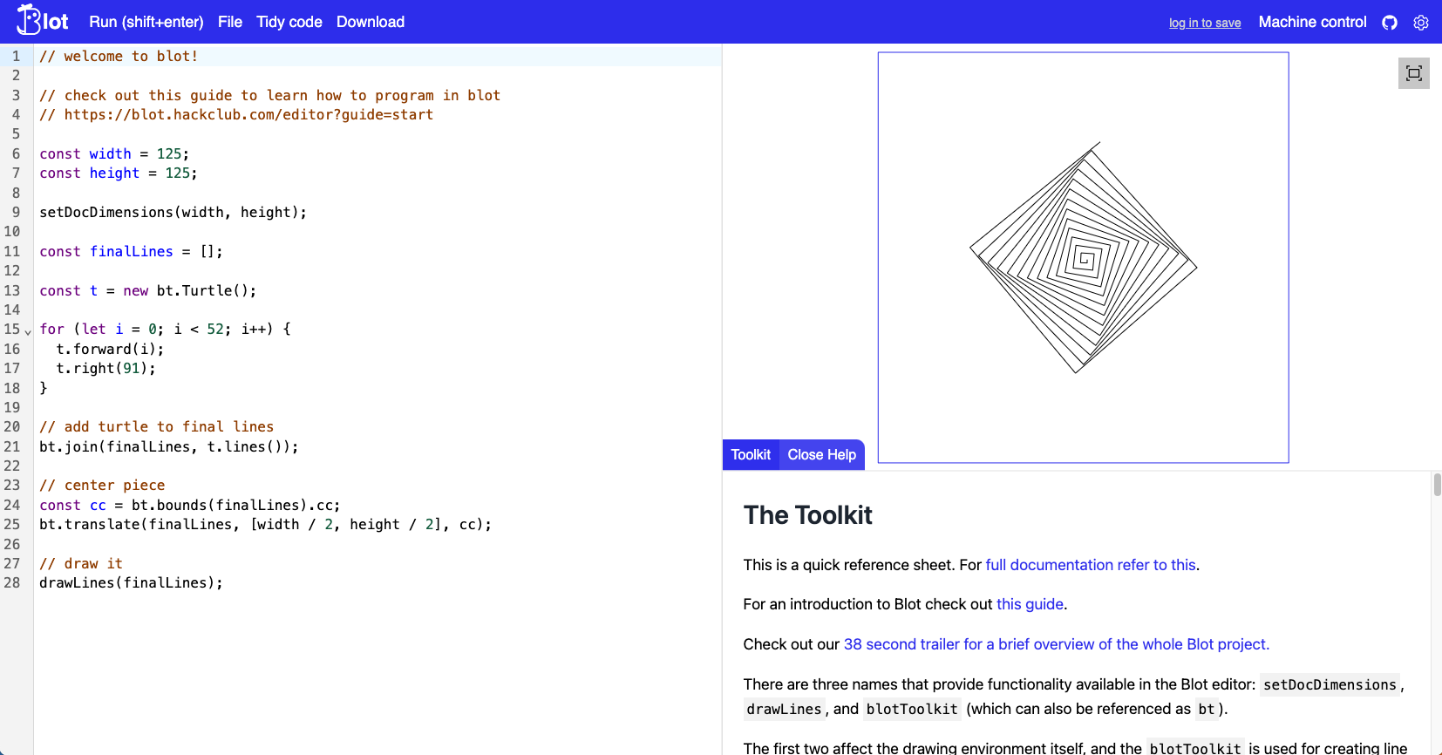
docs/lesson/assets/base-editor.png
