3XAY/aPeacefulSceneBlot/docs/lesson/assets/center-button.png

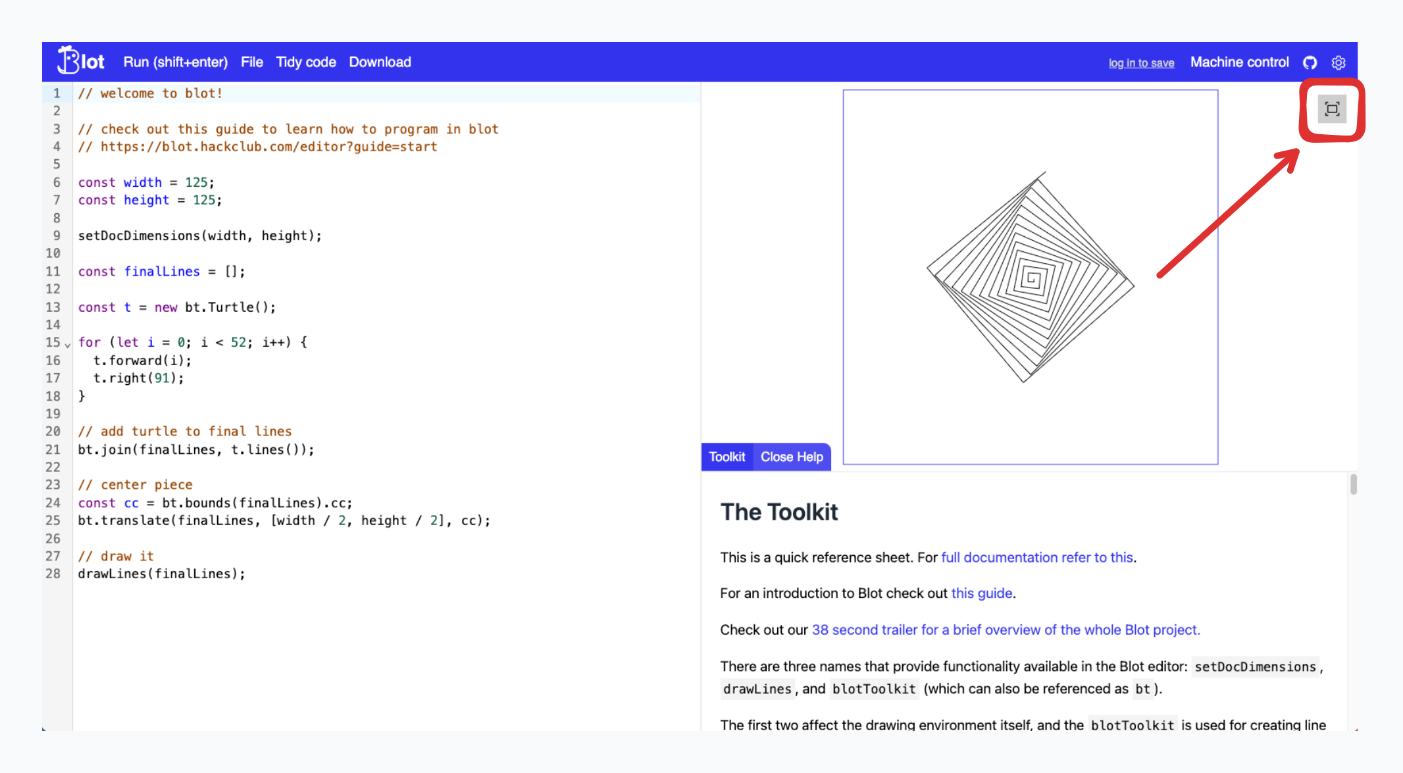
docs/lesson/assets/center-button.png
