3XAY/aPeacefulSceneBlot/docs/lesson/assets/editor.png

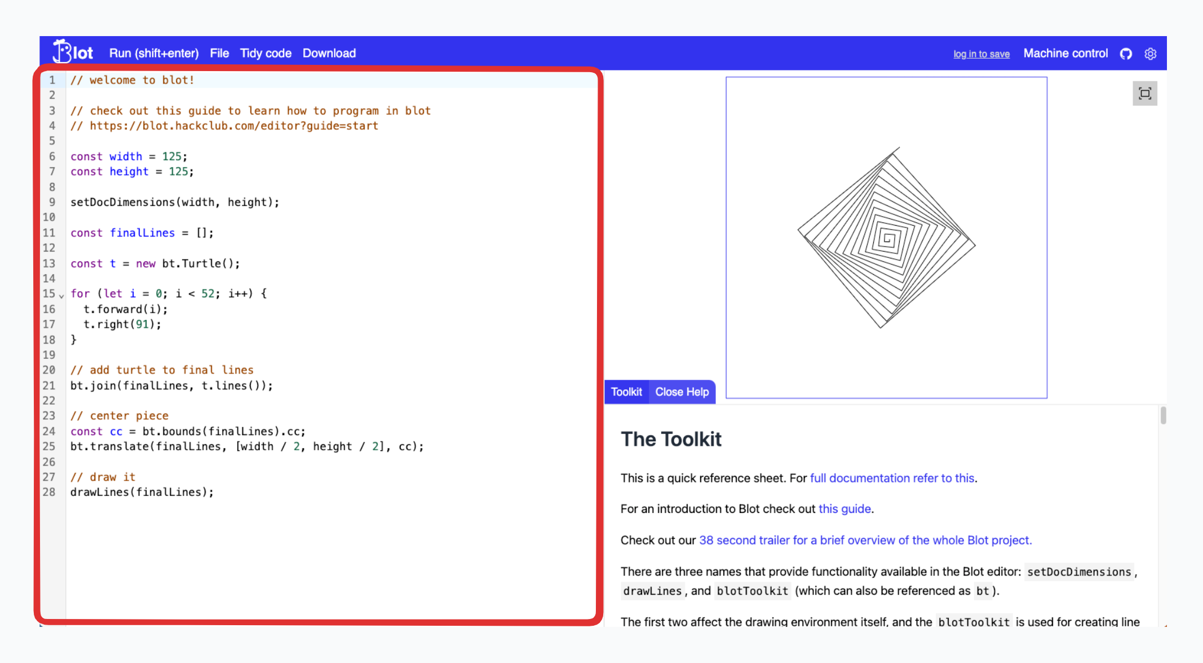
docs/lesson/assets/editor.png
