3XAY/aPeacefulSceneBlot/docs/lesson/assets/feathers.png

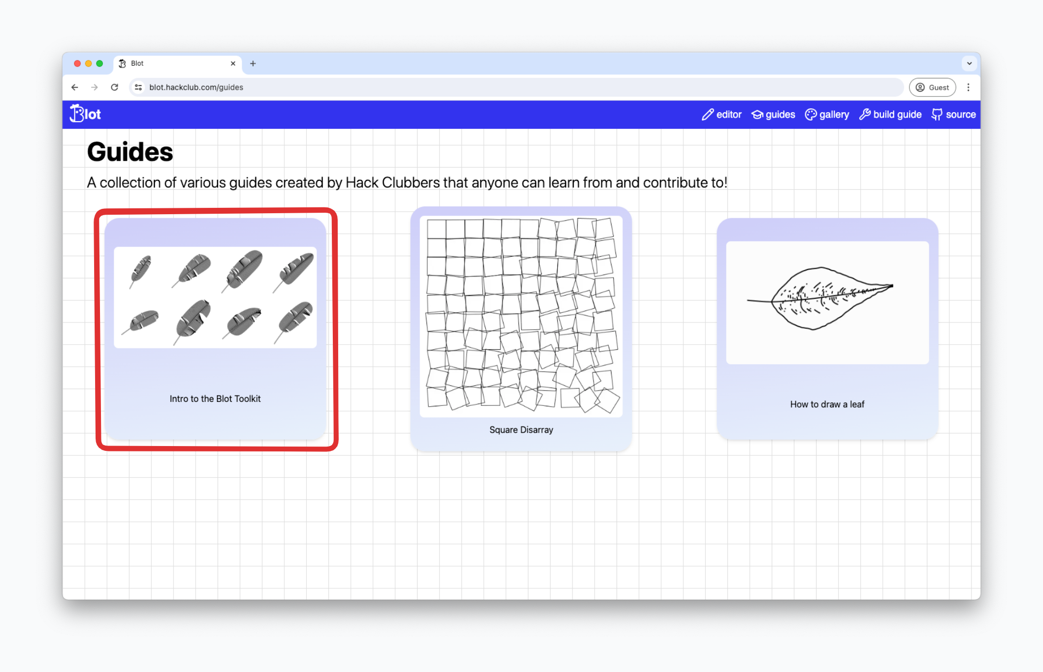
docs/lesson/assets/feathers.png
