3XAY/aPeacefulSceneBlot/docs/lesson/assets/insta.png

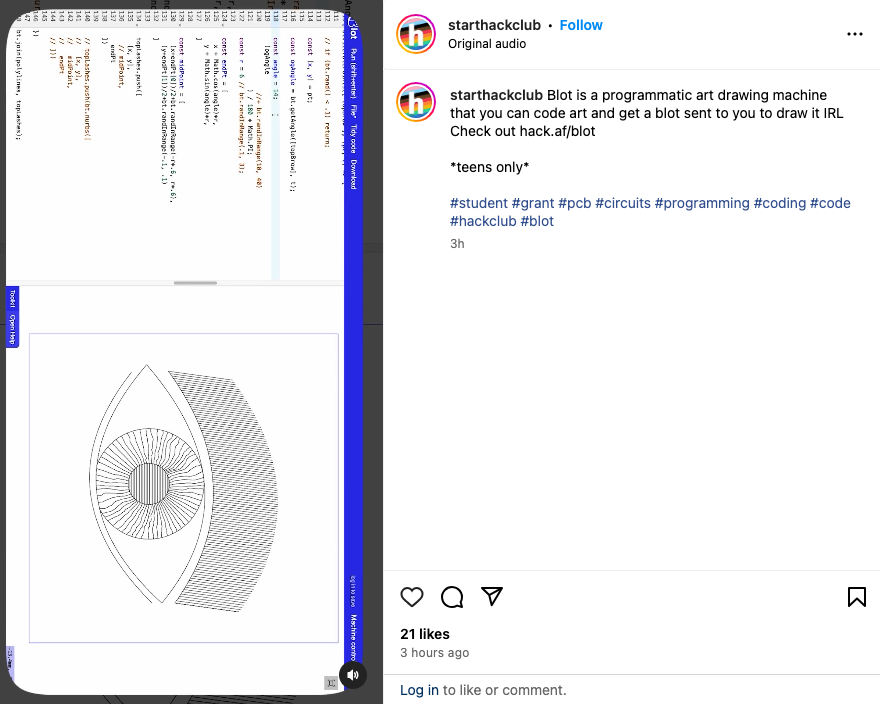
docs/lesson/assets/insta.png
