3XAY/aPeacefulSceneBlot/docs/lesson/assets/intro-to-editor.png

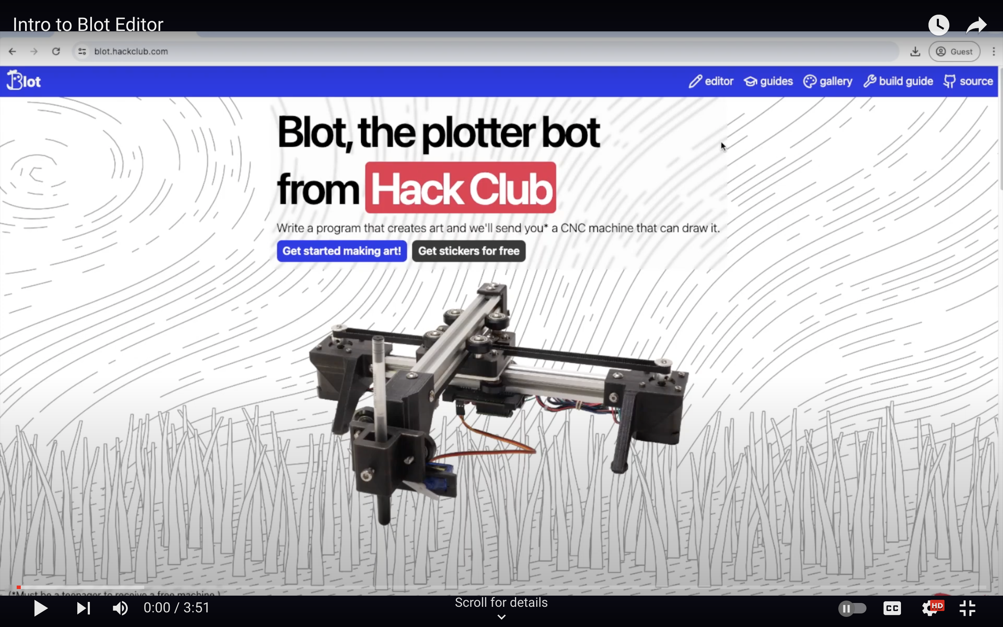
docs/lesson/assets/intro-to-editor.png
