3XAY/aPeacefulSceneBlot/docs/lesson/assets/output-drawing.png

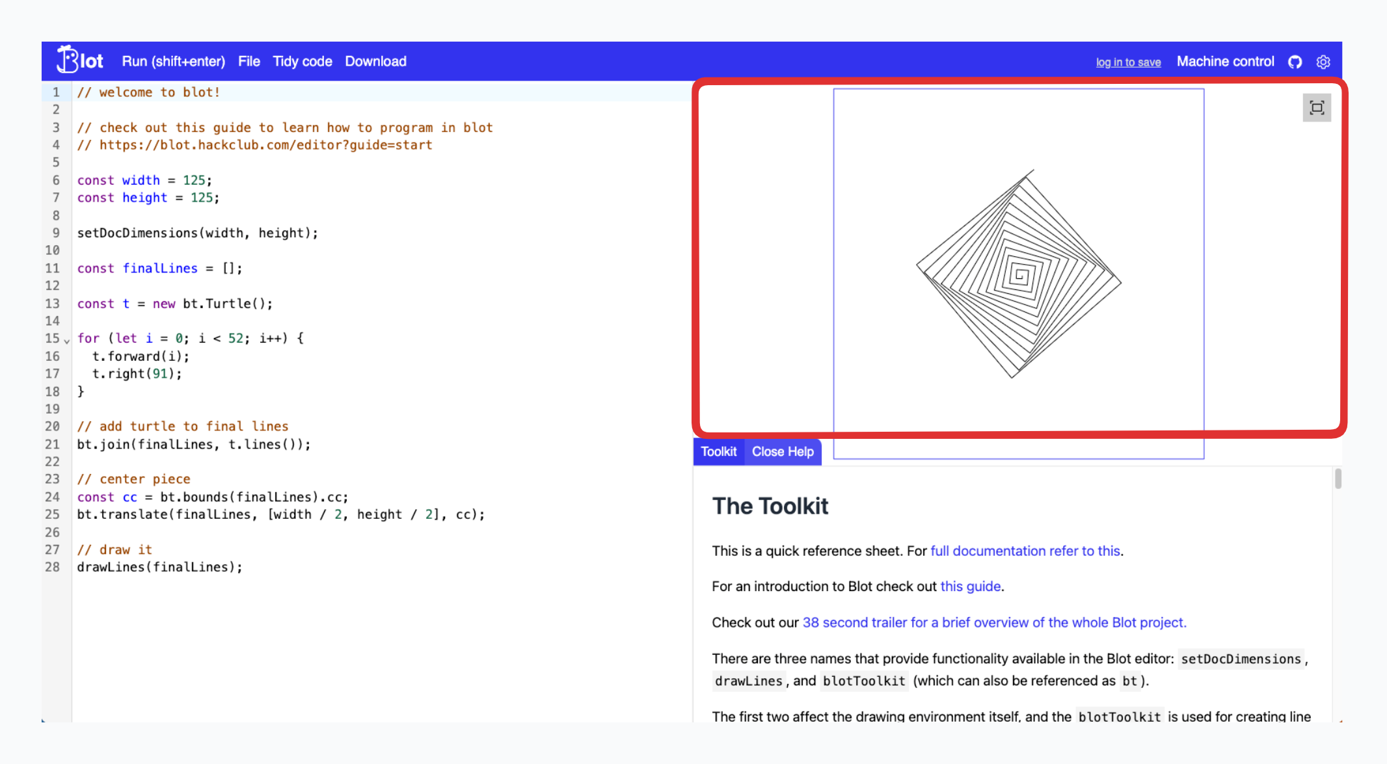
docs/lesson/assets/output-drawing.png
