3XAY/aPeacefulSceneBlot/docs/lesson/assets/puzzles/1.png

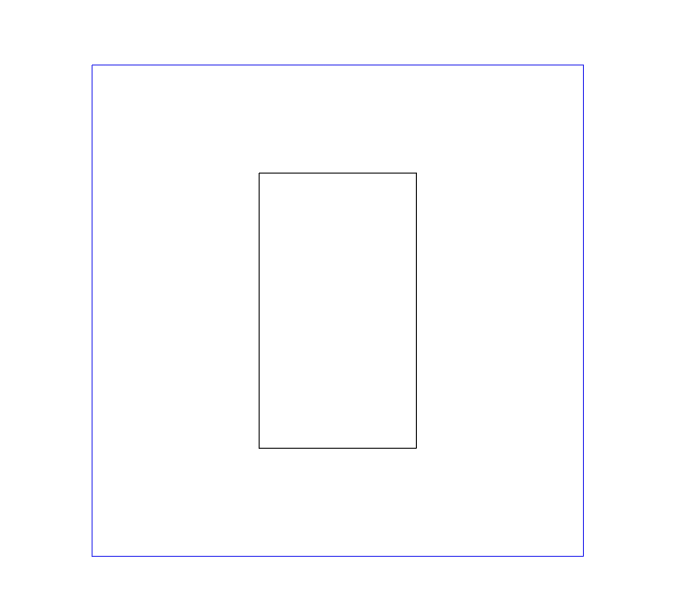
docs/lesson/assets/puzzles/1.png
