3XAY/aPeacefulSceneBlot/docs/lesson/assets/puzzles/2.png

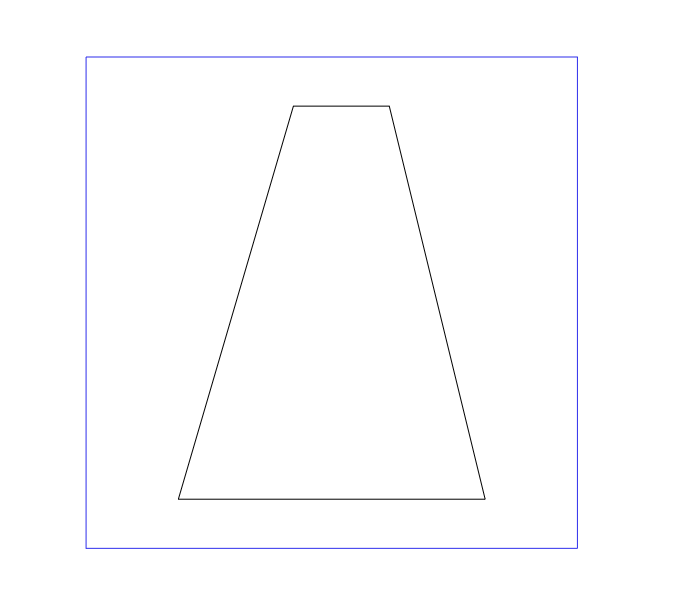
docs/lesson/assets/puzzles/2.png
