3XAY/aPeacefulSceneBlot/docs/lesson/assets/puzzles/3.png

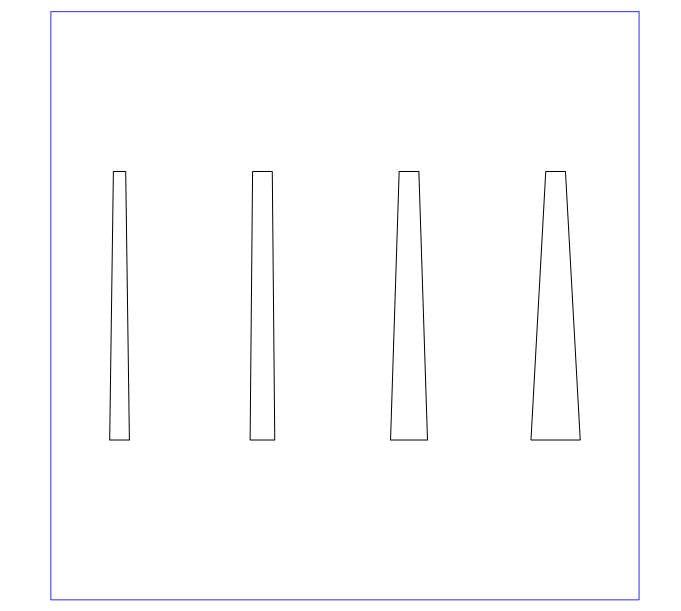
docs/lesson/assets/puzzles/3.png
