3XAY/aPeacefulSceneBlot/docs/lesson/assets/puzzles/4.png

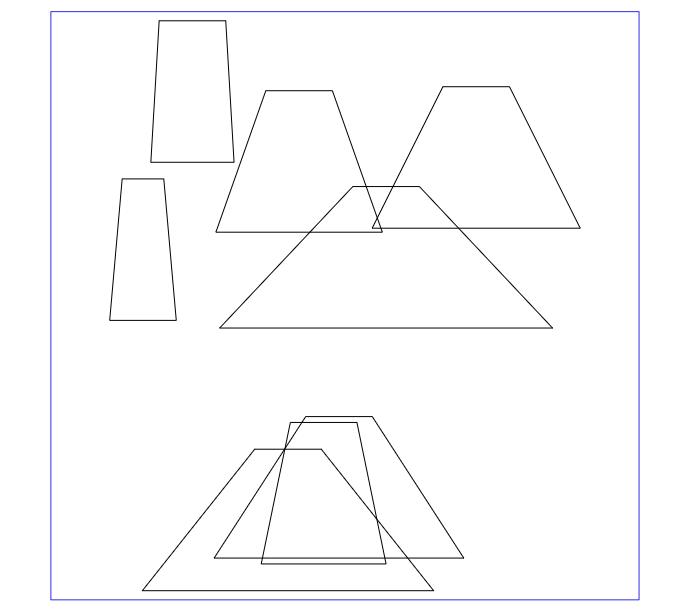
docs/lesson/assets/puzzles/4.png
