3XAY/aPeacefulSceneBlot/docs/lesson/assets/puzzles/5.png

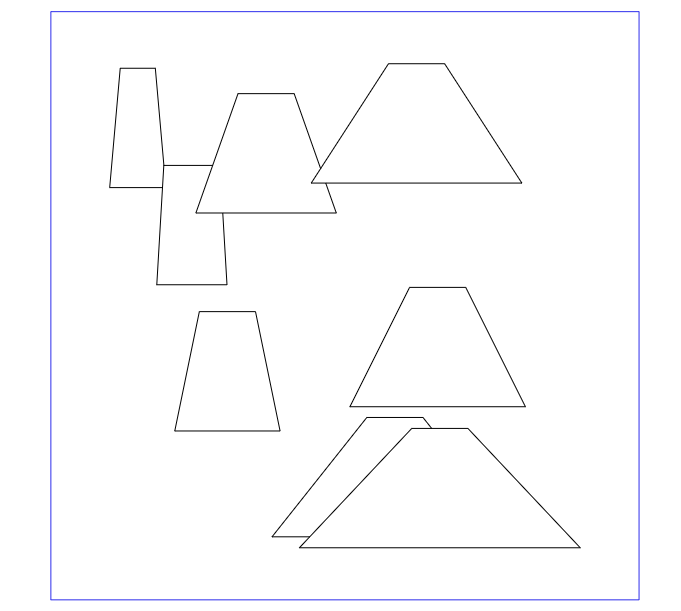
docs/lesson/assets/puzzles/5.png
