3XAY/aPeacefulSceneBlot/docs/lesson/assets/puzzles/6.png

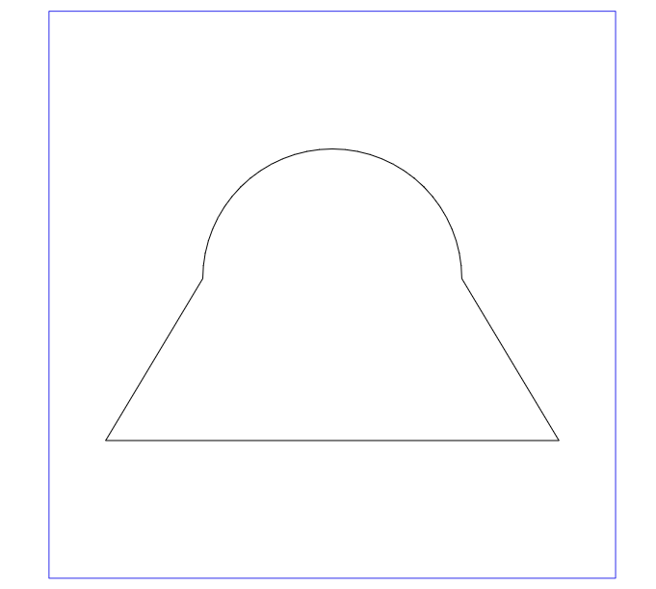
docs/lesson/assets/puzzles/6.png
