3XAY/aPeacefulSceneBlot/docs/lesson/assets/puzzles/7.png

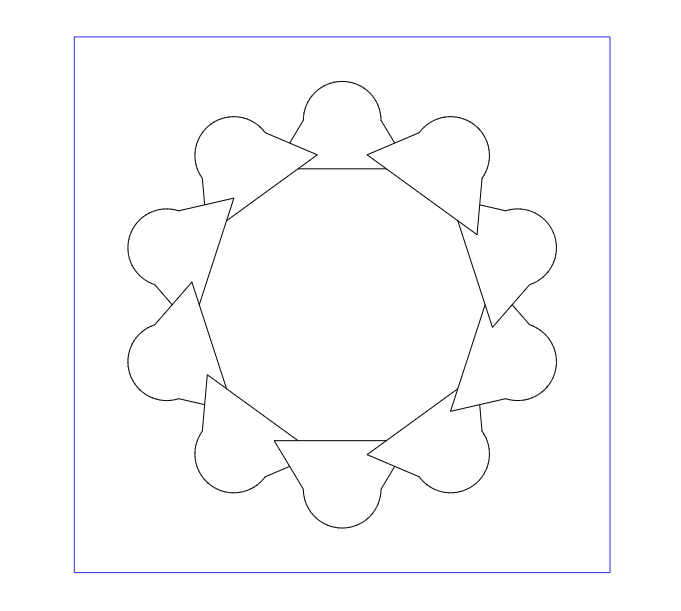
docs/lesson/assets/puzzles/7.png
