3XAY/aPeacefulSceneBlot/docs/lesson/assets/reset.png

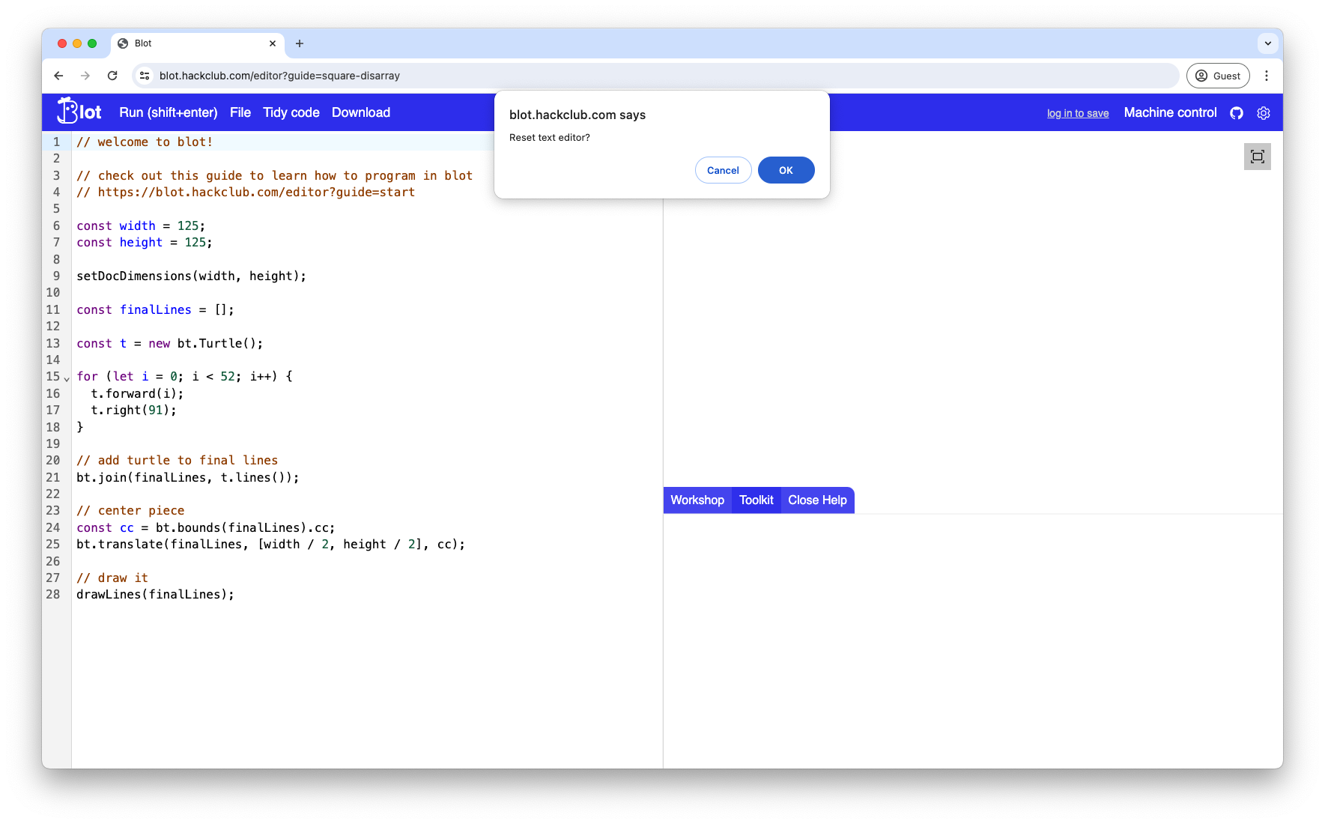
docs/lesson/assets/reset.png
