3XAY/aPeacefulSceneBlot/docs/lesson/assets/run.png

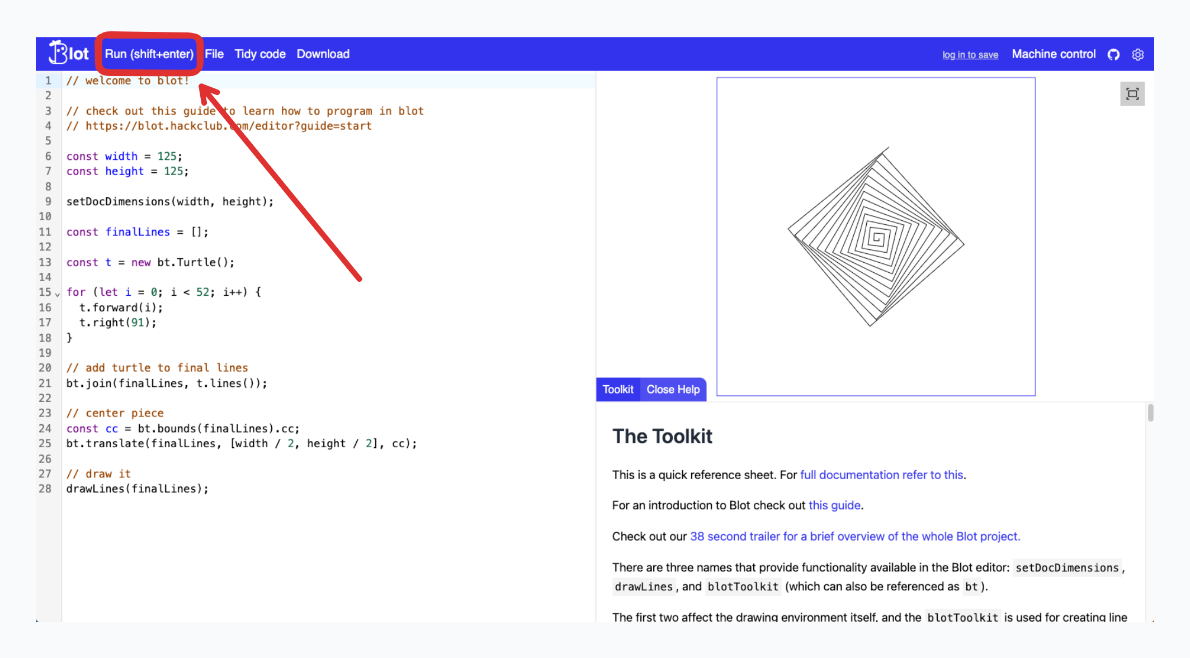
docs/lesson/assets/run.png
