3XAY/aPeacefulSceneBlot/docs/lesson/assets/save.png

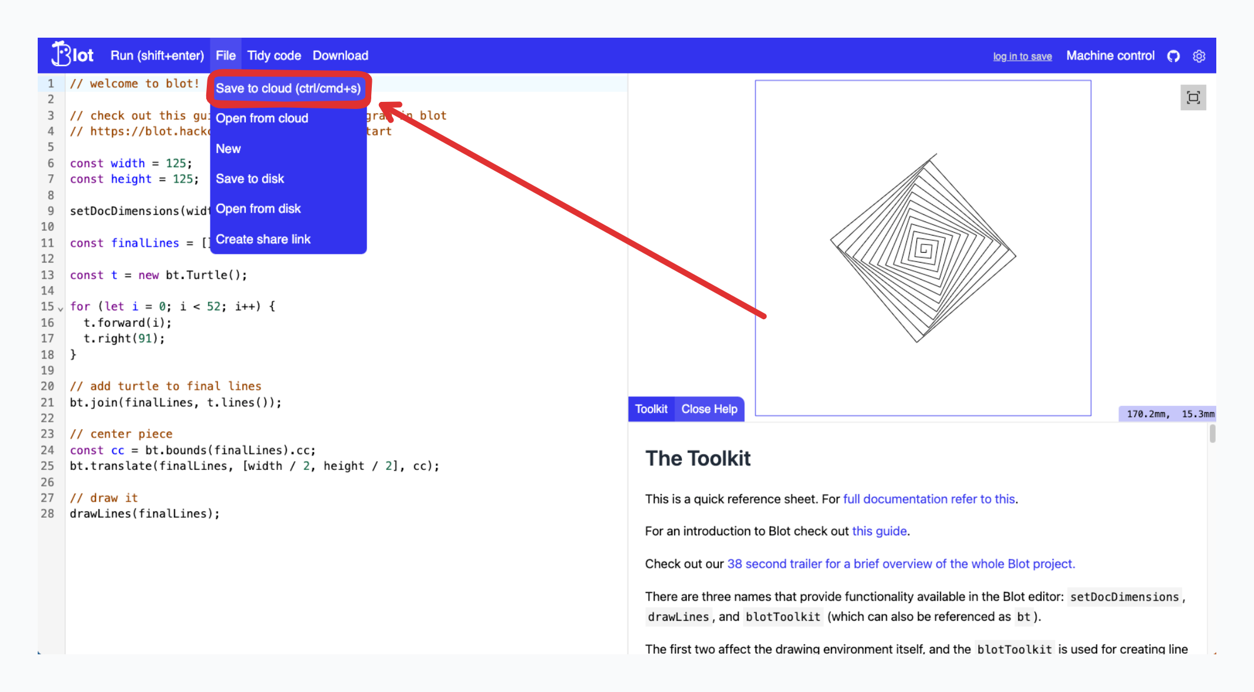
docs/lesson/assets/save.png
