3XAY/aPeacefulSceneBlot/docs/lesson/assets/square-disarray.png

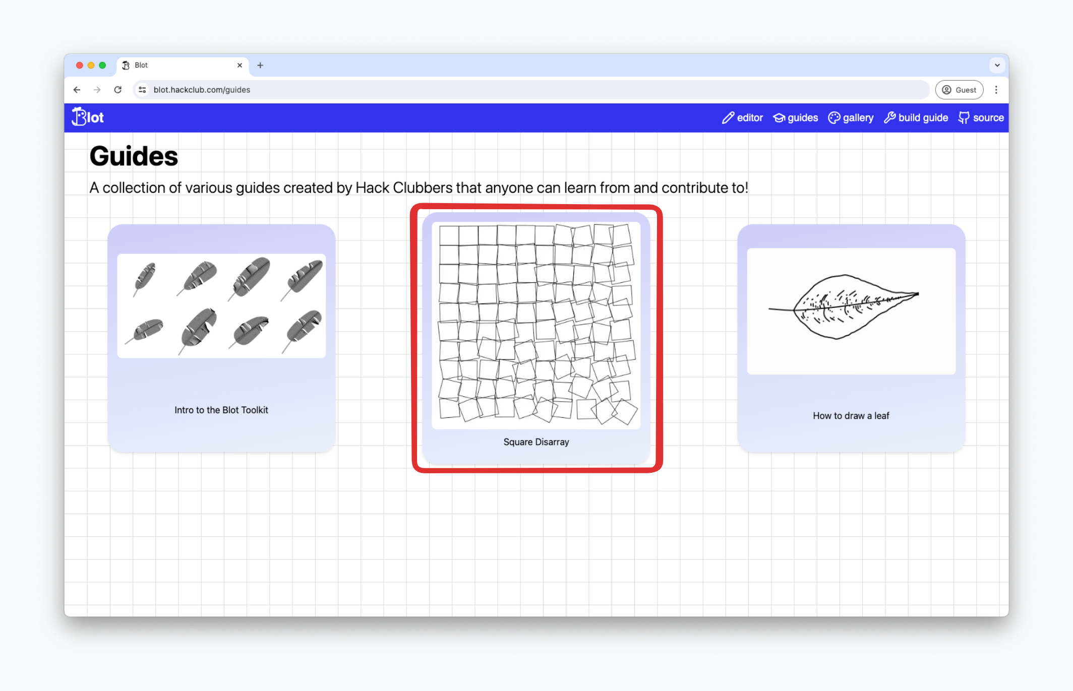
docs/lesson/assets/square-disarray.png
