3XAY/aPeacefulSceneBlot/docs/lesson/assets/square-video.png

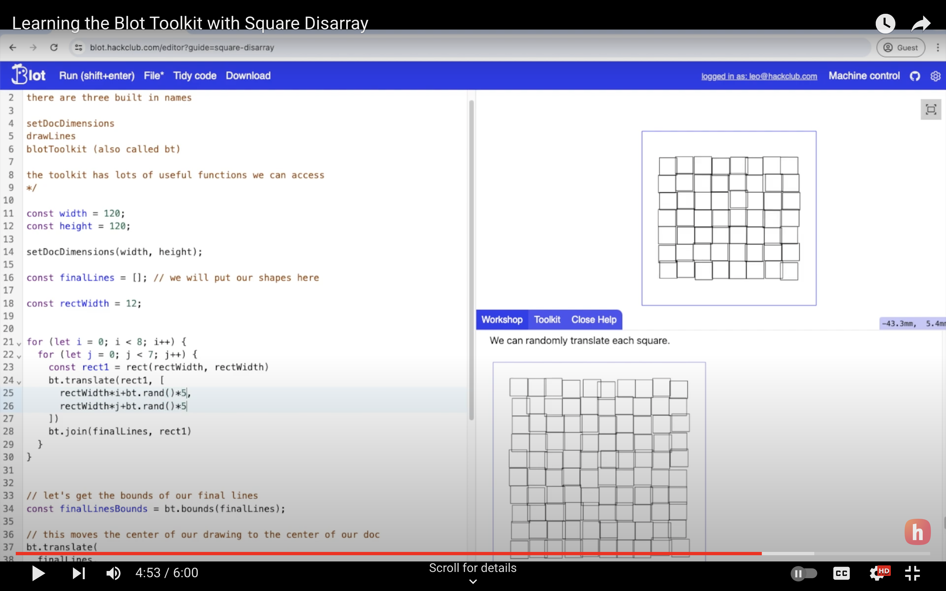
docs/lesson/assets/square-video.png
