3XAY/aPeacefulSceneBlot/docs/lesson/assets/toolkit.png

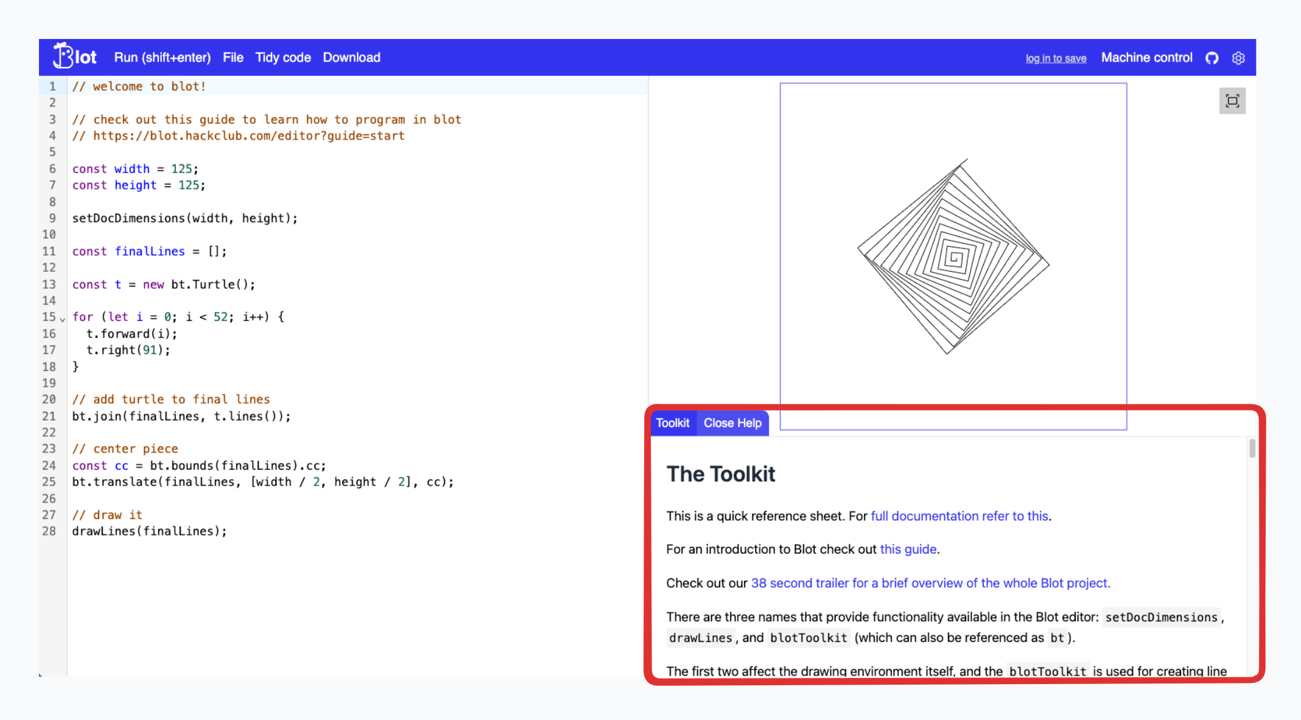
docs/lesson/assets/toolkit.png
