3XAY/aPeacefulSceneBlot/docs/lesson/assets/workshop.png

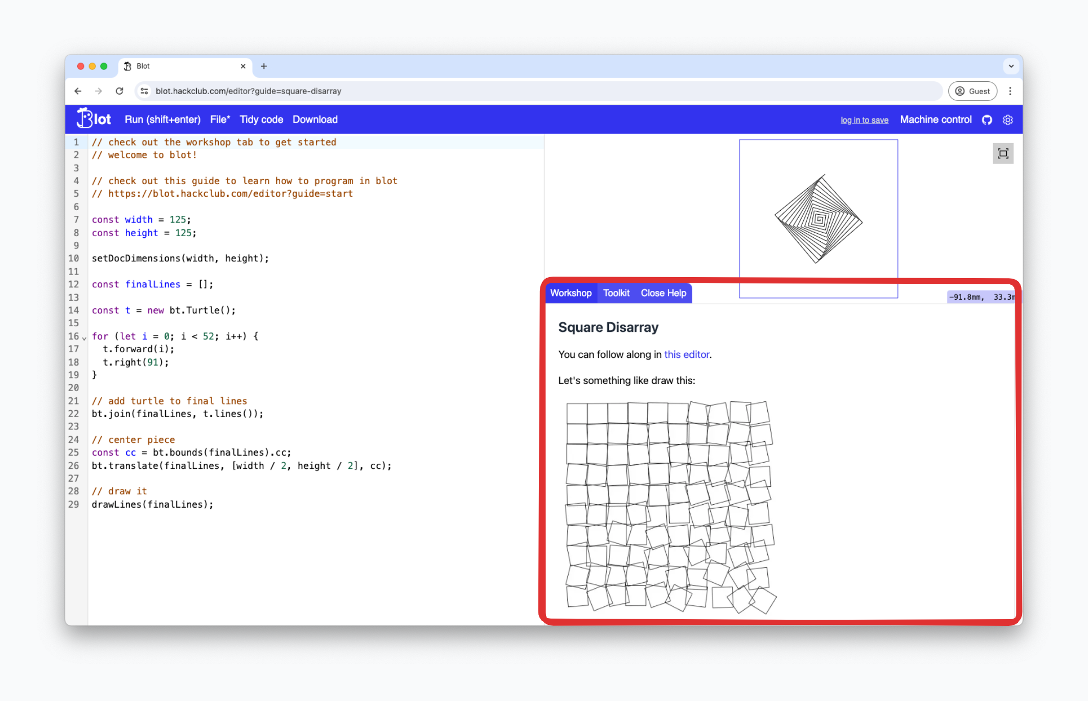
docs/lesson/assets/workshop.png
