3XAY/aPeacefulSceneBlot/hardware/motor-control-board/circuit/power-delivery/CYPD3177 Breakout Schematic.png

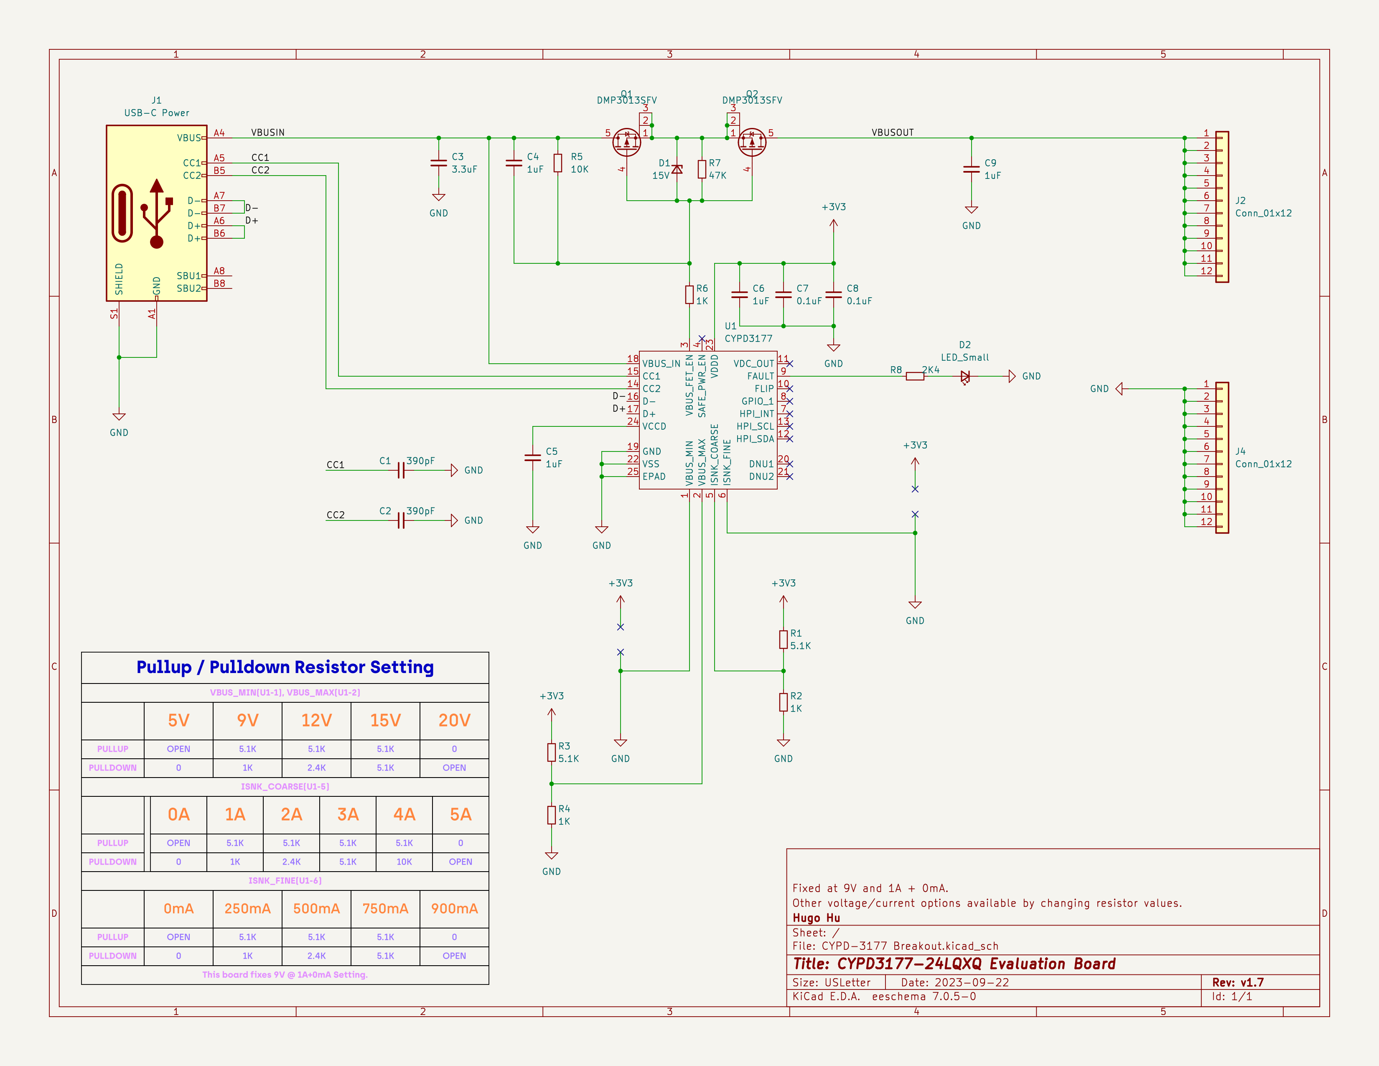
hardware/motor-control-board/circuit/power-delivery/CYPD3177 Breakout Schematic.png
