3XAY/aPeacefulSceneBlot/public/assets/blot-clear-bg-v0.png

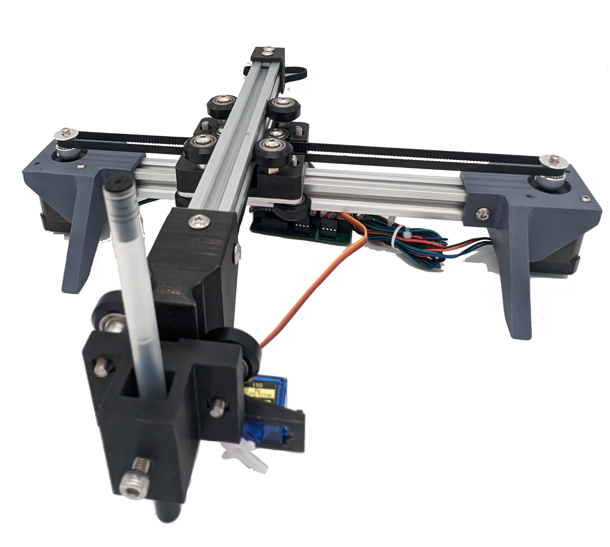
public/assets/blot-clear-bg-v0.png
