3XAY/aPeacefulSceneBlot/public/assets/blot-clear-bg.webp

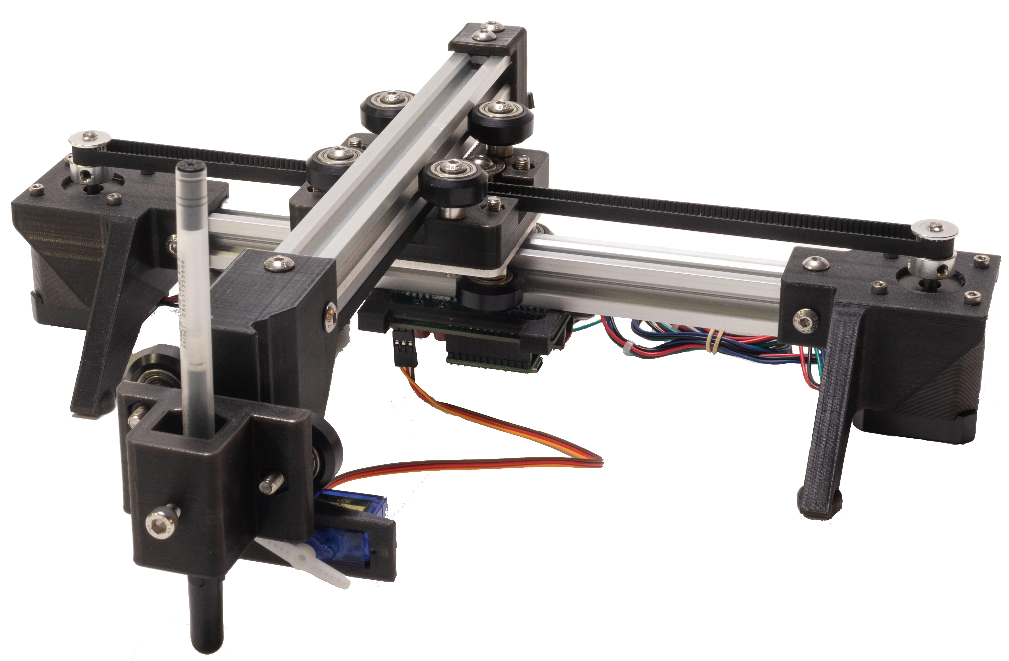
public/assets/blot-clear-bg.webp
