3XAY/aPeacefulSceneBlot/public/assets/blot-white-bg.jpg

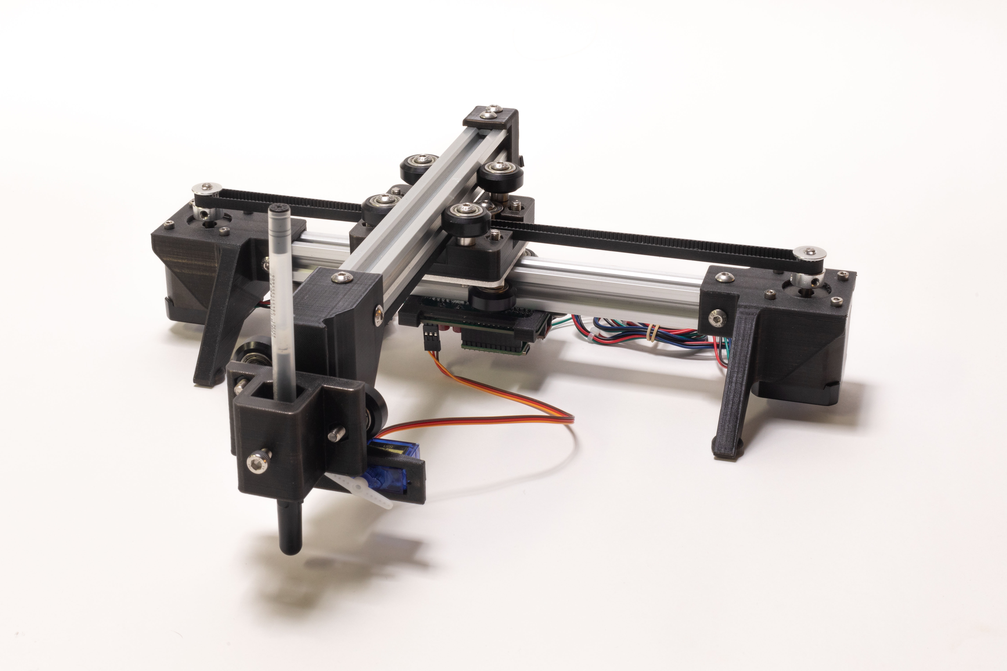
public/assets/blot-white-bg.jpg
