3XAY/aPeacefulSceneBlot/public/assets/code2.webp

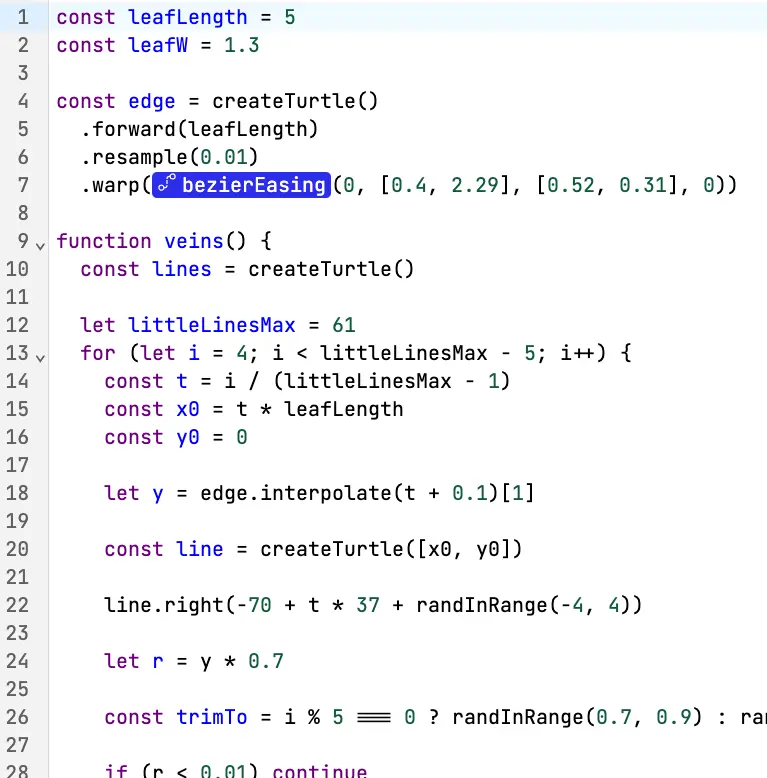
public/assets/code2.webp
