3XAY/aPeacefulSceneBlot/public/assets/code.webp

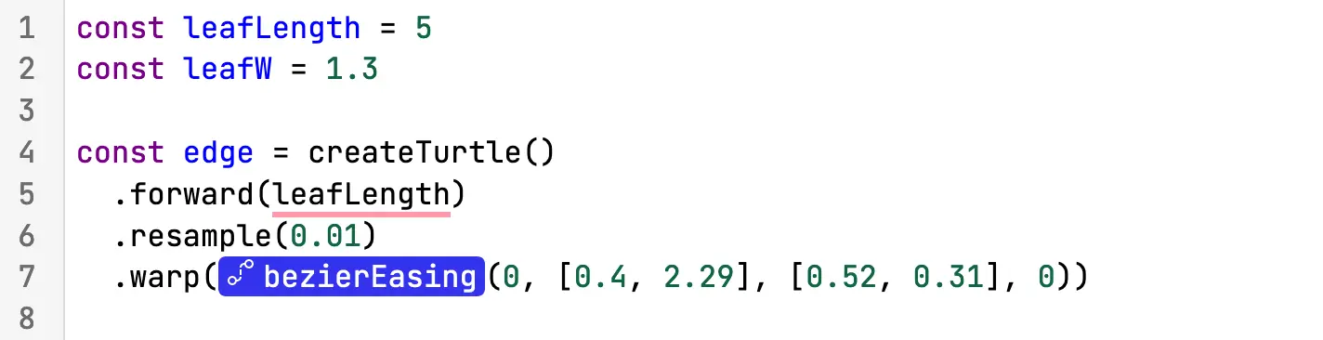
public/assets/code.webp
