3XAY/aPeacefulSceneBlot/public/assets/control-board-v0.png

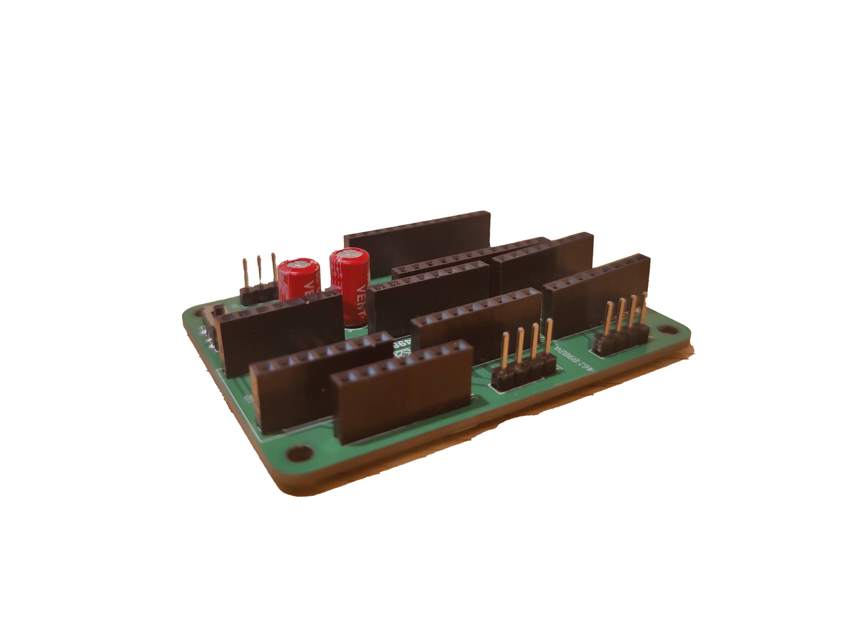
public/assets/control-board-v0.png
