3XAY/aPeacefulSceneBlot/public/assets/control-board.png

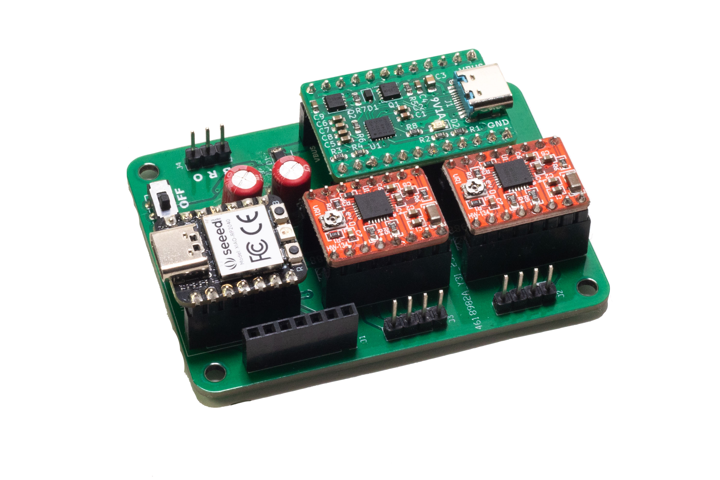
public/assets/control-board.png
