3XAY/aPeacefulSceneBlot/public/assets/editor-0.png

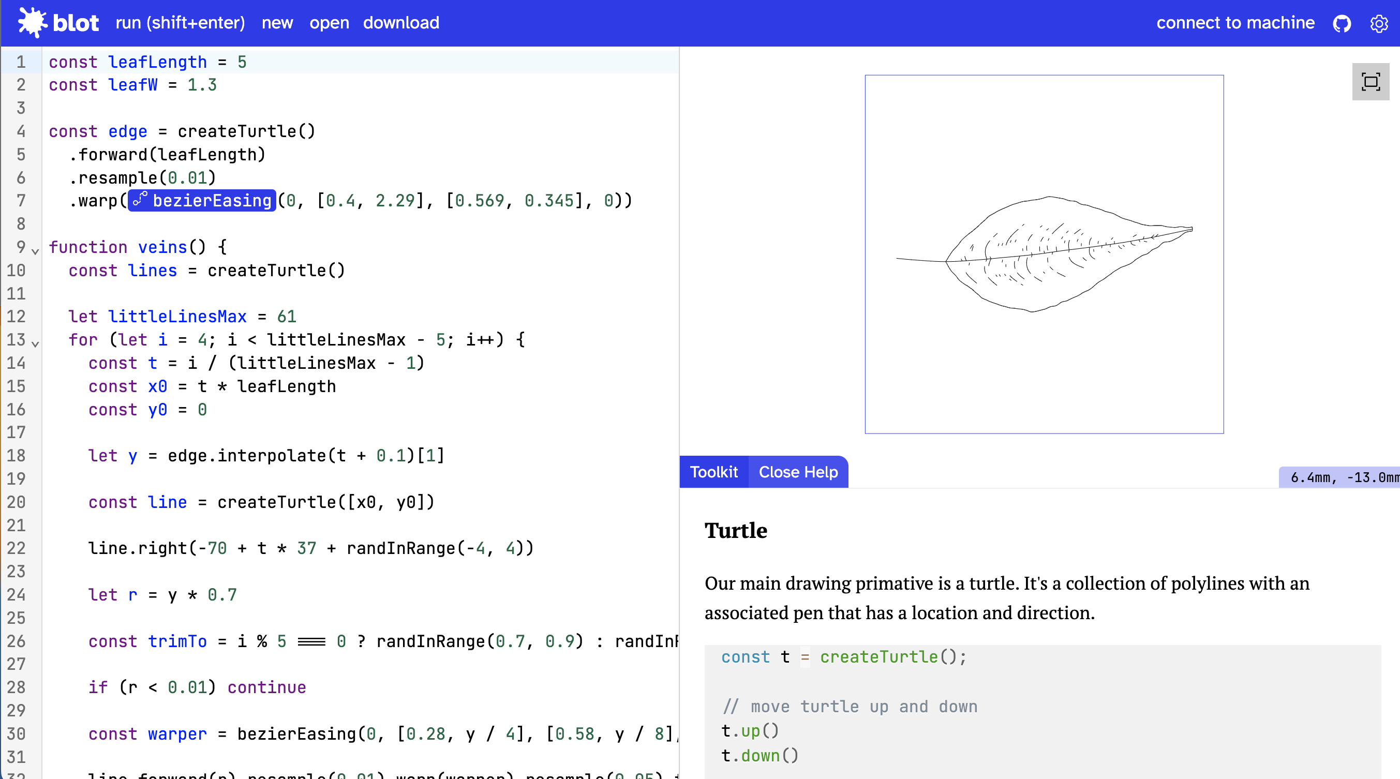
public/assets/editor-0.png
