3XAY/aPeacefulSceneBlot/public/assets/editor.png

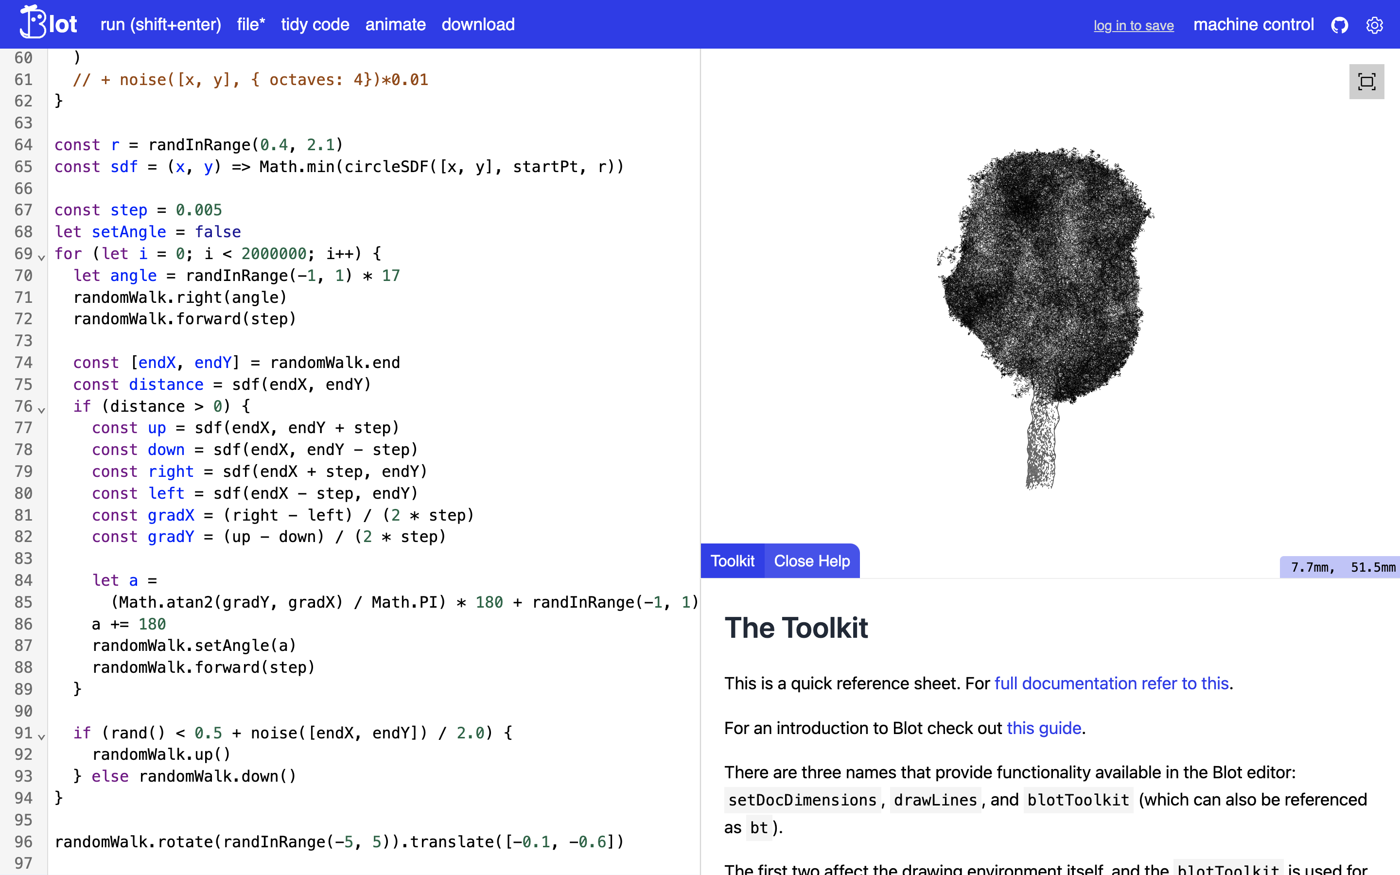
public/assets/editor.png
