3XAY/aPeacefulSceneBlot/public/assets/machine.webp

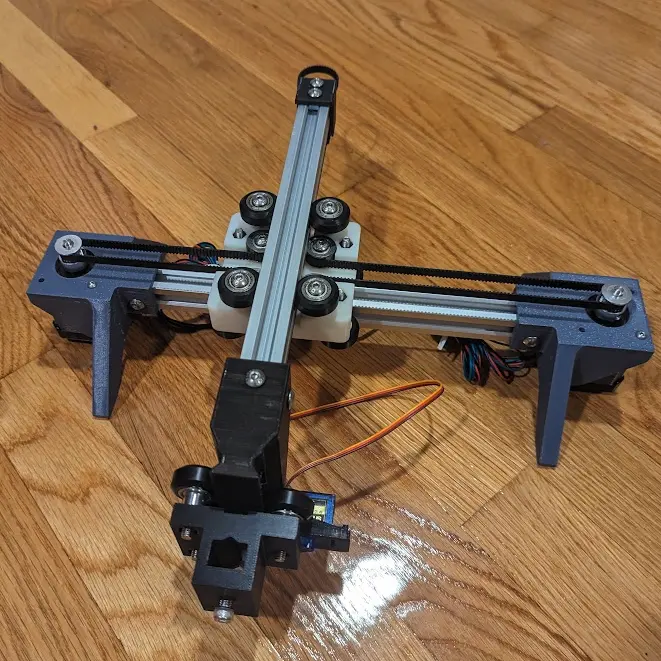
public/assets/machine.webp
