3XAY/aPeacefulSceneBlot/public/assets/all-parts.jpg

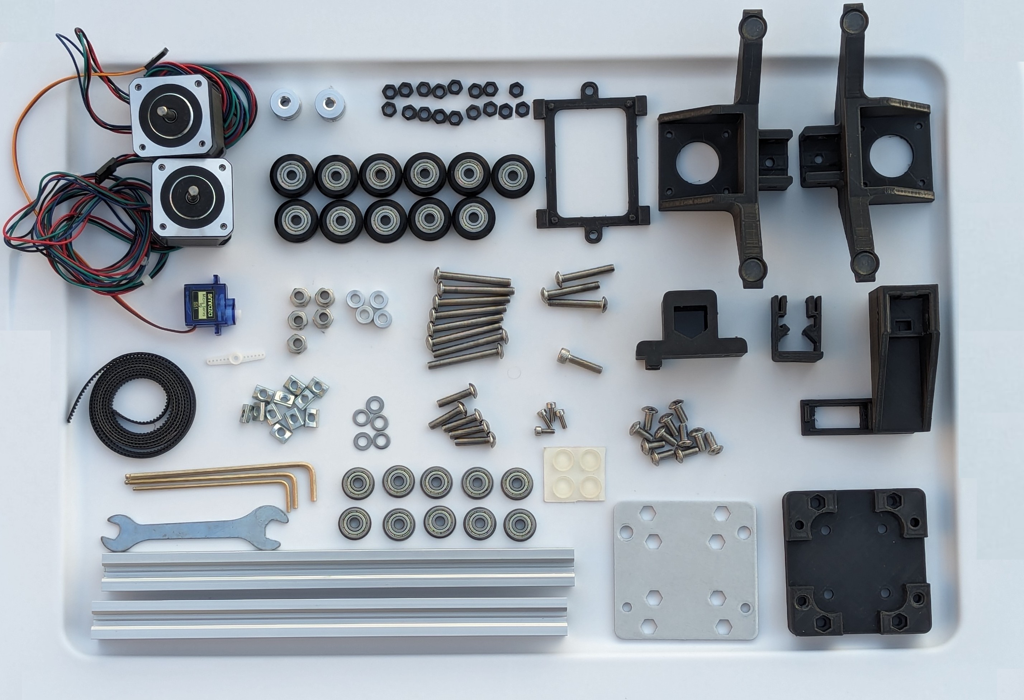
public/assets/all-parts.jpg
