3XAY/aPeacefulSceneBlot/public/assets/board-parts.png

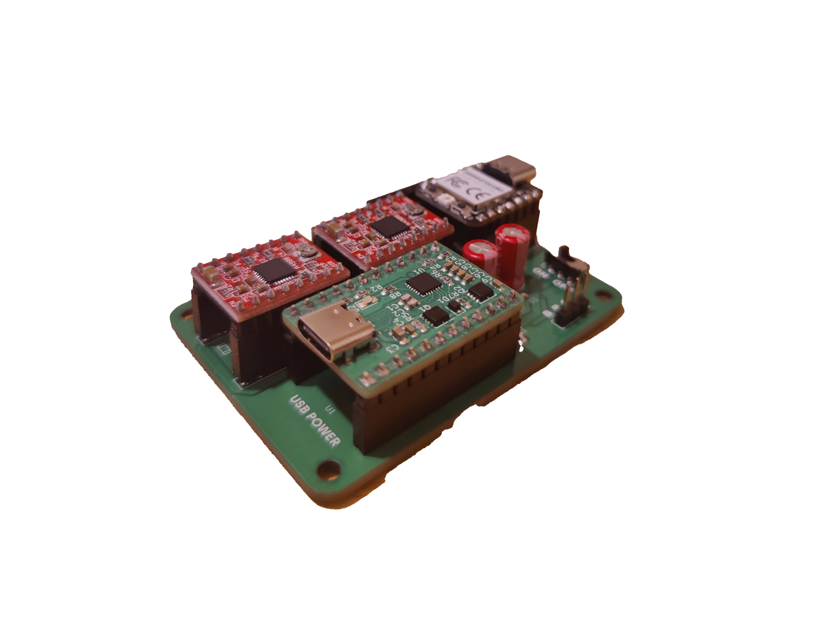
public/assets/board-parts.png
