3XAY/aPeacefulSceneBlot/public/assets/parts.png

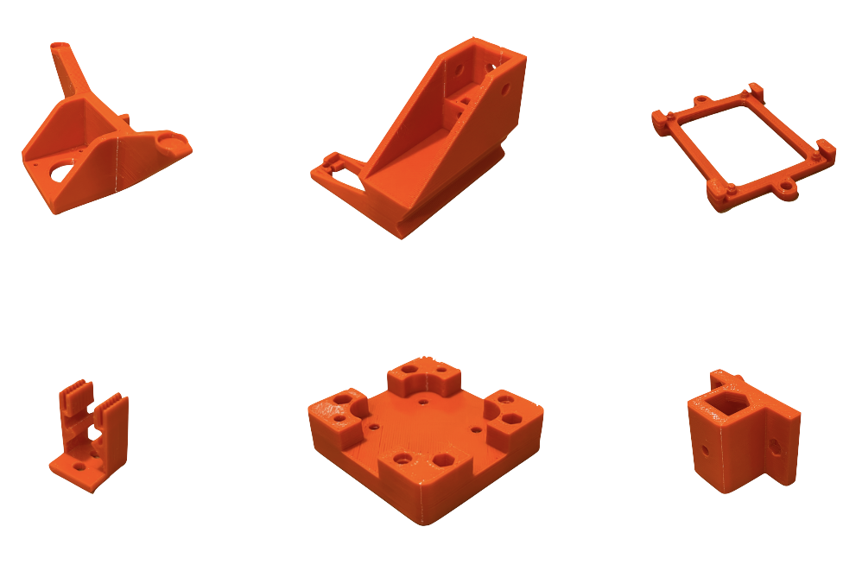
public/assets/parts.png
