3XAY/aPeacefulSceneBlot/hardware/mechanical/blot-v6/1x_PrintedRail.stl

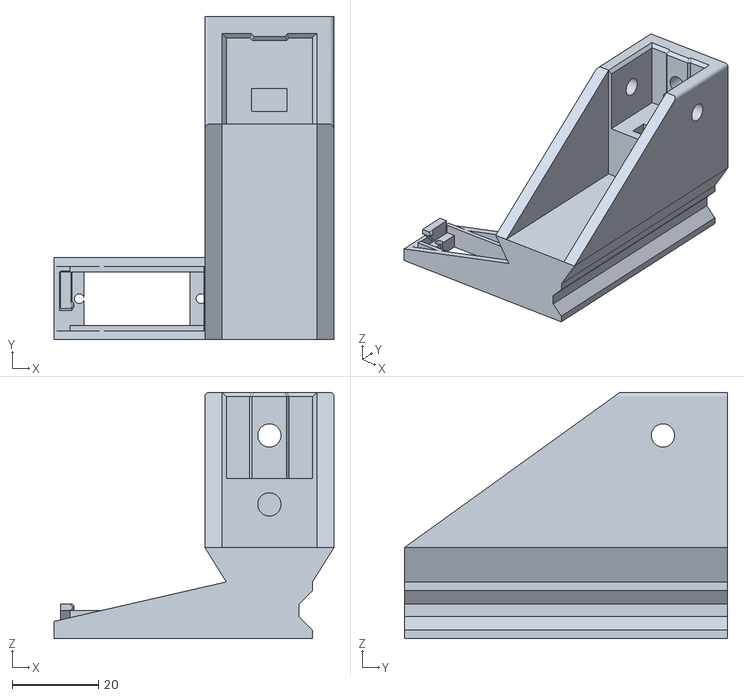
[picture p126: CAD file, 2024-11-28]
hardware/mechanical/blot-v6/1x_PrintedRail.stl
65.0 x 75.0 x 57.2
