3XAY/aPeacefulSceneBlot/hardware/mechanical/drawing-thing-v5/1x_BeltClip.stl

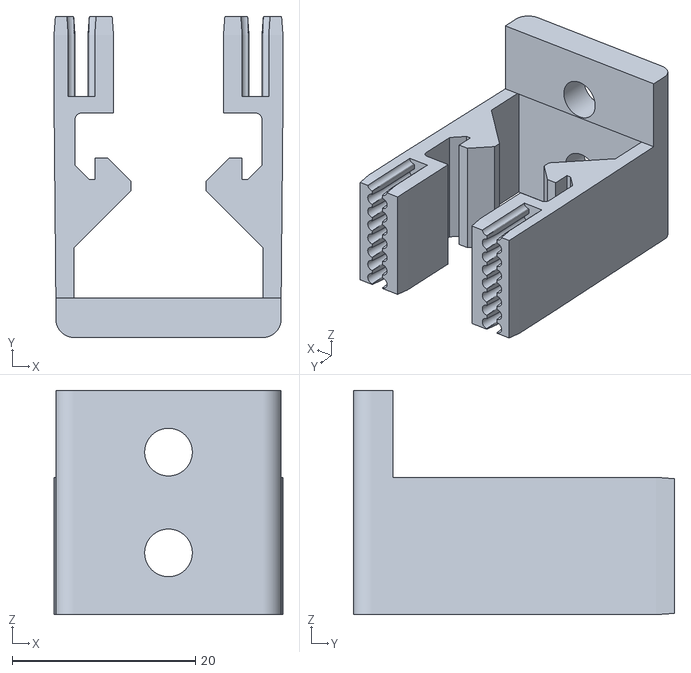
[picture p127: CAD file, 2024-11-28]
hardware/mechanical/drawing-thing-v5/1x_BeltClip.stl
25.0 x 35.1 x 24.5
