3XAY/aPeacefulSceneBlot/hardware/mechanical/blot-v6/1x_ToolHead.stl

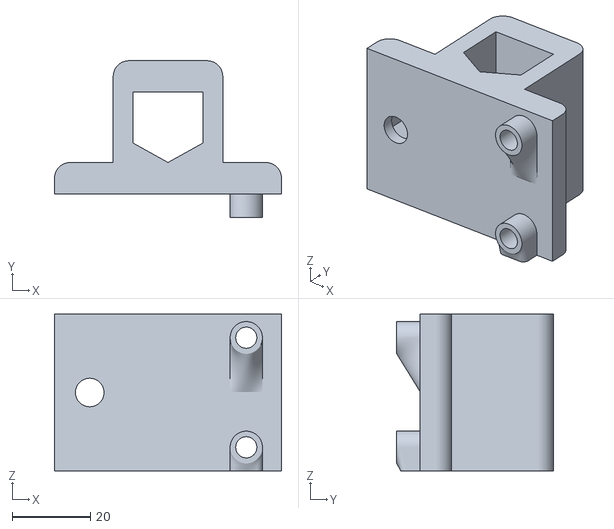
[picture p128: CAD file, 2024-11-28]
hardware/mechanical/blot-v6/1x_ToolHead.stl
58.0 x 40.0 x 40.0
