3XAY/aPeacefulSceneBlot/hardware/mechanical/blot-v6/2x_Legs.stl

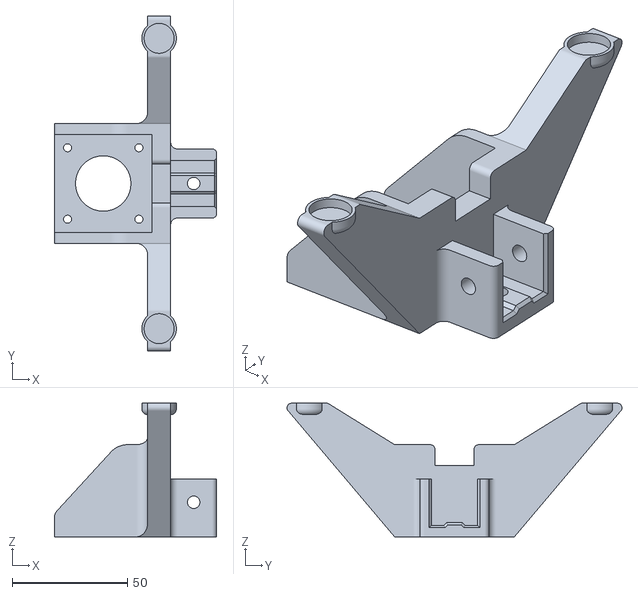
[picture p129: CAD file, 2024-11-28]
hardware/mechanical/blot-v6/2x_Legs.stl
70.5 x 145.4 x 58.0
