3XAY/aPeacefulSceneBlot/hardware/mechanical/drawing-thing-v5/1x_CarriagePlate.stl

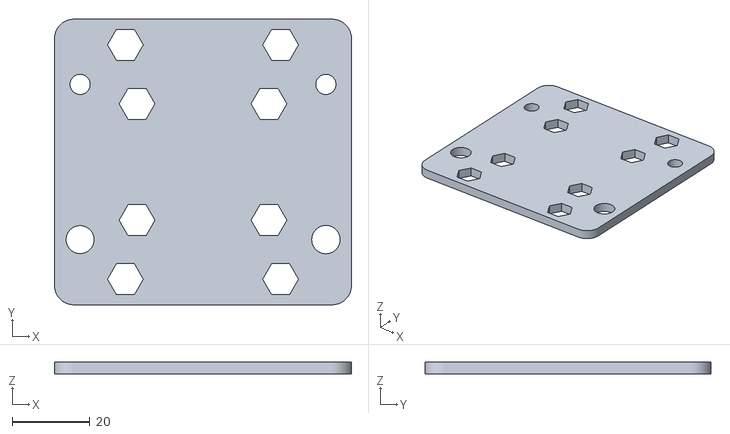
[picture p130: CAD file, 2024-11-28]
hardware/mechanical/drawing-thing-v5/1x_CarriagePlate.stl
76.5 x 73.6 x 3.17
