3XAY/aPeacefulSceneBlot/hardware/mechanical/blot-v6/1x_Carriage.stl

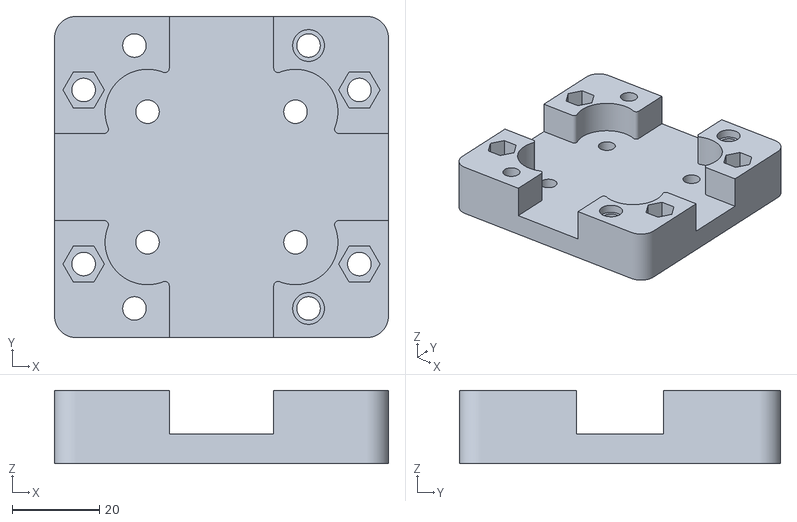
[picture p131: CAD file, 2024-11-28]
hardware/mechanical/blot-v6/1x_Carriage.stl
76.7 x 73.8 x 16.8
