3XAY/aPeacefulSceneBlot/hardware/mechanical/drawing-thing-v5/1x_PcbMount.stl

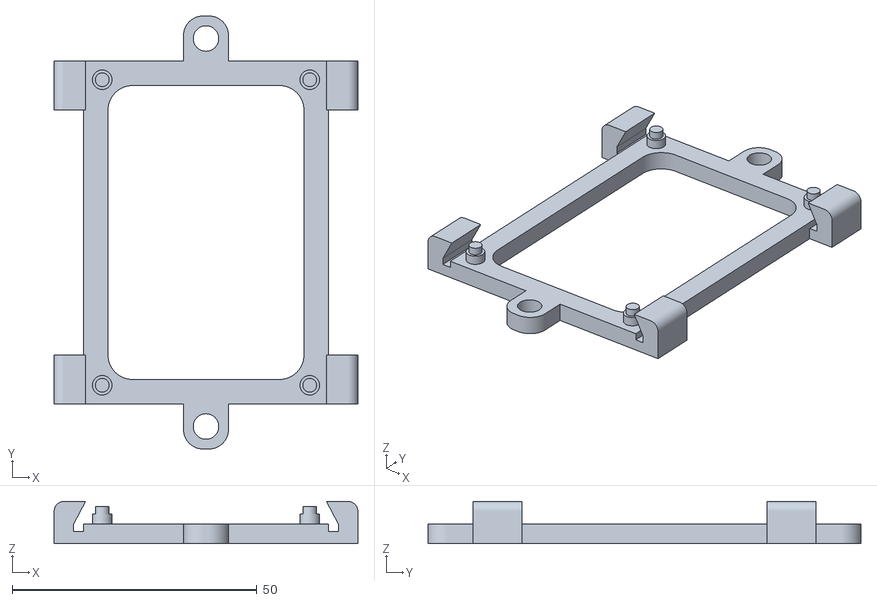
[picture p132: CAD file, 2024-11-28]
hardware/mechanical/drawing-thing-v5/1x_PcbMount.stl
62.0 x 88.4 x 8.60
