3XAY/aPeacefulSceneBlot/hardware/mechanical/blot-v6/1x_BeltClip.stl

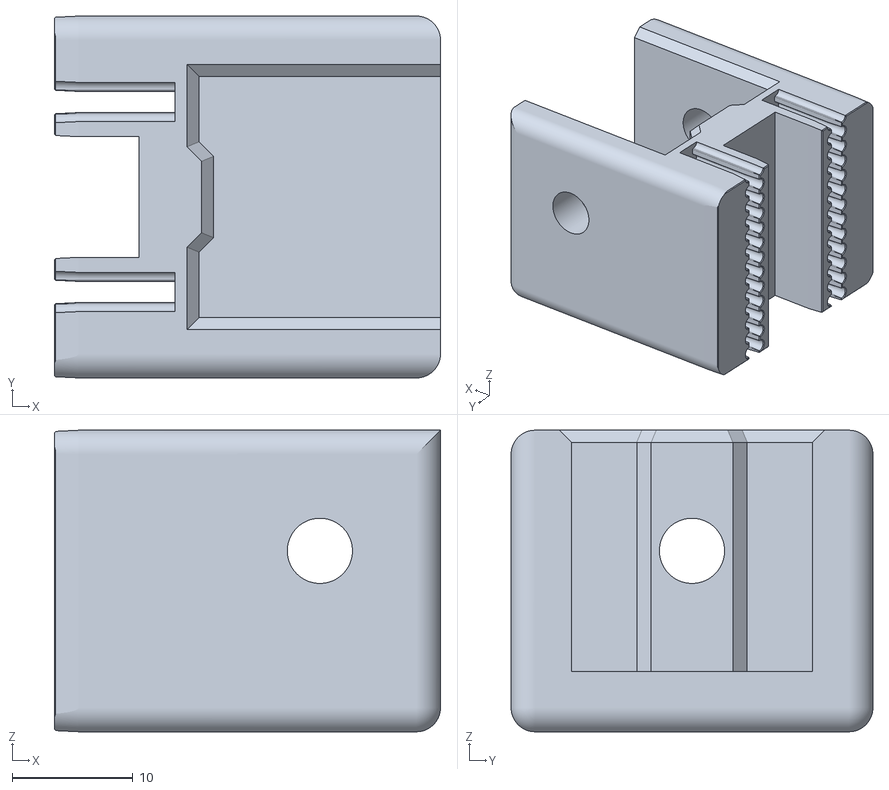
[picture p133: CAD file, 2024-11-28]
hardware/mechanical/blot-v6/1x_BeltClip.stl
32.0 x 30.0 x 25.0
