3XAY/aPeacefulSceneBlot/hardware/mechanical/drawing-thing-v5/1x_EccentricCarriage.stl

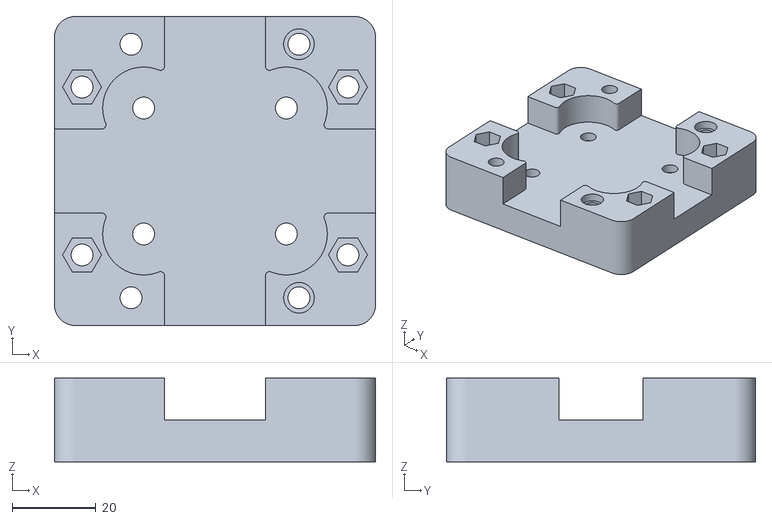
[picture p134: CAD file, 2024-11-28]
hardware/mechanical/drawing-thing-v5/1x_EccentricCarriage.stl
76.5 x 73.6 x 20.0
