3XAY/aPeacefulSceneBlot/hardware/mechanical/drawing-thing-v0/mechanical/Carriage - Carriage.dxf

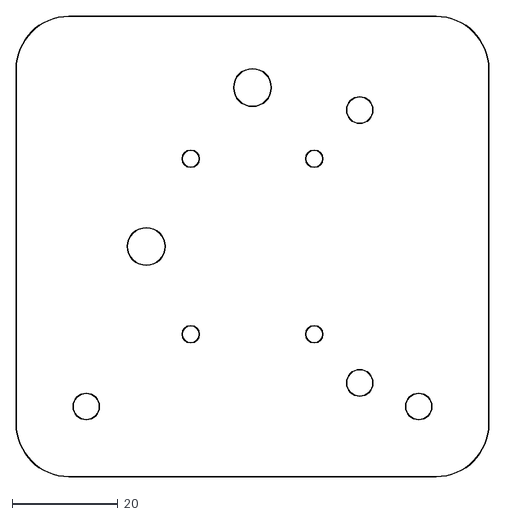
[picture p135: CAD file, 2024-11-28, an earlier design]
hardware/mechanical/drawing-thing-v0/mechanical/Carriage - Carriage.dxf
89.6 x 87.2
