3XAY/aPeacefulSceneBlot/hardware/mechanical/drawing-thing-v1/stls/carriage_x1.stl

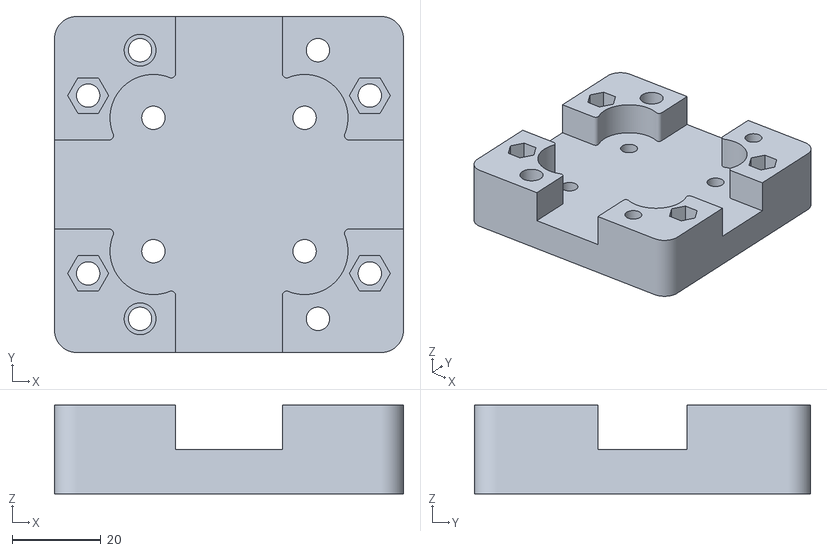
[picture p136: CAD file, 2024-11-28, an earlier design]
hardware/mechanical/drawing-thing-v1/stls/carriage_x1.stl
78.5 x 75.6 x 20.0
