3XAY/aPeacefulSceneBlot/hardware/mechanical/drawing-thing-v2/stls/pen-holder_x1.stl

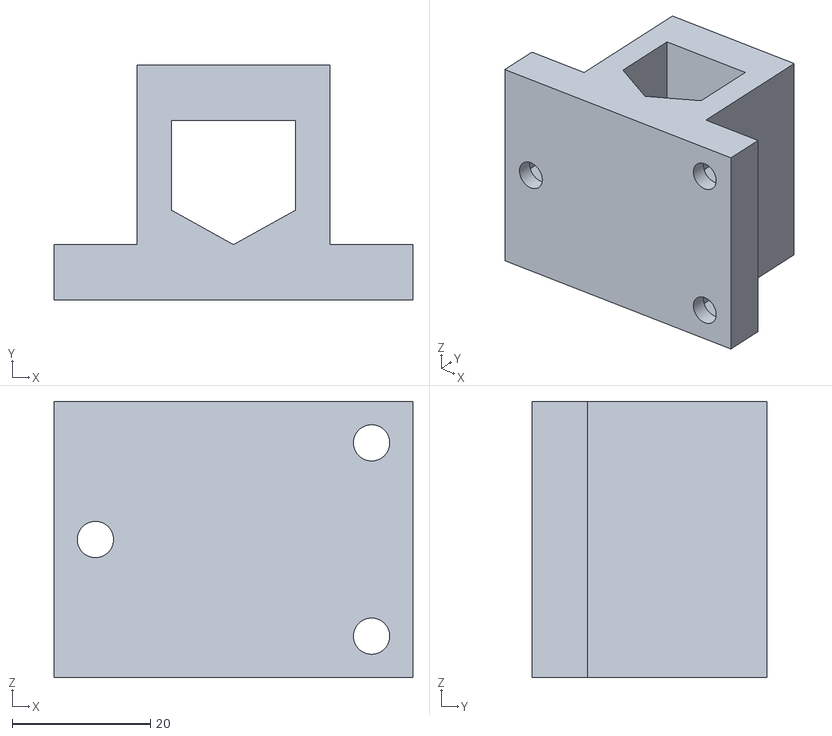
[picture p137: CAD file, 2024-11-28, an earlier design]
hardware/mechanical/drawing-thing-v2/stls/pen-holder_x1.stl
52.0 x 34.0 x 40.0
