3XAY/aPeacefulSceneBlot/(list of files, cad)

Other CAD files:
hardware/mechanical/drawing-thing-v5/1x_PrintedRail.stl
hardware/mechanical/drawing-thing-v5/1x_ReinforcedCarriage.stl
hardware/mechanical/blot-v6/1x_CarriagePlate.step
hardware/mechanical/blot-v6/1x_PcbMount.stl
hardware/mechanical/drawing-thing-v5/2x_Legs.stl
hardware/mechanical/drawing-thing-v5/1x_ToolHead.stl
hardware/mechanical/blot-v6/1x_CarriagePlate.dxf
hardware/mechanical/drawing-thing-v0/mechanical/Idler spacer - Idler spacer.stl
hardware/mechanical/drawing-thing-v0/mechanical/Pen holder - Pen holder.stl
hardware/mechanical/drawing-thing-v0/mechanical/Pen holder - Pen mount.stl
hardware/mechanical/drawing-thing-v0/mechanical/X rail - X axis motor bracket - left.dxf
hardware/mechanical/drawing-thing-v0/mechanical/X rail - X axis motor bracket - right.dxf
hardware/mechanical/drawing-thing-v0/mechanical/Y parts - Belt pulley mount.stl
hardware/mechanical/drawing-thing-v0/mechanical/Y parts - Belt tensioner.stl
hardware/mechanical/drawing-thing-v1/stls/back-idler_x1.stl
hardware/mechanical/drawing-thing-v1/stls/belt-clamp-cap_x2.stl
hardware/mechanical/drawing-thing-v1/stls/belt-clamp_x1.stl
hardware/mechanical/drawing-thing-v1/stls/foot_x2.stl
hardware/mechanical/drawing-thing-v1/stls/motor-bracket_x2.stl
hardware/mechanical/drawing-thing-v2/stls/belt-clamp-cap_x2.stl
hardware/mechanical/drawing-thing-v2/stls/belt-clamp_x1.stl
hardware/mechanical/drawing-thing-v2/stls/carriage_x1.stl
hardware/mechanical/drawing-thing-v2/stls/foot_x2.stl
hardware/mechanical/drawing-thing-v2/stls/idler-front_x1.stl
hardware/mechanical/drawing-thing-v2/stls/motor-bracket_x2.stl
hardware/mechanical/drawing-thing-v2/stls/printed-rail_x1.stl
hardware/mechanical/drawing-thing-v3/stls/belt_clip_x1.stl
hardware/mechanical/drawing-thing-v3/stls/cable_spacer_x1.stl
hardware/mechanical/drawing-thing-v3/stls/carriage_x1.stl
hardware/mechanical/drawing-thing-v3/stls/foot_x2.stl
hardware/mechanical/drawing-thing-v3/stls/idler_front_x1.stl
hardware/mechanical/drawing-thing-v3/stls/motor_bracket_x2.stl
hardware/mechanical/drawing-thing-v3/stls/pcb_mount_x1.stl
hardware/mechanical/drawing-thing-v3/stls/pen_holder_x1.stl
hardware/mechanical/drawing-thing-v3/stls/printed_rail_x1.stl
hardware/mechanical/drawing-thing-v4/1x_BeltClip.stl
hardware/mechanical/drawing-thing-v4/1x_PrintedRail.stl
hardware/mechanical/drawing-thing-v4/1x_ToolHead.stl
hardware/mechanical/drawing-thing-v4/2x_Legs.stl
hardware/mechanical/drawing-thing-v5/1x_CarriagePlate.dxf
