3XAY/aPeacefulSceneBlot/docs/assembly/ASSEMBLY.md

# Blot Assembly

Congratulations! You've just received your Blot (or what is soon to be your Blot)! Get ready to jump into machine building. Don't worry we'll walk through everything in detail.

If you'd like to [watch a short video (6 minutes) of building a Blot you can click here](https://www.youtube.com/watch?v=7N-Nu6_oo4I).

It takes me about 30 minutes in real time to assemble a Blot but I have lots of experience (and designed the machine). Don't be discouraged if it takes a few hours (or more) there is a lot to learn along the way.

Here are all the parts that come with your Blot. The source of truth for the Blot components is the [BOM (Bill of Materials) available here](./BOM.toml).

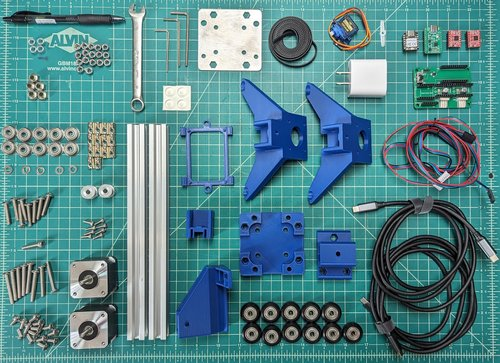
[picture p138: docs/assembly/assets/PXL_20240614_202958435.jpg]


| Quantity | Name | Image |
| --- | --- | --- |
| 1 | 3mm allen key | Screenshot 2024-07-10 at 2.00.28 PM.png |
| 1 | 2.5mm allen key | Screenshot 2024-07-10 at 2.01.33 PM.png |
| 1 | 2mm allen key | Screenshot 2024-07-10 at 2.02.03 PM.png |
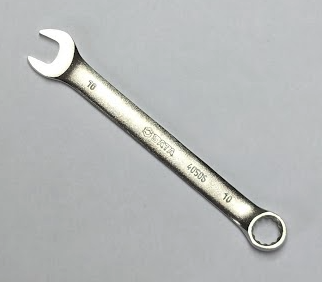
[picture p139: docs/assembly/assets/Screenshot 2024-06-14 at 5.05.14 PM.png]
| 1 | 10mm wrench |  |
| 8 | M5x35 Button Cap Screw |  |
| 8 | M5x25 Button Cap Screw |  |
| 17 | M5 Nut |  |
| 14 | M5 T-nut |  |
| 1 | M5x20, knurled cylinder head |  |
| 2 | Timing Belt Pulley |  |
| 14 | M5x10 Button Cap Screw |  |
| 4 | Rubber Feet (less than .5in diameter) |  |
| 8 | M3x10 Button Cap Screw |  |
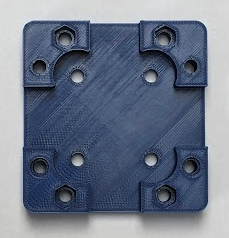
[picture p140: docs/assembly/assets/Screenshot 2024-06-14 at 5.05.56 PM.png]
| 1 | Carriage |  |
| 5 | Aluminum Spacer (1mm tall x 10mm OD)  |  |
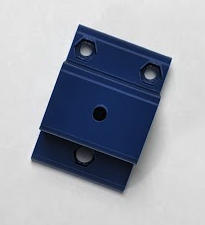
[picture p141: docs/assembly/assets/Screenshot 2024-06-14 at 5.06.00 PM.png]
| 1 | Tool Head |  |
| 5 | Eccentric Spacer (6mm tall) |  |
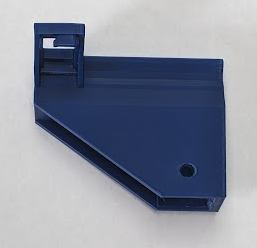
[picture p142: docs/assembly/assets/Screenshot 2024-06-14 at 5.06.08 PM.png]
| 1 | Printed Rail |  |
| 4 | Aluminum Spacer (6mm tall x 8mm OD) |  |
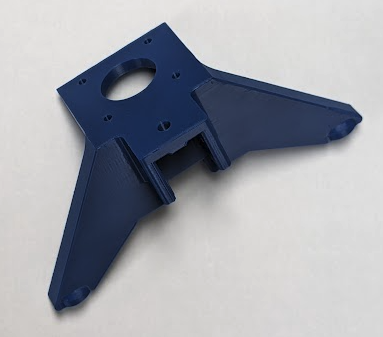
[picture p143: docs/assembly/assets/Screenshot 2024-06-14 at 5.05.47 PM.png]
| 2 | Motor Leg |  |
| 11 | 625zz V-Wheel |  |
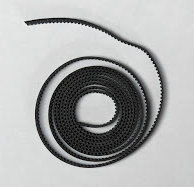
[picture p144: docs/assembly/assets/Screenshot 2024-06-14 at 5.01.32 PM.png]
| 1 | 125cm long GT2 Timing Belt |  |
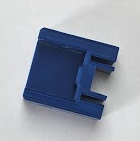
[picture p145: docs/assembly/assets/Screenshot 2024-06-14 at 5.06.16 PM.png]
| 1 | Belt Clip |  |
| 10 | Flanged bearing (5x16x5mm) |  |
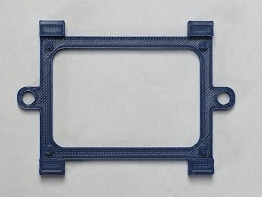
[picture p146: docs/assembly/assets/Screenshot 2024-06-14 at 5.04.36 PM.png]
| 1 | PCB Mount |  |
| 2 | 20mm x 20mm Aluminum Extrusion |  |
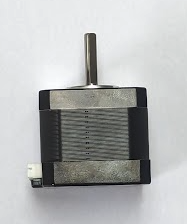
[picture p147: docs/assembly/assets/Screenshot 2024-06-14 at 5.23.56 PM.png]
| 2 | Stepper Motor (42mm x 42mm) |  |
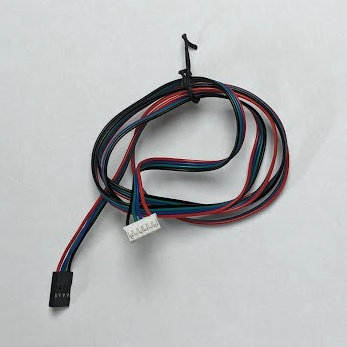
[picture p148: docs/assembly/assets/Screenshot 2024-06-14 at 4.59.42 PM.png]
| 2 | 20mm Stepper Motor Cables |  |
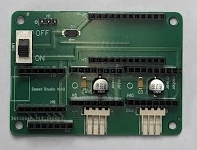
[picture p149: docs/assembly/assets/Screenshot 2024-06-14 at 5.05.33 PM.png]
| 1 | PCB - Control Board |  |
| 1 | PCB - Power Board |  |
| 1 | Xiao RP2040 |  |
| 2 | a4988 Stepper Motor Driver |  |
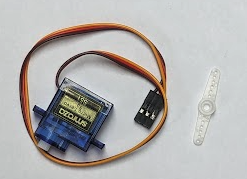
[picture p150: docs/assembly/assets/Screenshot 2024-06-14 at 5.04.28 PM.png]
| 1 | Servo + Arm (25mm cable) |  |
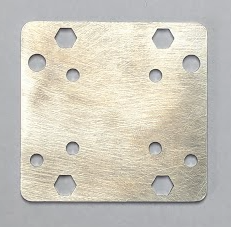
[picture p151: docs/assembly/assets/Screenshot 2024-06-14 at 5.05.51 PM.png]
| 1 | Carriage Plate |  |
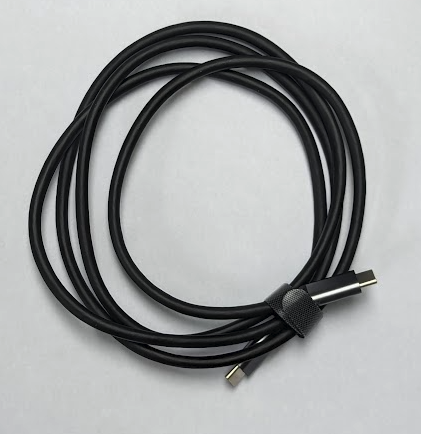
[picture p152: docs/assembly/assets/Screenshot 2024-06-14 at 4.59.50 PM.png]
| 2 | USB-C to USB-C Cable |  |
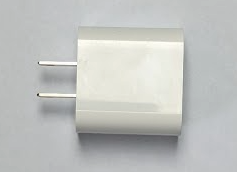
[picture p153: docs/assembly/assets/Screenshot 2024-06-14 at 4.59.59 PM.png]
| 1 | USB-C Charger (Brick) |  |
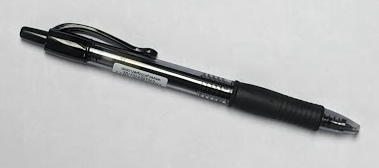
[picture p154: docs/assembly/assets/Screenshot 2024-06-14 at 5.05.18 PM.png]
| 1 | Pilot G-2 Roller Pen |  |

<!-- 
- __1 x__ 3mm allen key
- __1 x__ 2.5mm allen key
- __1 x__ 2mm allen key
- __1 x__ 10mm wrench
- __8 x__ M5x35 Button Cap Screw
- __8 x__ M5x25 Button Cap Screw
- __17 x__ M5 Nut
- __14 x__ M5 T-nut
- __1 x__ M5x20, knurled cylinder head
- __2 x__ Timing Belt Pulley
- __14 x__ M5x10 Button Cap Screw
- __4 x__ less than .5in diameter Rubber Feet
- __8 x__ M3x10 Button Cap Screw
- __1 x__ Carriage
- __5 x__ 1mm tall x 10mm OD x M5 inner Alumninum Spacer
- __1 x__ Tool Head
- __5 x__ 6mm tall x M5 inner Eccentric Spacer
- __1 x__ Printed Rail
- __4 x__ 6mm tall x 8mm OD x M5 inner Alumnium Spacer
- __2 x__ Motor Leg
- __11 x__ 625zz V-Wheel
- __1 x__ 125cm long GT2 Timing Belt
- __1 x__ Belt Clip
- __10 x__ 5x16x5mm flanged bearing
- __1 x__ PCB Mount
- __2 x__ 20mm x 20mm (face) x 250mm (tall) Aluminum Extrusion
- __2 x__ 42mm x 42mm (face) x 38mm (tall) Stepper Motor
- __2 x__ 20mm Stepper motor cables
- __1 x__ PCB - control board
- __1 x__ PCB - power board
- __1 x__ Xiao RP2040
- __2 x__ a4988 stepper motor driver
- __1 x__ Servo (25mm cable) + arm
- __1 x__ Carriage Plate
- __2 x__ usb-c to usb-c cable
- __1 x__ usb-c charger (brick)
- __1 x__ Pilot G-2 roller pen
 -->

### The carriage

The first part of the Blot we will assemble looks like this

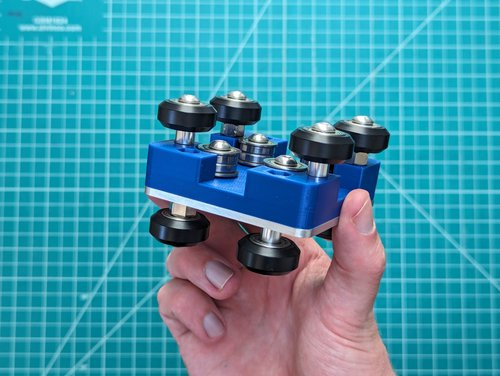
[picture p155: docs/assembly/assets/PXL_20240613_151834051.jpg]


It uses these parts:

- __4 x__ M5x25 Button Cap Screw
- __8 x__ M5x35 Button Cap Screw
- __8 x__ 625zz V-Wheel
- __8 x__ 5x16x5mm flanged bearing
- __4 x__ 6mm tall x 8mm OD x M5 inner Alumnium Spacer
- __12 x__ M5 Nut
- __4 x__ 6mm tall x M5 inner Eccentric Spacer
- __4 x__ 1mm tall x 10mm OD x M5 inner Alumninum Spacer
- __1 x__ Carriage
- __1 x__ Carriage Plate

You'll need these tools:

- __1 x__ 3mm allen key

Align the metal plate with the carriage. It will only align one way.

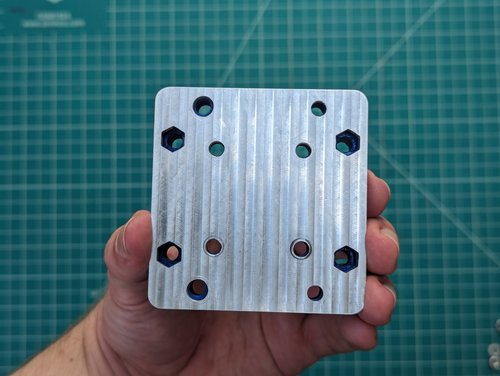
[picture p156: docs/assembly/assets/PXL_20240613_152630413.jpg]


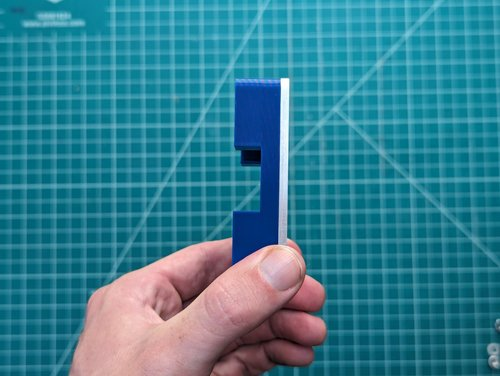
[picture p157: docs/assembly/assets/PXL_20240613_152636094.jpg]


Well start by putting the idlers on. Begin by stacking 2 flanged bearings and a spacer on a 25mm screw.

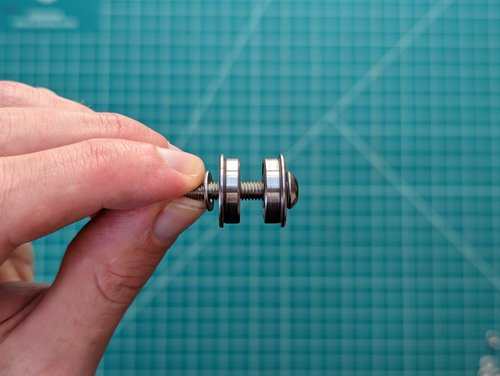
[picture p158: docs/assembly/assets/PXL_20240613_152607361.jpg]


Place that screw through the metal plate and use a nut to secure the assembly.

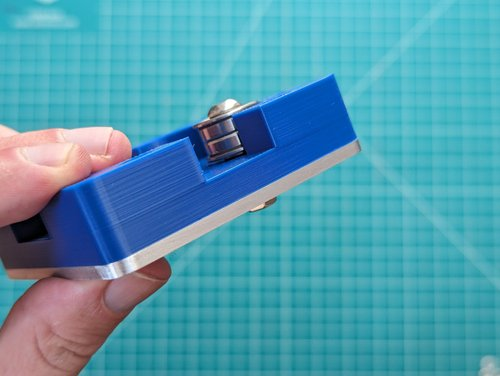
[picture p159: docs/assembly/assets/PXL_20240613_152522824.jpg]


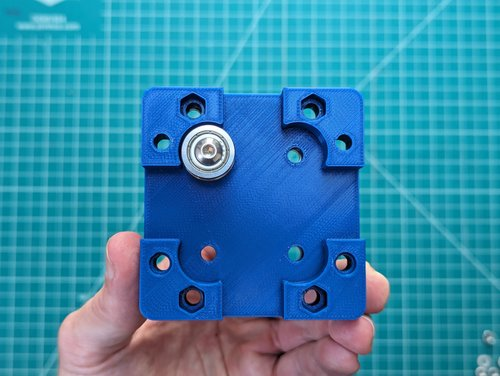
[picture p160: docs/assembly/assets/PXL_20240613_152551176.jpg]


Repeat three more times.

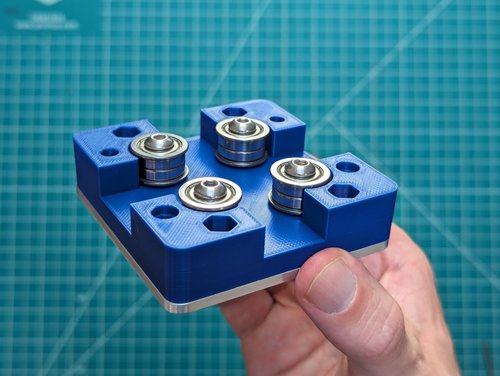
[picture p161: docs/assembly/assets/PXL_20240613_152429973.jpg]


Now let's attach the 8 v-wheels.

You'll notice that some of the holes are a bit larger. We'll place eccentric nuts in them which will allow us to tune the machine.

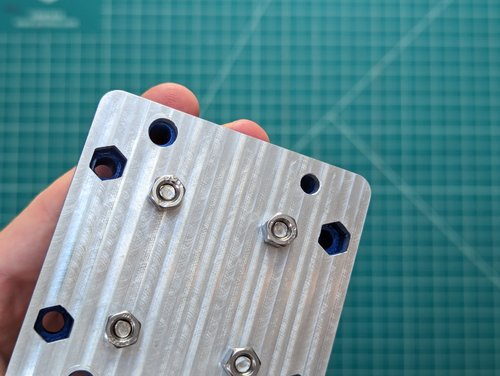
[picture p162: docs/assembly/assets/PXL_20240613_152415197.jpg]


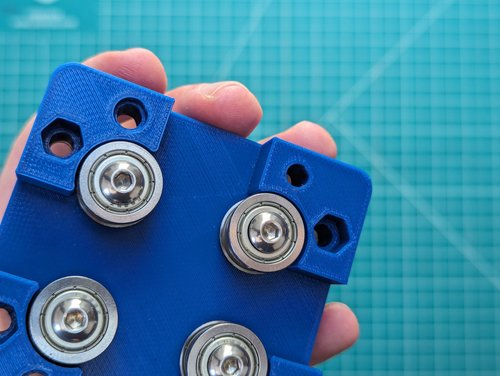
[picture p163: docs/assembly/assets/PXL_20240613_152403096.jpg]


Take a 35mm screw and an eccentric nut. 

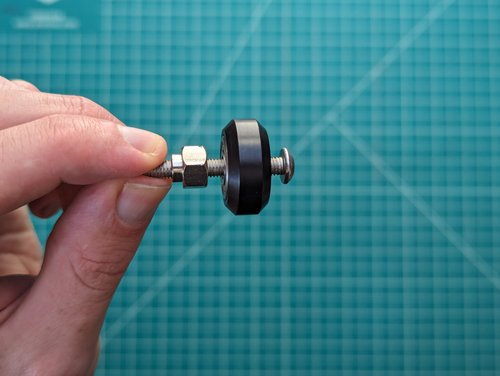
[picture p164: docs/assembly/assets/PXL_20240613_152355368.jpg]


If the washer inside the bearing of the v-wheel is misaligned you can re-align it with an allen key.

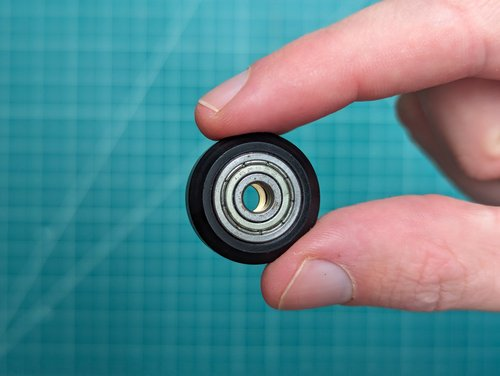
[picture p165: docs/assembly/assets/PXL_20240614_194122312.jpg]


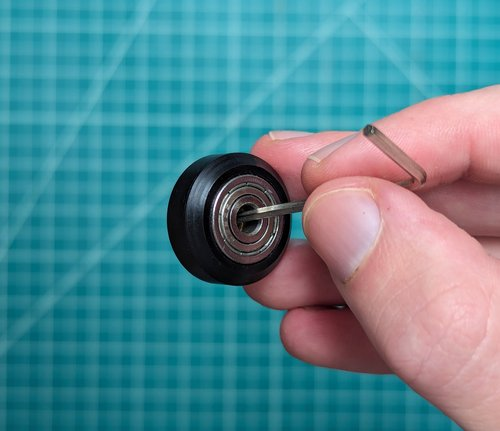
[picture p166: docs/assembly/assets/PXL_20240614_194136096.jpg]


Slip it into one of the larger holes and place a nut in the trap on the alternate side. Then tighten the screw.

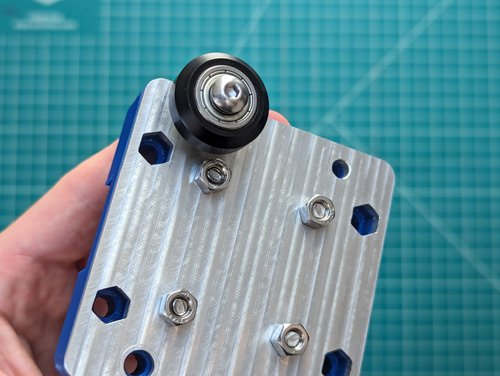
[picture p167: docs/assembly/assets/PXL_20240613_152419653.jpg]


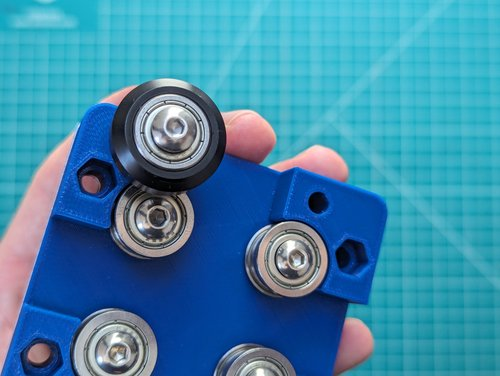
[picture p168: docs/assembly/assets/PXL_20240613_152407701.jpg]


Repeat for the other eccentric nuts.

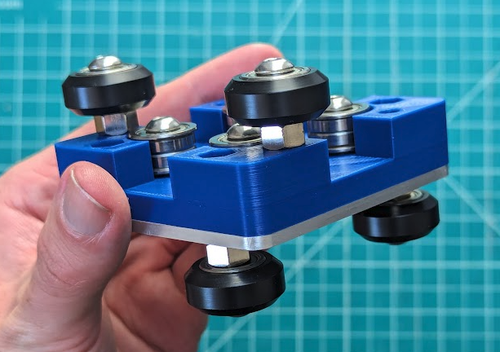
[picture p169: docs/assembly/assets/Screenshot 2024-06-14 at 2.51.48 PM.png]
Screenshot 2024-06-14 at 2.51.48 PM.png


Now let's do the same thing for the non-adjustable v-wheels.

Take a 35mm screw and a 6mm spacer with a v-wheel and assemble like below.

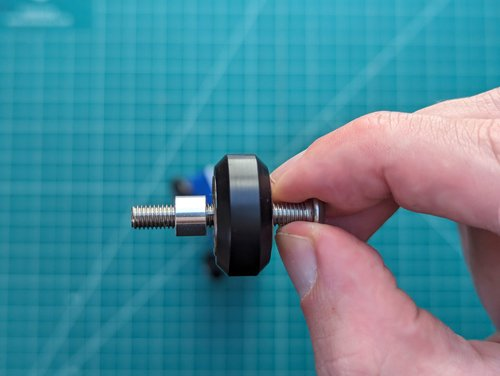
[picture p170: docs/assembly/assets/PXL_20240613_152104229.jpg]


Attach those to the assembly as we did with the other v-wheels. With those attached our assembly is complete.

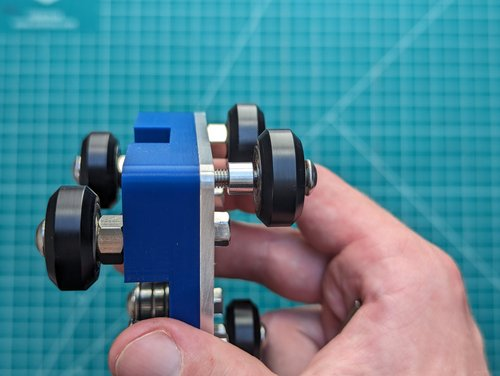
[picture p171: docs/assembly/assets/PXL_20240613_152025462.jpg]


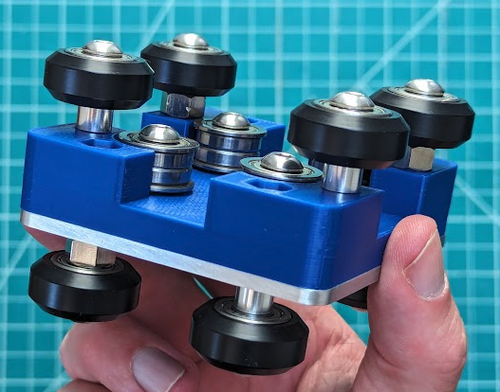
[picture p172: docs/assembly/assets/Screenshot 2024-06-14 at 2.53.51 PM.png]
Screenshot 2024-06-14 at 2.53.51 PM.png


### Leg Assembly

Let's put together the legs of the machine.

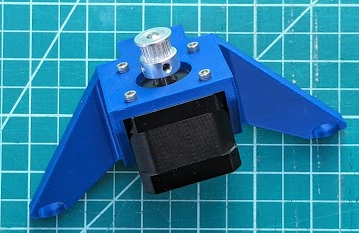
[picture p173: docs/assembly/assets/Screenshot 2024-06-14 at 2.55.39 PM.png]
Screenshot 2024-06-14 at 2.55.39 PM.png


You'll need these parts:

- __2 x__ Timing Belt Pulley
- __4 x__ less than .5in diameter Rubber Feet
- __8 x__ M3x10 Button Cap Screw
- __2 x__ Motor Leg
- __2 x__ 42mm x 42mm (face) x 38mm (tall) Stepper Motors

And these tools:

- __1 x__ 2.5mm allen key
- __1 x__ 2mm allen key

We'll start by placing the timing belt pulley on to the shaft of the stepper motor.

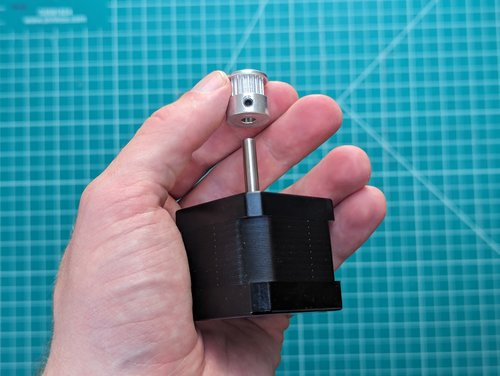
[picture p174: docs/assembly/assets/PXL_20240613_153208987.jpg]


Tighten the set screw with the 2mm allen key.

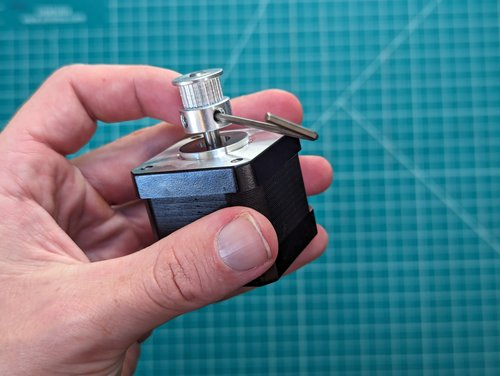
[picture p175: docs/assembly/assets/PXL_20240613_153146330.jpg]


Place the stepper motor into the leg with the cable port fitting into the cutout in the leg.

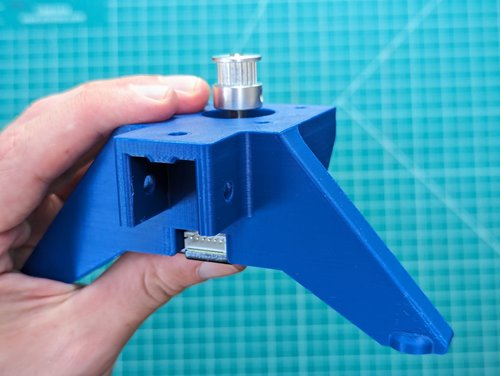
[picture p176: docs/assembly/assets/PXL_20240613_153130455.jpg]


Secure the motor in place with the M3x10mm screws.

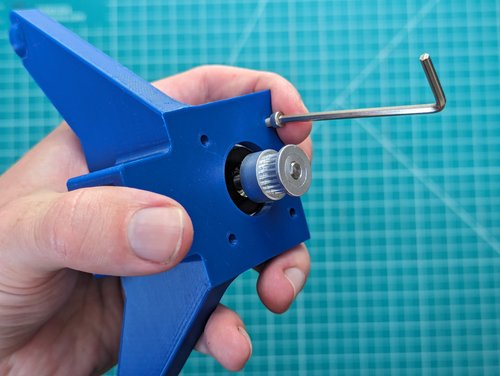
[picture p177: docs/assembly/assets/PXL_20240613_153105454.jpg]


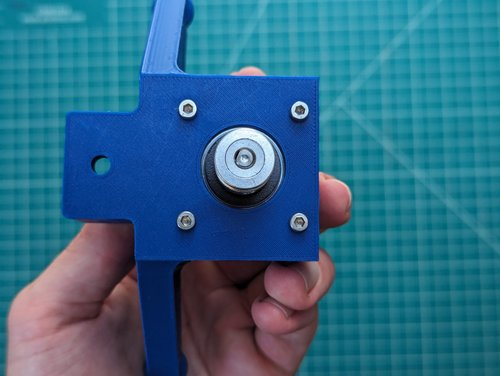
[picture p178: docs/assembly/assets/PXL_20240613_153027084.jpg]


Place the rubber feet on the motor.

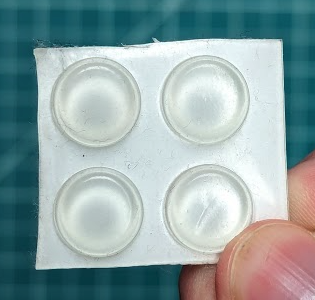
[picture p179: docs/assembly/assets/Screenshot 2024-06-14 at 4.55.06 PM.png]
Screenshot 2024-06-14 at 4.55.06 PM.png


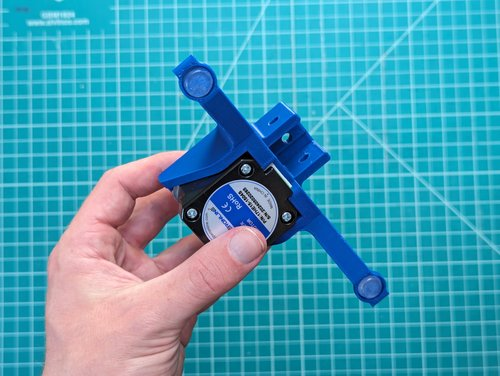
[picture p180: docs/assembly/assets/PXL_20240613_153004363.jpg]


We're done!

### Pen Rail

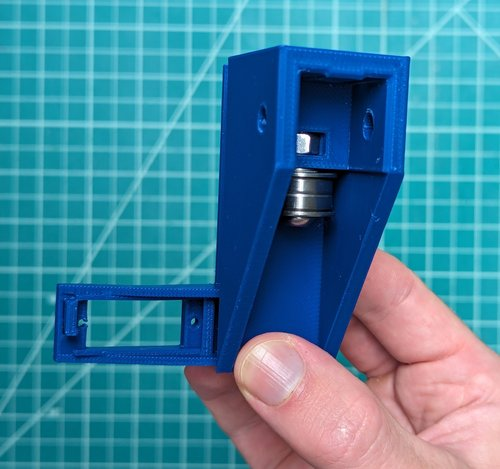
[picture p181: docs/assembly/assets/PXL_20240614_194305820.jpg]


To put together the pen rail you'll need:

- __1 x__ 3mm allen key
- __1 x__ M5x25 Button Cap Screw
- __1 x__ M5 Nut
- __1 x__ 1mm tall x 10mm OD x M5 inner Alumninum Spacer
- __1 x__ Printed Rail
- __2 x__ 5x16x5mm flanged bearing
- __1 x__ Servo (25mm cable) + arm

You'll need these tools:

- __1 x__ 3mm allen key

First put together another idler stack on a M5x25 screw.

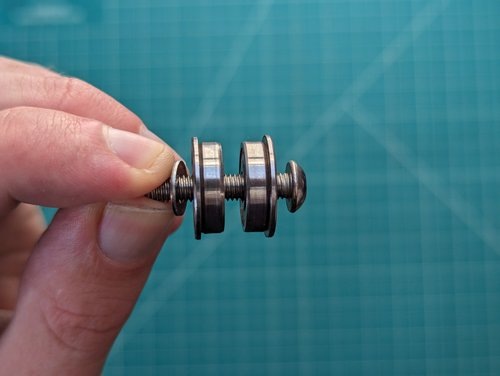
[picture p182: docs/assembly/assets/PXL_20240613_152955990.jpg]


Place a nut into the cutout on the printer rail and secure the idler to it.

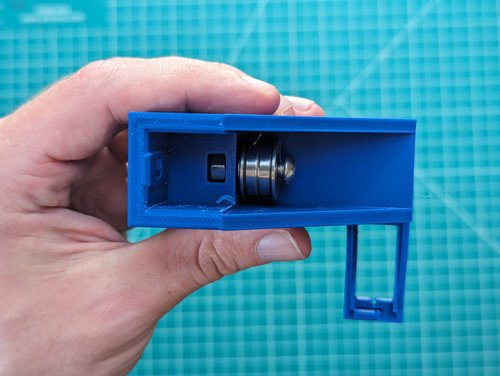
[picture p183: docs/assembly/assets/PXL_20240613_152921999.jpg]


### Pen Holder

Let's make the pen holder.

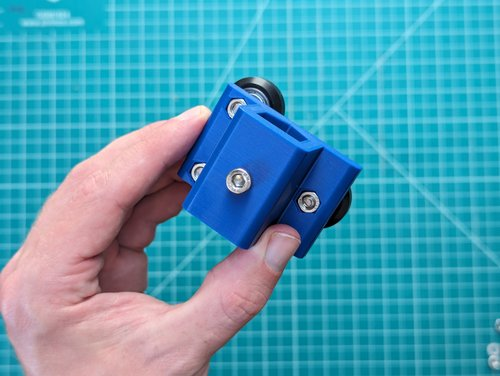
[picture p184: docs/assembly/assets/PXL_20240613_152656940.jpg]


You'll need these parts:

- __3 x__ M5x25 Button Cap Screw
- __4 x__ M5 Nut
- __1 x__ M5x20, knurled cylinder head
- __1 x__ Tool Head
- __1 x__ 6mm tall x M5 inner Eccentric Spacer
- __3 x__ 625zz V-Wheel

You'll need these tools:

- __1 x__ 3mm allen key

Let's add the eccentric wheel first. Make a stack with the M5x25 screw like so

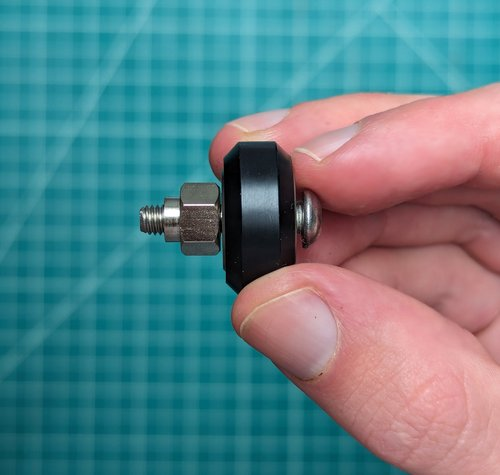
[picture p185: docs/assembly/assets/PXL_20240614_194327740.jpg]


Attach it to the pen holder by slipping it through the printed part and securing a nut on the back.

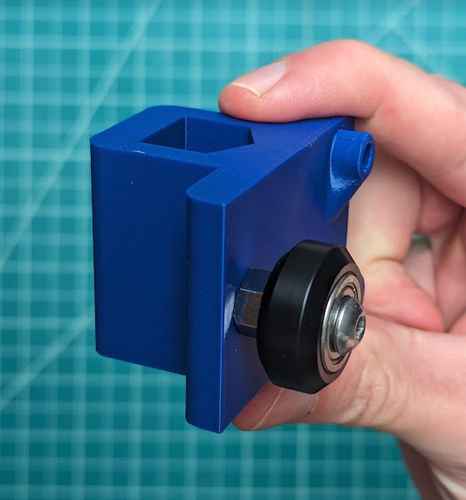
[picture p186: docs/assembly/assets/Screenshot 2024-06-14 at 4.54.00 PM.png]
Screenshot 2024-06-14 at 4.54.00 PM.png


Attach the two fixed wheels with the remaining 2 M5x25 screws. 

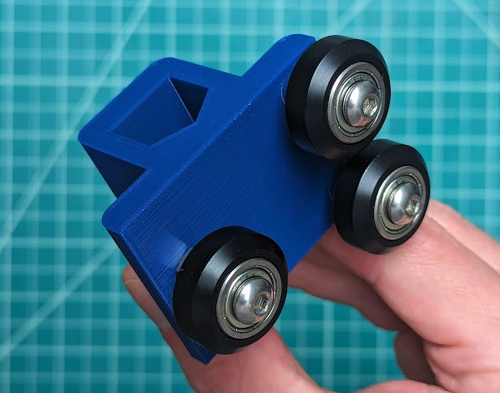
[picture p187: docs/assembly/assets/Screenshot 2024-06-14 at 4.54.30 PM.png]
Screenshot 2024-06-14 at 4.54.30 PM.png


Slip the nut into the trap on front portion of the pen holder and secure it with the knurled screw. We'll use this screw to clamp tools we place in the holder.

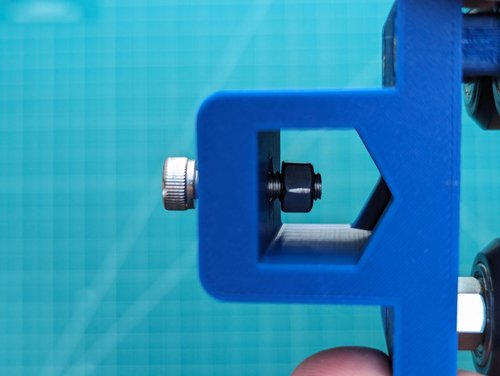
[picture p188: docs/assembly/assets/PXL_20240613_152706298.jpg]


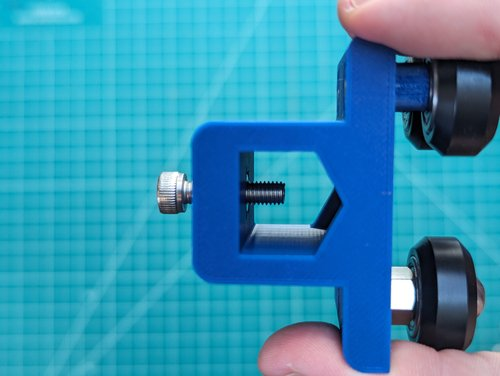
[picture p189: docs/assembly/assets/PXL_20240613_152716570.jpg]


### Putting the machine together

Now we're ready for the machine to really come together. It will look like this.

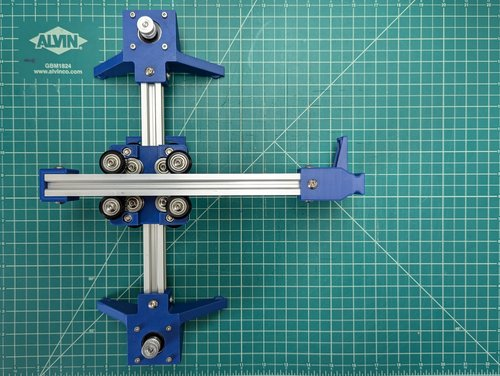
[picture p190: docs/assembly/assets/PXL_20240710_173812284.jpg]


You'll need these parts in addition to the sub-assemblies you just put together.

- **14 x** M5 T-nut
- **14 x** M5x10 Button Cap Screw
- **1 x** Belt Clip
- **1 x** PCB Mount
- **2 x** 20mm x 20mm (face) x 250mm (tall) Aluminum Extrusion

Additionally, you'll need these tools:

- **1 x** 3mm allen key
- **1 x** 10mm wrench

Begin by taking a piece of aluminum extrusion and inserting the t-nuts. I prefer to place the hole closer to the center of the bar. This will make the t-nut not visible when the part is mounted to it.

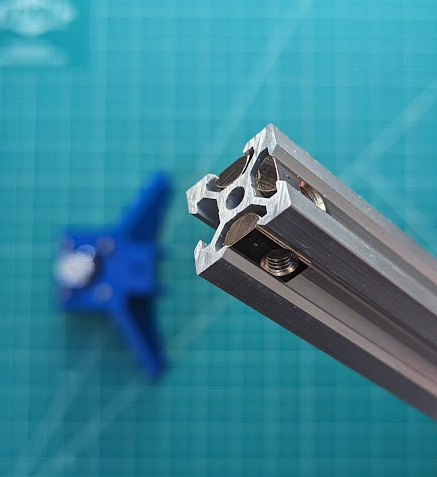
[picture p191: docs/assembly/assets/Screenshot 2024-06-14 at 3.06.42 PM.png]
Screenshot 2024-06-14 at 3.06.42 PM.png


Place one of the legs on top of the end of the bar.

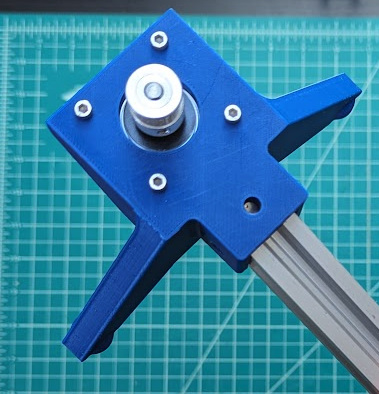
[picture p192: docs/assembly/assets/Screenshot 2024-06-14 at 3.12.42 PM.png]
Screenshot 2024-06-14 at 3.12.42 PM.png


Secure it in place with M5x10 screws.

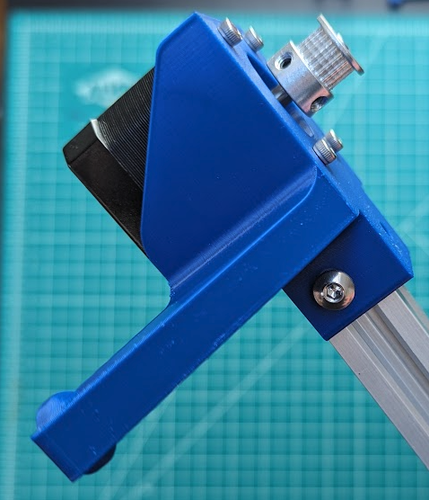
[picture p193: docs/assembly/assets/Screenshot 2024-06-14 at 3.13.31 PM.png]
Screenshot 2024-06-14 at 3.13.31 PM.png


If the T-nut is misaligned, you can center it with the allen key.

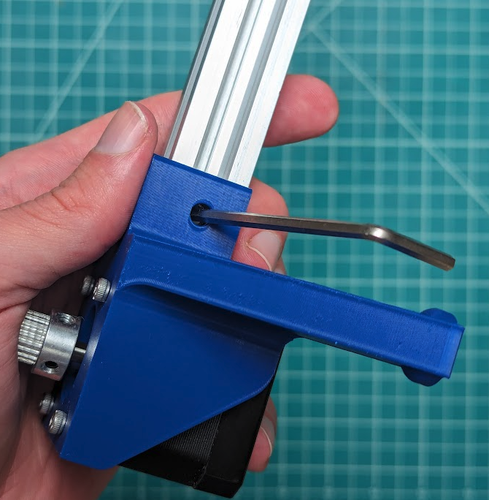
[picture p194: docs/assembly/assets/Screenshot 2024-06-14 at 4.57.55 PM.png]
Screenshot 2024-06-14 at 4.57.55 PM.png


Adjust the eccentric nuts on the carriage to make it loosely fit on the rail.

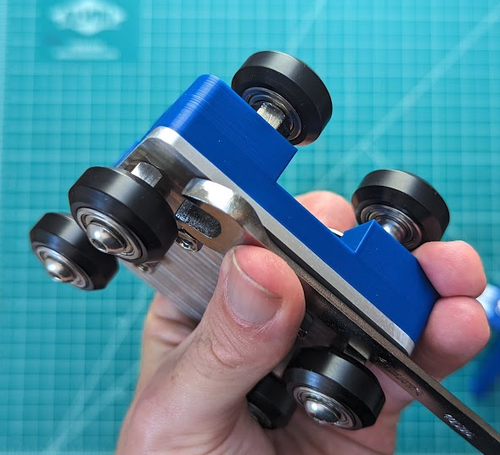
[picture p195: docs/assembly/assets/Screenshot 2024-06-14 at 3.15.43 PM.png]
Screenshot 2024-06-14 at 3.15.43 PM.png


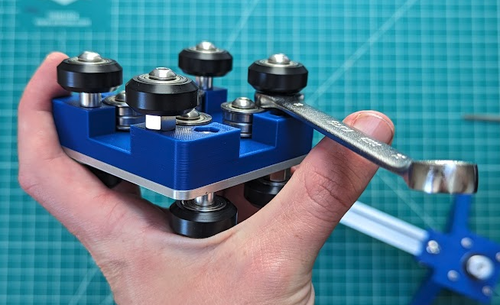
[picture p196: docs/assembly/assets/Screenshot 2024-06-14 at 3.15.35 PM.png]
Screenshot 2024-06-14 at 3.15.35 PM.png


Now slide the carriage onto the rail. Notice how the aluminum plate faces the aluminum extrusion.

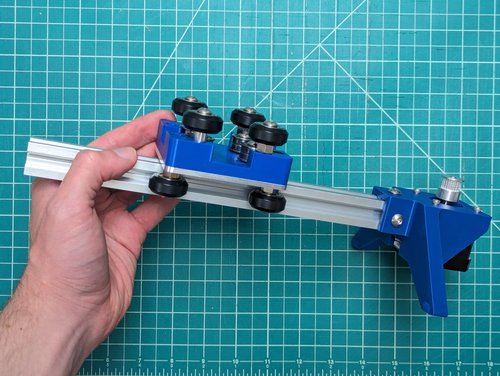
[picture p197: docs/assembly/assets/PXL_20240614_194805182.jpg]


You can now adjust the nuts to make the wheels ride snugly. Don't make it too tight, just tight enough that the carriage doesn't rock back and fourth.

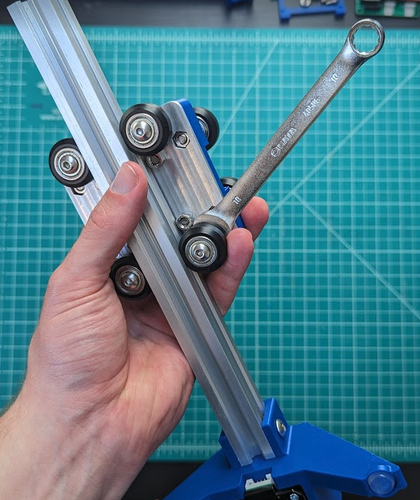
[picture p198: docs/assembly/assets/Screenshot 2024-06-14 at 3.18.43 PM.png]
Screenshot 2024-06-14 at 3.18.43 PM.png


Now add the other leg.

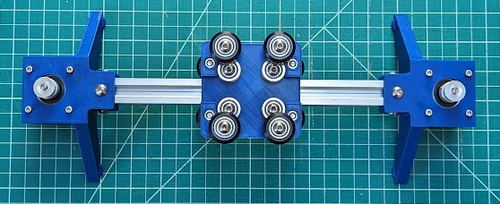
[picture p199: docs/assembly/assets/Screenshot 2024-06-14 at 3.20.36 PM.png]
Screenshot 2024-06-14 at 3.20.36 PM.png


Time to add the top rail.

Attach the printed pen rail to one end of the other extrusion.

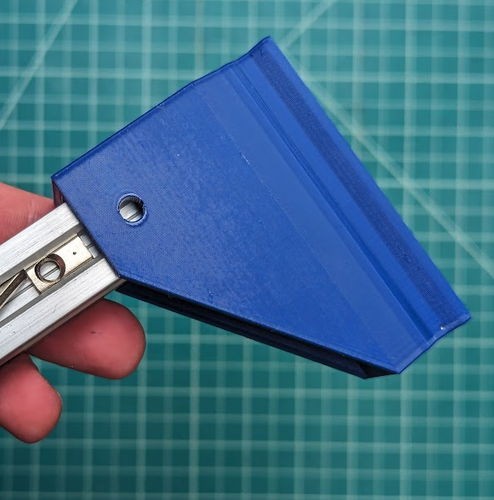
[picture p200: docs/assembly/assets/Screenshot 2024-06-14 at 4.57.06 PM.png]
Screenshot 2024-06-14 at 4.57.06 PM.png


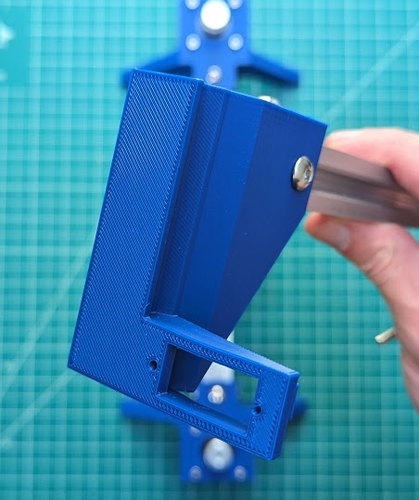
[picture p201: docs/assembly/assets/Screenshot 2024-06-14 at 3.21.55 PM.png]
Screenshot 2024-06-14 at 3.21.55 PM.png


Place that exstrusion on the carriage, adjusting the v-wheels as shown above.

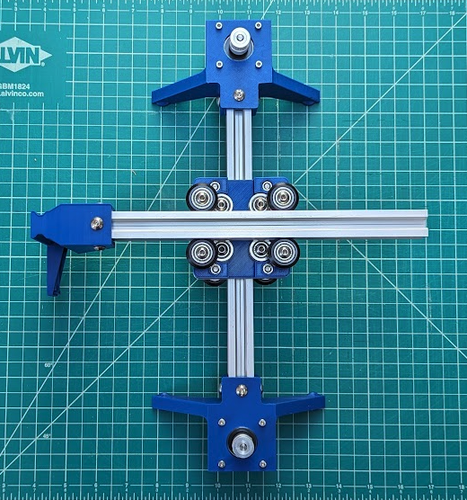
[picture p202: docs/assembly/assets/Screenshot 2024-06-14 at 3.22.09 PM.png]
Screenshot 2024-06-14 at 3.22.09 PM.png


Attach the belt clip to the end of the carriage facing down and secure it in place with M5x10 screws and t-nuts.

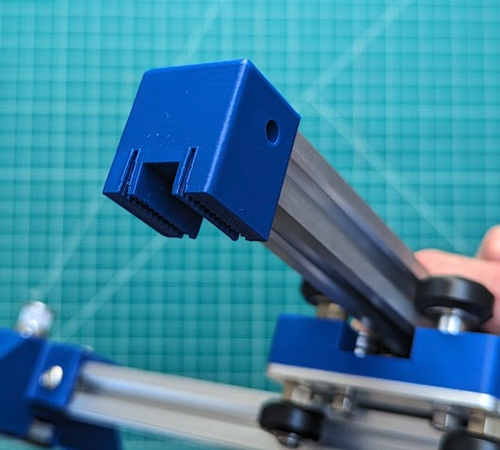
[picture p203: docs/assembly/assets/Screenshot 2024-06-14 at 3.22.24 PM.png]
Screenshot 2024-06-14 at 3.22.24 PM.png


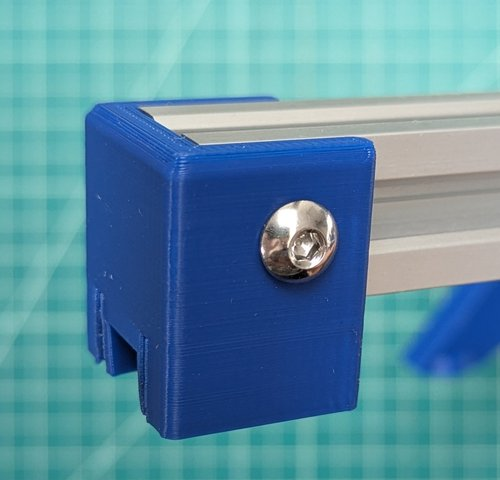
[picture p204: docs/assembly/assets/PXL_20240710_173838750.jpg]


Flip the machine upside down and use the remaining two T-nuts to attach the motor mount.

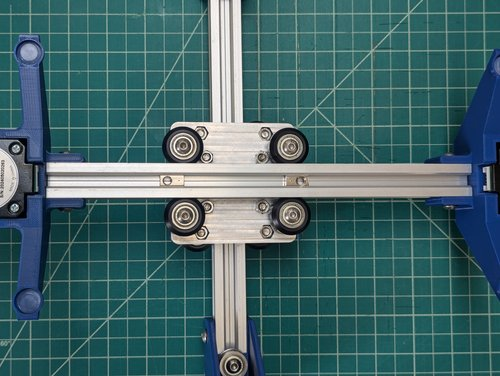
[picture p205: docs/assembly/assets/PXL_20240616_224208232.jpg]


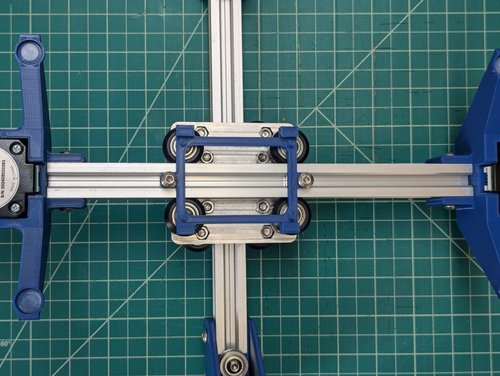
[picture p206: docs/assembly/assets/PXL_20240616_224219934.jpg]


### Threading the Timing Belt

For this step, you'll need the assembly you just made and the timing belt.

- **1 x** 125cm long GT2 Timing Belt

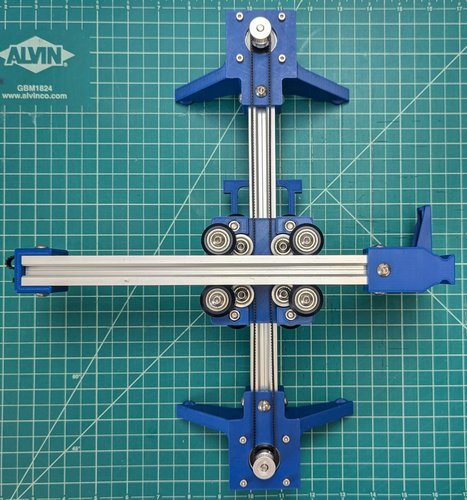
[picture p207: docs/assembly/assets/PXL_20240616_224848871-EDIT.jpg]


To start, turn the machine upside down.

We'll place one loop of the belt in the endcap.

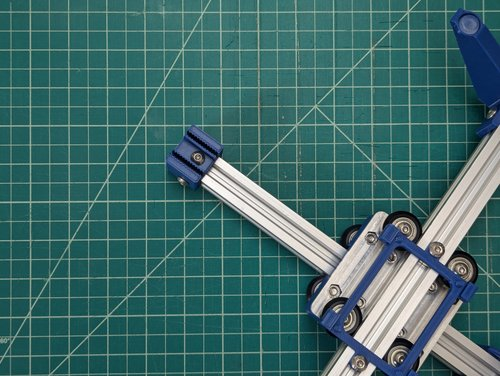
[picture p208: docs/assembly/assets/PXL_20240616_224234414.jpg]


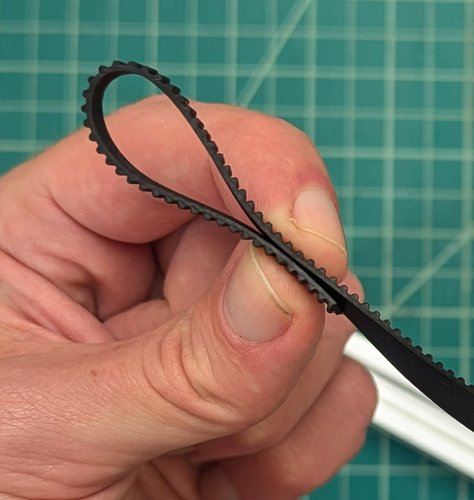
[picture p209: docs/assembly/assets/PXL_20240616_224501571.jpg]


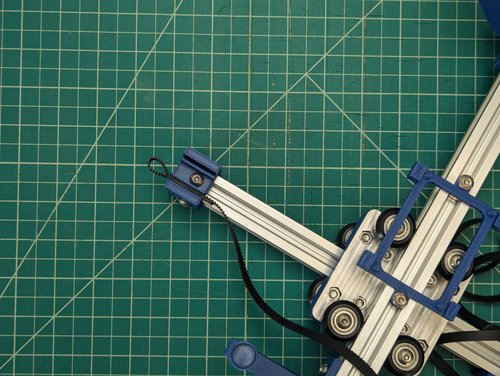
[picture p210: docs/assembly/assets/PXL_20240616_224512659.jpg]


Thread the belt through the carriage so a loop sticks out the other side.

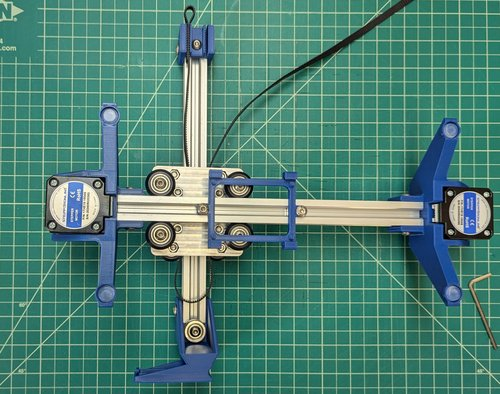
[picture p211: docs/assembly/assets/PXL_20240616_224602213-EDIT.jpg]


Place that loop over the idler.

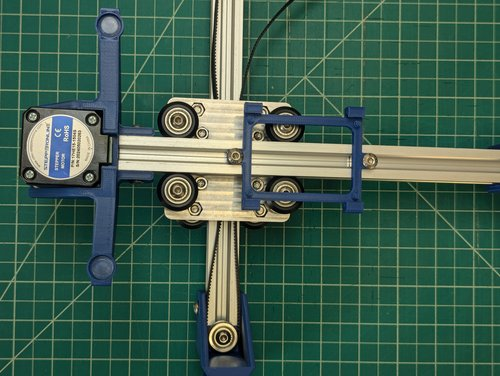
[picture p212: docs/assembly/assets/PXL_20240616_224618886.jpg]


I now flip the Blot right-side up and use an allen key to push one loop of belt out.

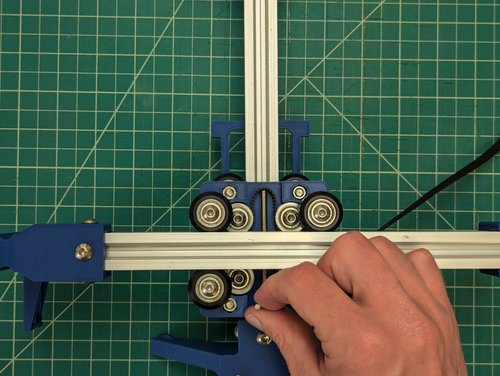
[picture p213: docs/assembly/assets/PXL_20240616_224657500.jpg]


Run that loop over one of the stepper motor pulleys.

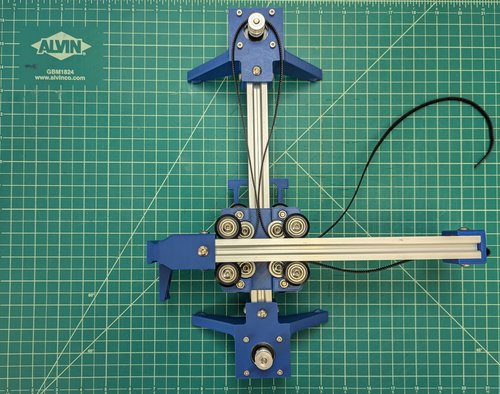
[picture p214: docs/assembly/assets/PXL_20240616_224711395-EDIT.jpg]


Now repeat for the other side.

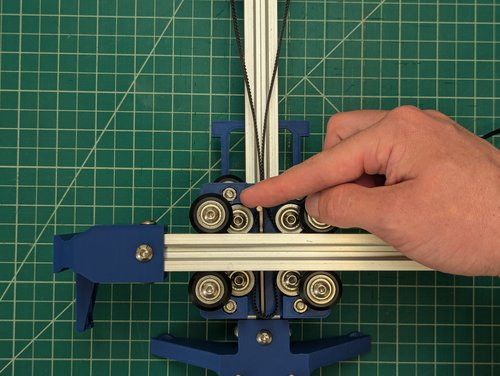
[picture p215: docs/assembly/assets/PXL_20240616_224721466.jpg]


Pull the belt tight around the stepper motor pulley.

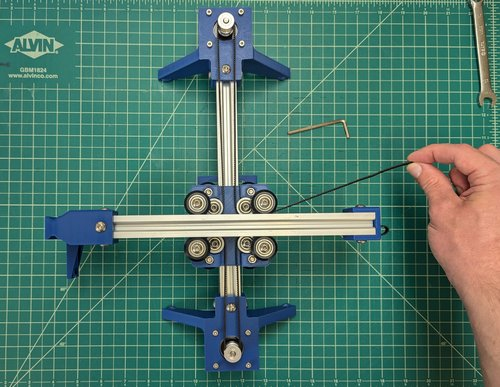
[picture p216: docs/assembly/assets/PXL_20240616_224732150-EDIT.jpg]


Flip the Blot over and fold the belt to push into the other side of the belt clamp. Make sure to pull the belt tight.

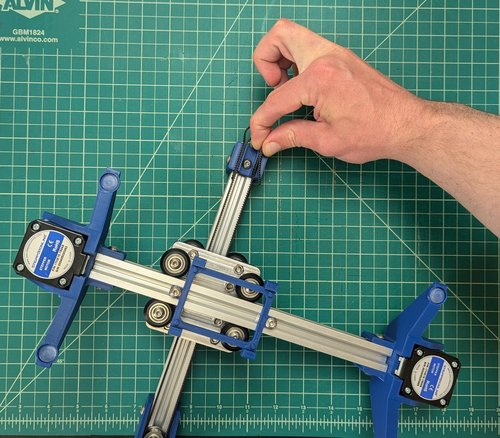
[picture p217: docs/assembly/assets/PXL_20240616_224744034-EDIT.jpg]


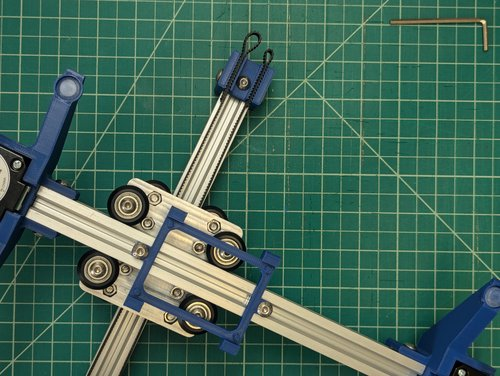
[picture p218: docs/assembly/assets/PXL_20240616_224824785.jpg]


Congratulations! You've finished putting together the mechanical parts of the Blot.



### Wiring

- **1 x** PCB - control board
- **1 x** Xiao RP2040
- **2 x** a4988 stepper motor driver
- **1 x** Servo (25mm cable) + arm
- **2 x** 20mm Stepper motor cables

Insert the servo into the press fit holder. I place it so the arm is closer to the rail.

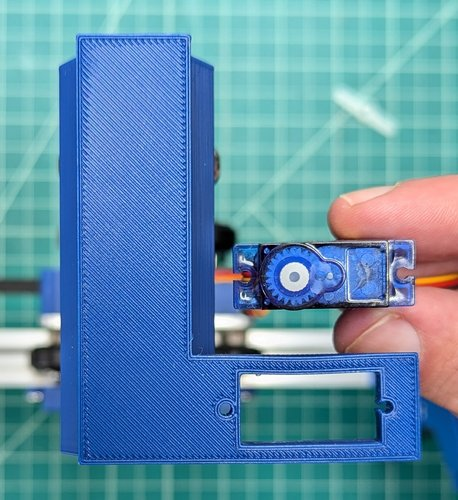
[picture p219: docs/assembly/assets/PXL_20240710_152651622.jpg]


You first slip one side underneath the ledge.

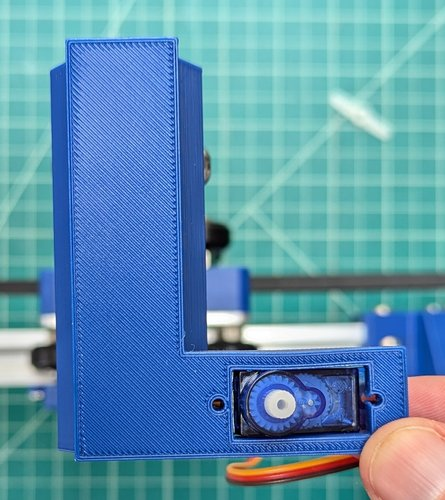
[picture p220: docs/assembly/assets/PXL_20240710_152707402.jpg]


Then push down on the outside edge.

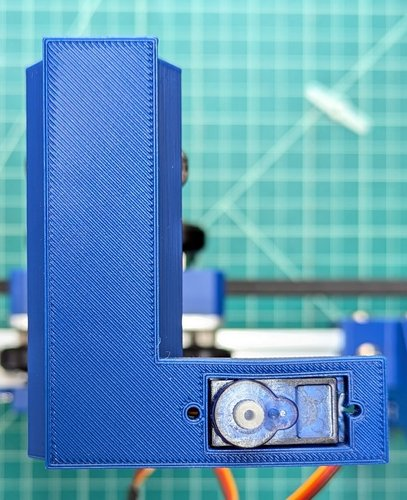
[picture p221: docs/assembly/assets/PXL_20240710_152716148.jpg]


Add the lever arm.

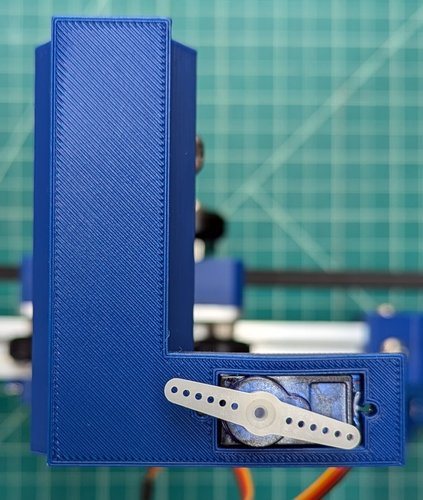
[picture p222: docs/assembly/assets/PXL_20240710_152727819.jpg]


And we're done with this part.

Now assemble the control board

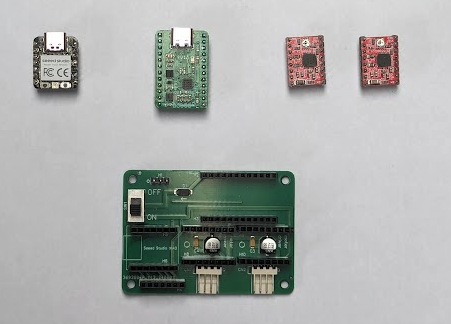
[picture p223: docs/assembly/assets/Screenshot 2024-06-14 at 5.05.37 PM.png]


Make sure the potentiometers (round metal things) on the red boards are on the side with the black control board (Xiao).

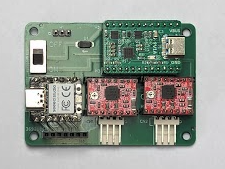
[picture p224: docs/assembly/assets/Screenshot 2024-06-14 at 5.05.22 PM.png]
Screenshot 2024-06-14 at 5.05.22 PM.png


Insert the control board into the machine.

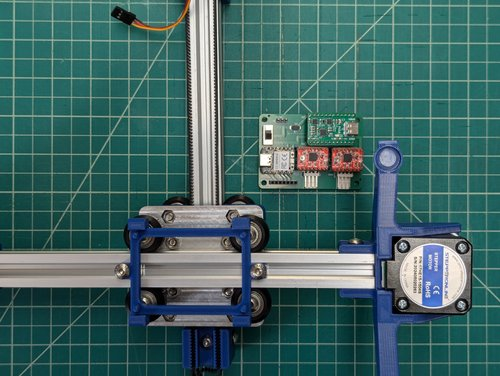
[picture p225: docs/assembly/assets/PXL_20240710_152750435.jpg]


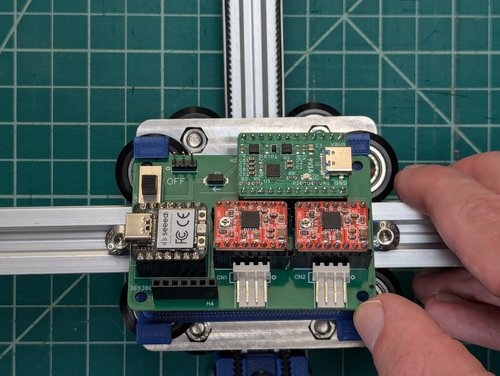
[picture p226: docs/assembly/assets/PXL_20240710_152814880.jpg]


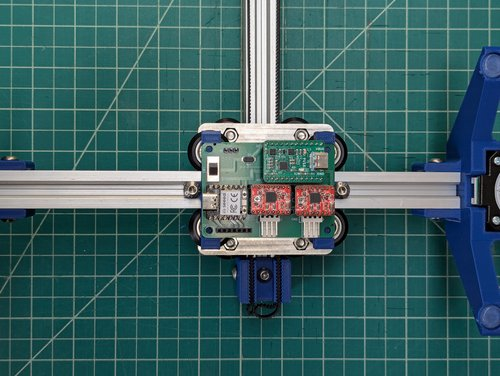
[picture p227: docs/assembly/assets/PXL_20240710_152838809.jpg]


Plug in all the wires.

First, plug in the servo motor wires. That's the brown, red, yellow wires. 

It's **very important** that the brown wire be on the side with the little circle. That means the metal pins will be on the inner side of the board (not facing the outer edge).

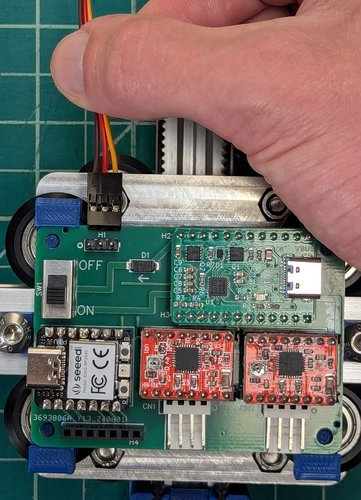
[picture p228: docs/assembly/assets/PXL_20240710_152930835.jpg]


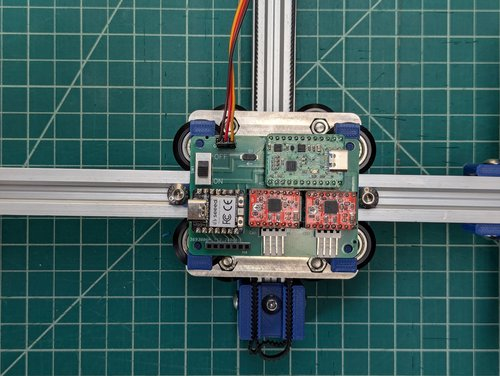
[picture p229: docs/assembly/assets/PXL_20240710_152940275.jpg]


Now plug in the stepper motor wires.

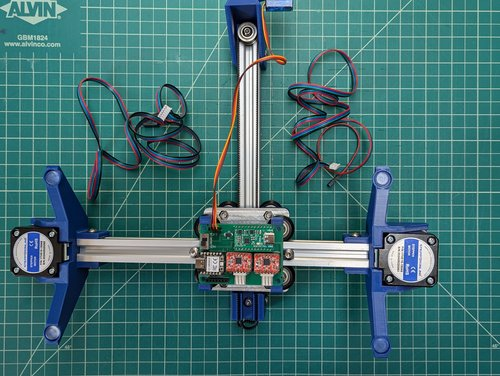
[picture p230: docs/assembly/assets/PXL_20240710_153006966.jpg]


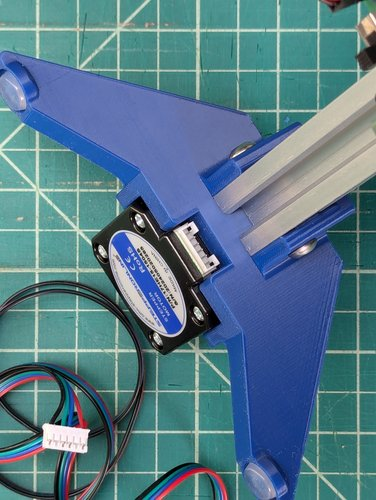
[picture p231: docs/assembly/assets/PXL_20240710_153039436.jpg]


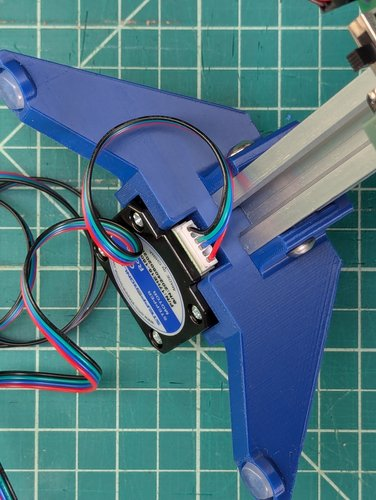
[picture p232: docs/assembly/assets/PXL_20240710_153050172.jpg]


The wires are a bit too long.

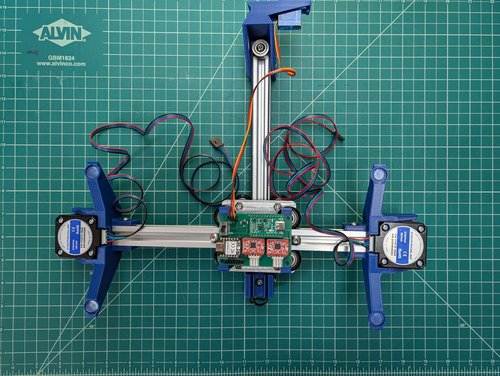
[picture p233: docs/assembly/assets/PXL_20240710_153101137.jpg]


I like to address this by wrapping them around the feet of the Blot when they are plugged in. This can be down in different ways.

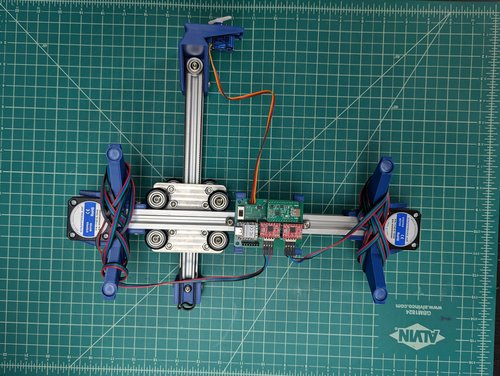
[picture p234: docs/assembly/assets/PXL_20240710_160946631.jpg]


The machine will work with any configuration of how the stepper motor pins are plugged in. Depending on how your stepper motors are plugged in the drawing may be mirrored. You can correct this by changing whether the motors are plugged in with the metal pins showing face up or hidden face down. The correct orientation may be some combination of the two. I'll note this again when we cover setting the machine origin.

Note stepper motors plugged in with the metal pins up.

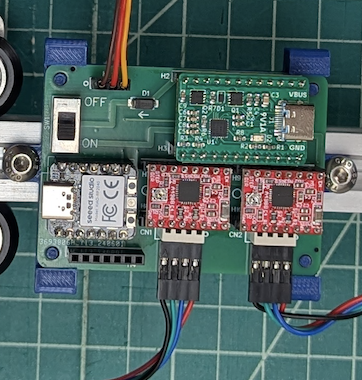
[picture p235: docs/assembly/assets/Screenshot 2024-07-10 at 1.29.35 PM.png]


Note stepper motors plugged in with the metal pins down.

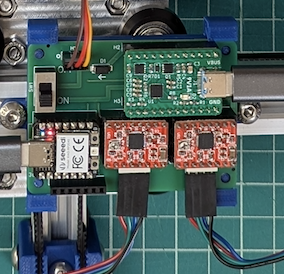
[picture p236: docs/assembly/assets/Screenshot 2024-07-10 at 1.29.09 PM.png]
Screenshot 2024-07-10 at 1.29.09 PM.png


Adjust the eccentric nut on the pen carriage so it rides smoothly. Not too tight. Just tight enough not to jiggle.

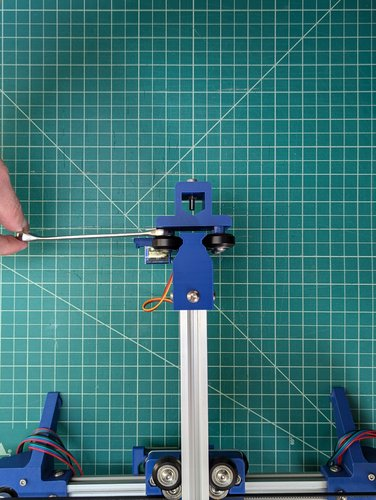
[picture p237: docs/assembly/assets/PXL_20240710_153344534.jpg]


Ready to run.

### Running Your Blot

Now it's time to run your Blot. 

[Check out a quick video demonstrating how to run a Blot here.](https://youtu.be/qDP5CNjFHJE)

To run your Blot you'll have to:

- Flash firmware to your Blot
- Connecting
  - Power your Blot.
  - Connect it to the web editor.
- Home your machine (set the origin).
- Fixture paper to draw on.
- Set the lever on the servo.
- Set the pen height for drawing.

__Flashing Firmware__

The first step to running your Blot is to flash the Blot firmware to the Xiao.

[You can download the firmware here.](https://github.com/hackclub/blot/raw/main/hardware/motor-control-board/firmware/uf2/firmware.ino.uf2)

First hold down the boot button (right button with a small `B` next to it) on your Xiao and then plug it into your computer.

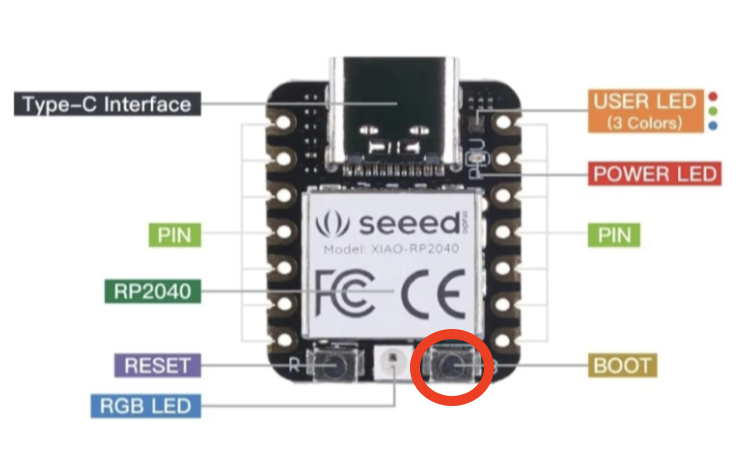
[picture p238: docs/assembly/assets/xiao-labelled.png]


It should appear as a drive.

Next drop the firmware `.uf2` file onto drive.

Now the firmware is flashed.

__Connecting__

To power the Blot plug it into the USB-C brick that comes with your machine. Any USB-C brick that can deliver at least 20W should work. The Blot expects 9V 1A.

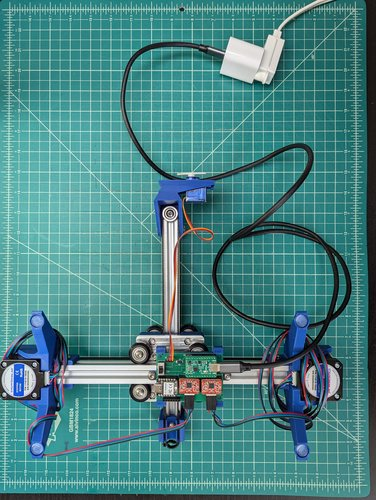
[picture p239: docs/assembly/assets/PXL_20240710_153733136.jpg]


Connect your Blot to the web editor by plugging the Xiao in over USB.

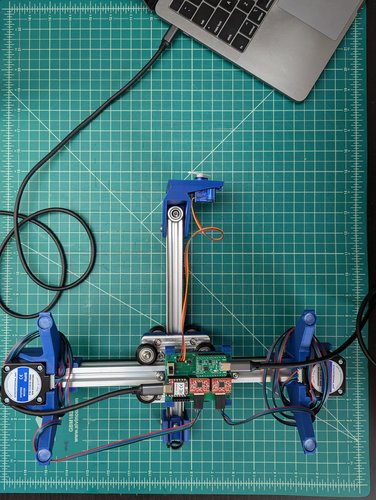
[picture p240: docs/assembly/assets/PXL_20240710_153841116.jpg]


Connect to your Blot by hovering over `Machine control` and selecting `Connect to machine`

Screenshot 2024-07-10 at 5.05.53 PM.png

If this is the first time you've connected with this Blot you'll get a pop-up to authorize the web serial connection. Select the item that says "Xiao".

__Homing__

To home your Blot.

Turn off the motors.

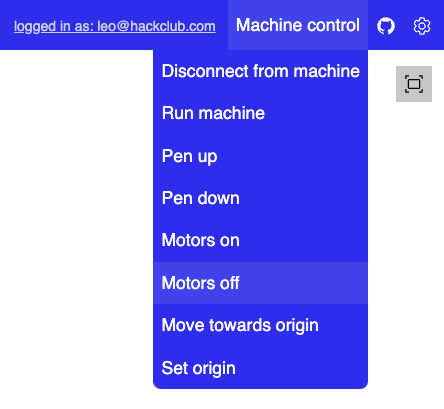
[picture p241: docs/assembly/assets/Screenshot 2024-07-10 at 4.58.46 PM.png]
Screenshot 2024-07-10 at 4.58.46 PM.png


Manually move the Blot to the center position.

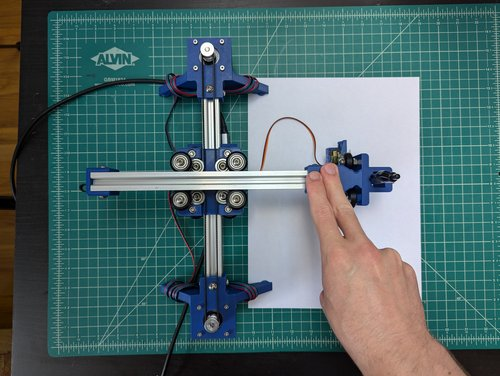
[picture p242: docs/assembly/assets/PXL_20240710_183002315.jpg]


Turn on the motors.

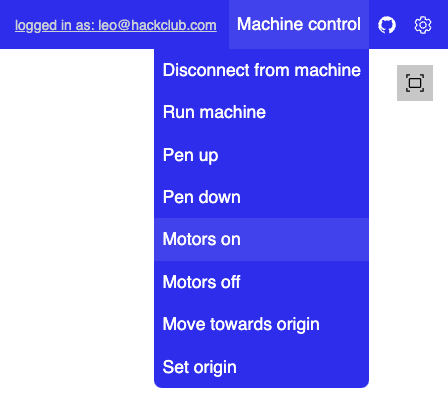
[picture p243: docs/assembly/assets/Screenshot 2024-07-10 at 4.59.27 PM.png]
Screenshot 2024-07-10 at 4.59.27 PM.png


Click `Move towards origin`. Note which corner the Blot moves towards.

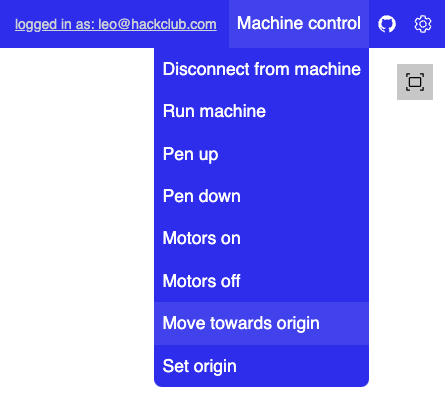
[picture p244: docs/assembly/assets/Screenshot 2024-07-10 at 5.00.16 PM.png]
Screenshot 2024-07-10 at 5.00.16 PM.png


Turn off the motors.

Screenshot 2024-07-10 at 4.58.46 PM.png

Manually move your Blot all the way to the corner it moved towards.

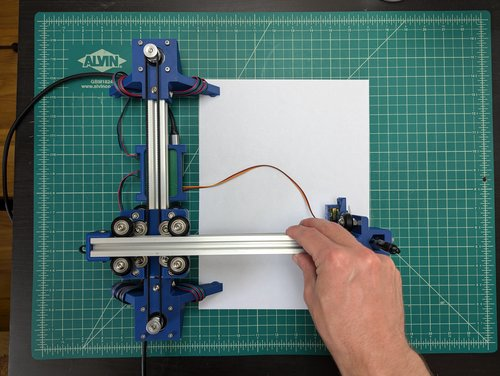
[picture p245: docs/assembly/assets/PXL_20240710_174439847.jpg]


Click `Set Origin`.

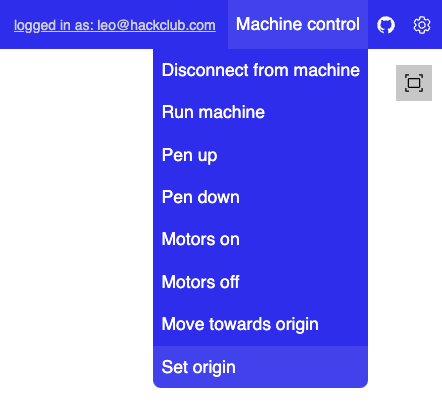
[picture p246: docs/assembly/assets/Screenshot 2024-07-10 at 5.01.21 PM.png]
Screenshot 2024-07-10 at 5.01.21 PM.png


Turn on the motors.

Screenshot 2024-07-10 at 4.59.27 PM.png

Depending on how your stepper motors are plugged in the drawing may be mirrored. You can correct this by changing whether the motors are plugged in with the metal pins showing face up or hidden face down. The correct orientation may be some combination of the two.

__Fixturing Paper__

Secure a piece of paper to draw on. I generally tape (or magnet down) the other side of the paper too.

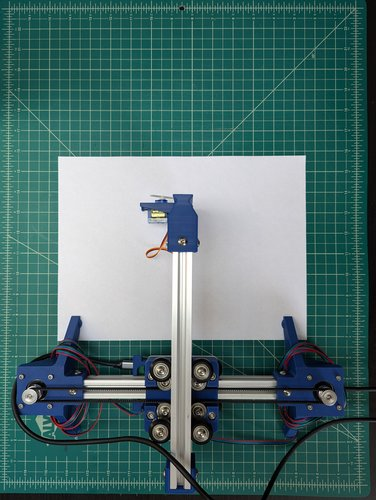
[picture p247: docs/assembly/assets/PXL_20240710_153943015.jpg]


__Setting Lever__

The servo lever lifts the pen. To set the servo lever range properly.

Remove the lever arm from the servo.

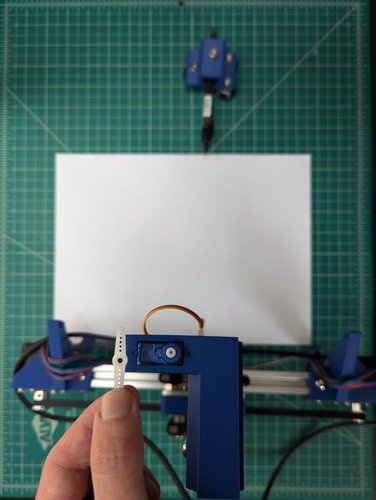
[picture p248: docs/assembly/assets/PXL_20240710_154016398.jpg]


Set the pen to the up position in the editor.

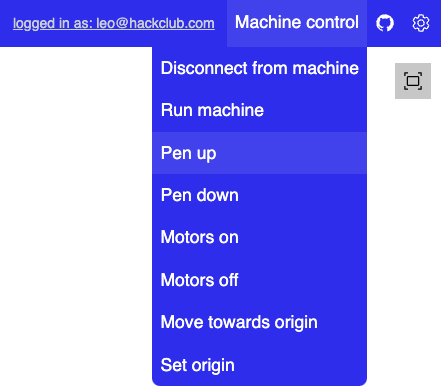
[picture p249: docs/assembly/assets/Screenshot 2024-07-10 at 5.01.58 PM.png]
Screenshot 2024-07-10 at 5.01.58 PM.png


Place the lever arm back on in the up position.

__Setting the Pen Height__

Loosen the set screw on the pen.

Move the pen to be just above the paper in the up position.

It should look like this when you are done.

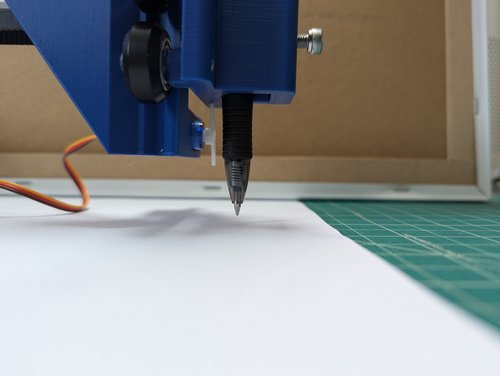
[picture p250: docs/assembly/assets/PXL_20240710_154152531.jpg]


__Draw!__

Pull up the art piece you want to draw in the code editor.

Hit `Run` to render the piece in the editor.

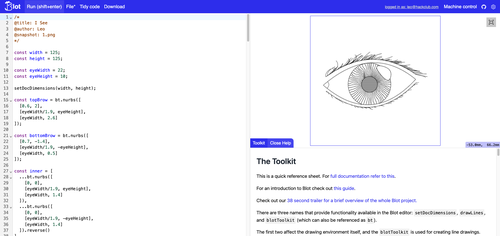
[picture p251: docs/assembly/assets/Screenshot 2024-07-10 at 5.07.56 PM.png]
Screenshot 2024-07-10 at 5.07.56 PM.png


Then hover over `Machine control` and select `Run machine`.

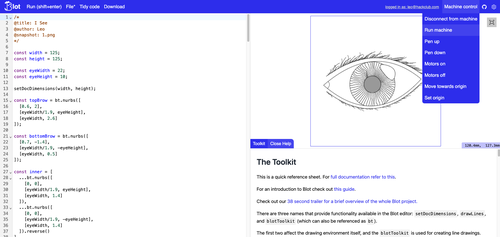
[picture p252: docs/assembly/assets/Screenshot 2024-07-10 at 5.08.35 PM.png]
Screenshot 2024-07-10 at 5.08.35 PM.png


Note that you must keep this tab active, or the communication speed (and your machine) will slow down. If you want to do something else on the computer just move the tab to a new window.

Watch Blot turn the code into a real thing.

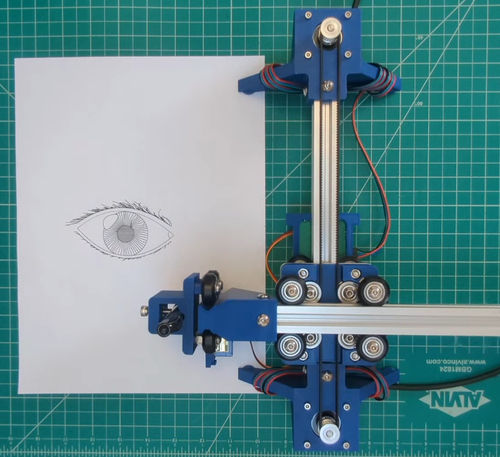
[picture p253: docs/assembly/assets/Screenshot 2024-07-11 at 2.01.34 PM.png]
Screenshot 2024-07-11 at 2.01.34 PM.png


For best results, I like to use a whiteboard ([which I bought for $10 at Target](https://www.amazon.com/Brand-Frameless-Magnetic-Dry-Erase-Board/dp/B0845T7JLC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)) with magnets to provide a flat surface and hold down paper.

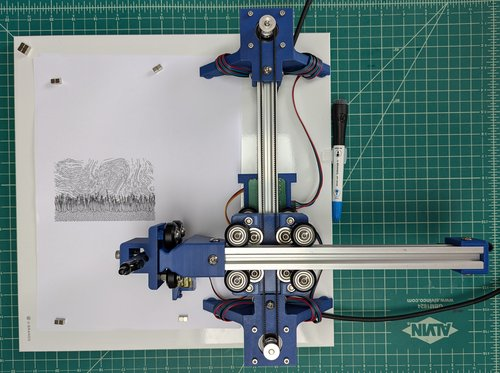
[picture p254: docs/assembly/assets/PXL_20240711_150846841.jpg]


### Send us a Postcard

We're building a Blot art wall back at HQ. After you build your machine pick up a local postcard and use Blot to draw your art on the back.

I picked up this cool vintage postcard from the antique store next door to Hack Club HQ. It shows a Vermont lake.

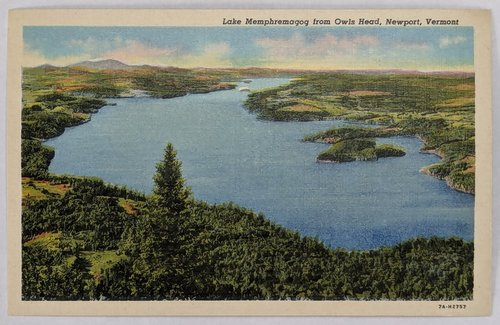
[picture p255: docs/assembly/assets/PXL_20240711_181315601.jpg]


Here it is with my art piece drawn on the back. Ready to send to HQ.

Make sure you sign it too!

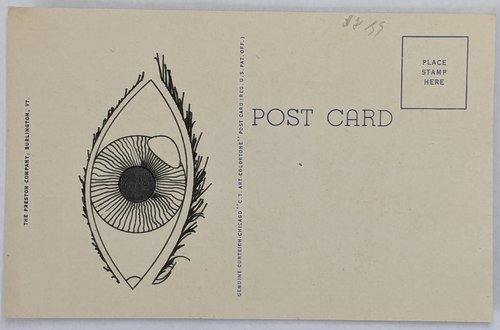
[picture p256: docs/assembly/assets/PXL_20240711_181326466.jpg]


Hack Club HQ address is

```
Hack Club
15 Falls Rd 
Shelburne, VT 05482
USA
```

### Debugging Common Issues

Your Blot can draw quite precisely, poor performance is often due to:

- Bad wheel spacing on the carriage or pen holder.
  
  - To address this use the wrench to turn the eccentric nuts. The rails or pen holder should not move other than the direction they are intended to slide in when you shake them. The wheels should be just tight enough to hold things in place.

- Bad pen height.
  
  - If your drawing has irregular pen strokes your pen may not be low enough or your surface may be uneven.

- Machine improperly homed.

- Paper sliding.
  
  - To secure the paper you can place one end beneath the Blot.
  
  - You can use tape to secure the other side.
  
  - You can also purchase a small whiteboard with magnets. I've found this to be the most reliable technique.
