3XAY/aPeacefulSceneBlot/hardware/motor-control-board/SETUP.md

# Firmware

assembled control board with annotations

You'll need a computer with the Arduino IDE installed, as well as the control board and a USB-C cable. After following these steps, you'll be set up to use your motor control board to interface with your new drawing machine.

## Hardware setup

Hold the `B` (BOOT) button on the XIAO board and plug it in to your computer.



The "RPI-RP2" disk should show up on your computer if the above step was successful.

disk in macos finder

## Software setup

> You'll need to have the latest version of the Arduino IDE installed. [Install it here.](https://www.arduino.cc/en/software/)

1. Open the Arduino IDE.
2. Add the Seeed Studio XIAO RP2040 board package to your IDE. Navigate to **Arduino IDE** > **Settings...** and add the following URLs to the **Additional Board Manager URLs** field. It's a single line, so you should combine the URLs with a comma.

```
https://github.com/earlephilhower/arduino-pico/releases/download/global/package_rp2040_index.json
https://raw.githubusercontent.com/qbolsee/ArduinoCore-fab-sam/master/json/package_Fab_SAM_index.json
```

4. Navigate to **Tools** > **Board** > **Boards Manager**, and search for "rp2040". Install the latest version of "Raspberry Pi Pico/RP2040" (author Earle F. Philhower, III).

rp2040 in boards manager

5. Now that you have the board package installed, you can upload the firmware to the board. Select your board and port in **Tools** > **Board** and find "**Seeed Studio XIAO RP2040**.

select board

To select the port, go to **Tools** > **Port** and select the serial port name of the connected board.

select serial port

> Then, install the following libraries via Arduino's library manager:
>
> - FlashStorage_SAMD (by Cristian Maglie, Khoi Hoang)
> - AccelStepper (by Mike McCauley)
> - osap (by Jake Robert Read)

1. Copy the Arduino code from the respective firmware file (found in [`./firmware`](./firmware/)) into your IDE and upload to your board.

> The firmware is very fresh and poorly documented (and rapidly changing). Ask in #haxidraw-developemnt for a link to the latest version.

Upload firmware to board

> Now you can write your own web interface and use it to control your machine. Check out some example [interfaces](../interfaces/) which are open source on GitHub.
