3XAY/aPeacefulSceneBlot/art/3D_Printer-Yash/snapshots/image1.png

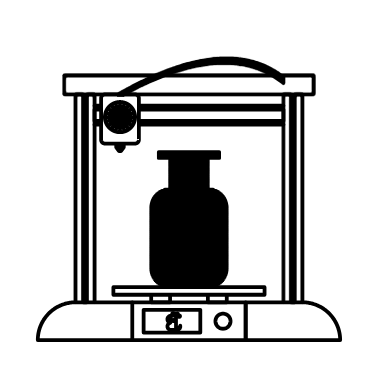
art/3D_Printer-Yash/snapshots/image1.png
