3XAY/aPeacefulSceneBlot/art/3D_Printer-Yash/snapshots/image2.png

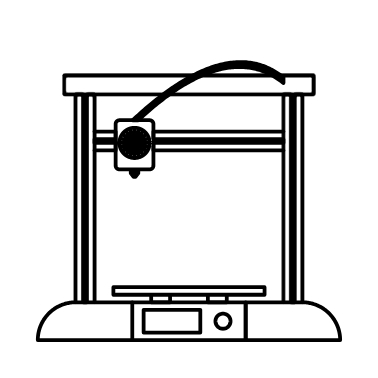
art/3D_Printer-Yash/snapshots/image2.png
