3XAY/aPeacefulSceneBlot/art/3D_Printer-Yash/snapshots/image3.png

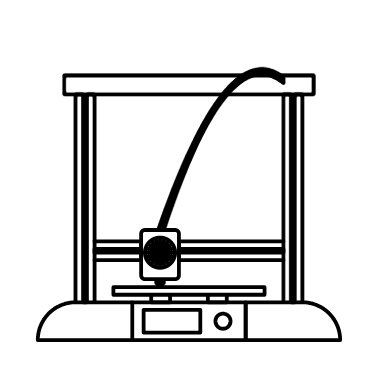
art/3D_Printer-Yash/snapshots/image3.png
