3XAY/aPeacefulSceneBlot/art/Building-Dominic/snapshots/snapshot0.png

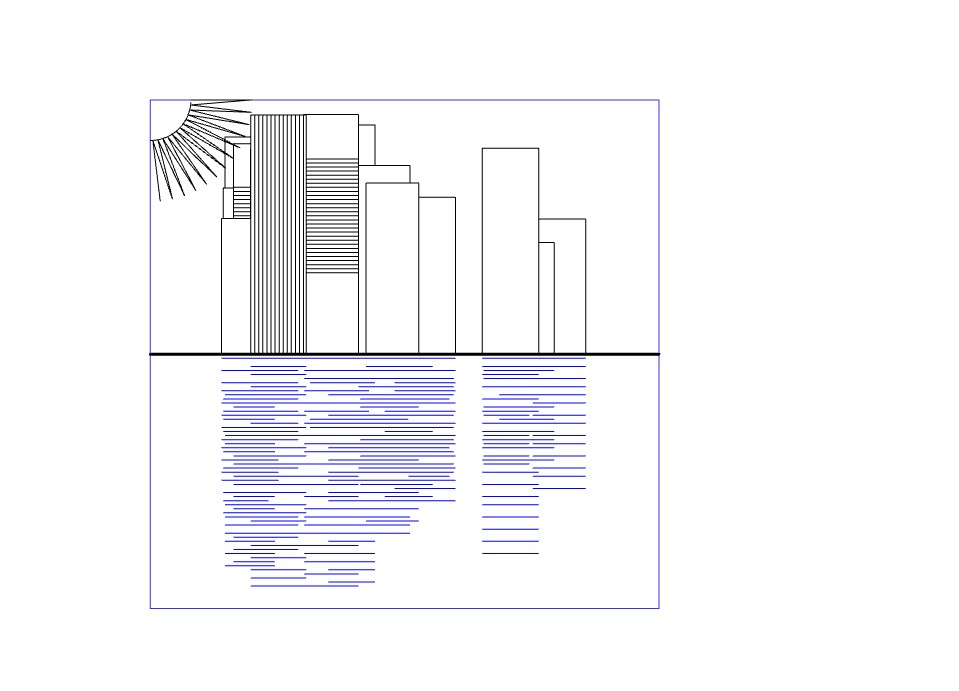
art/Building-Dominic/snapshots/snapshot0.png
