3XAY/aPeacefulSceneBlot/art/Building-Dominic/snapshots/snapshot1.png

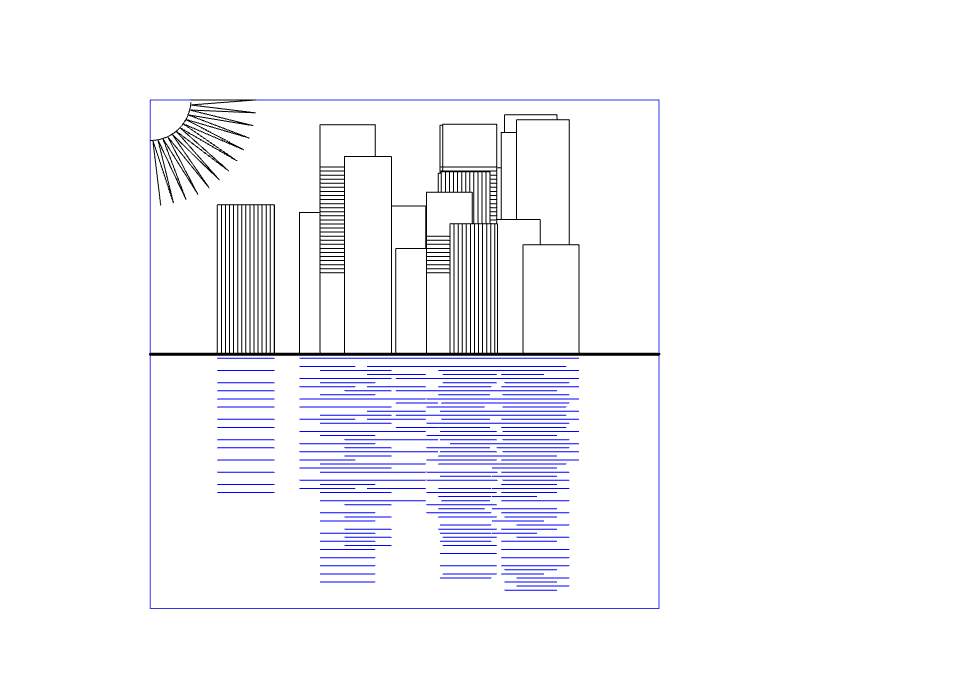
art/Building-Dominic/snapshots/snapshot1.png
