3XAY/aPeacefulSceneBlot/art/Building-Dominic/snapshots/snapshot2.png

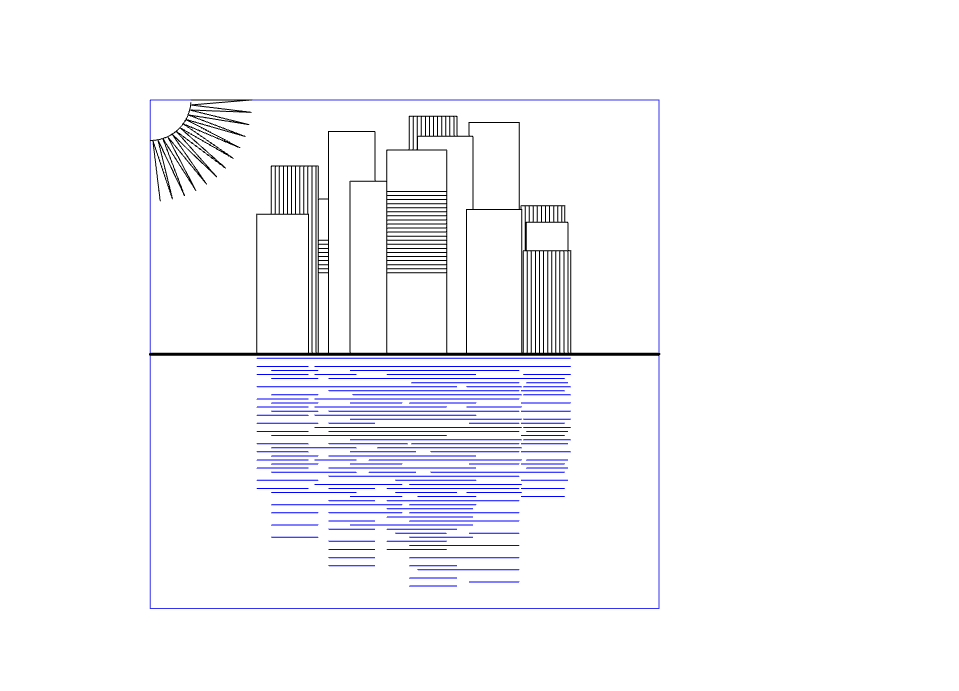
art/Building-Dominic/snapshots/snapshot2.png
