3XAY/aPeacefulSceneBlot/art/MinimalistDeskSetup-PranavBehal/snapshots/snapshot_1.png

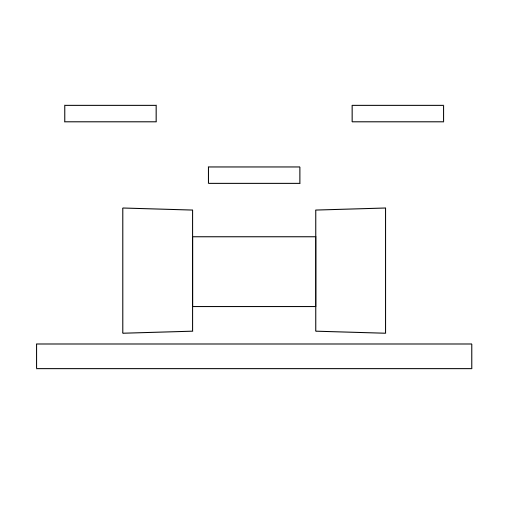
art/MinimalistDeskSetup-PranavBehal/snapshots/snapshot_1.png
