3XAY/aPeacefulSceneBlot/art/MinimalistDeskSetup-PranavBehal/snapshots/snapshot_2.png

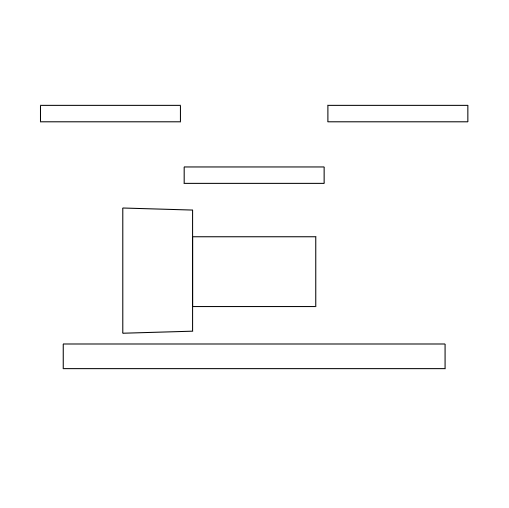
art/MinimalistDeskSetup-PranavBehal/snapshots/snapshot_2.png
