3XAY/aPeacefulSceneBlot/art/MinimalistDeskSetup-PranavBehal/snapshots/snapshot_3.png

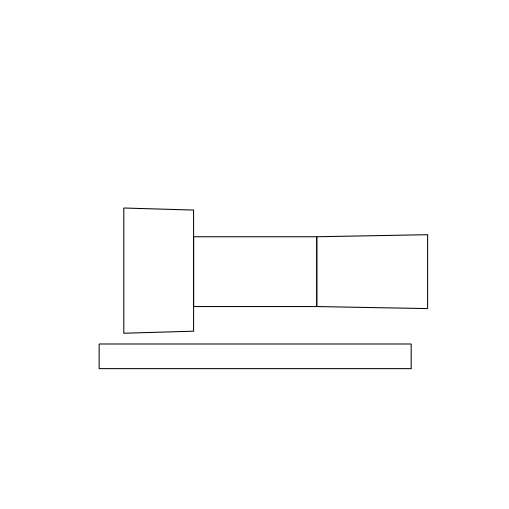
art/MinimalistDeskSetup-PranavBehal/snapshots/snapshot_3.png
