3XAY/aPeacefulSceneBlot/art/PizzaMaker-eminentquasar34/snapshots/perfectpizza.png

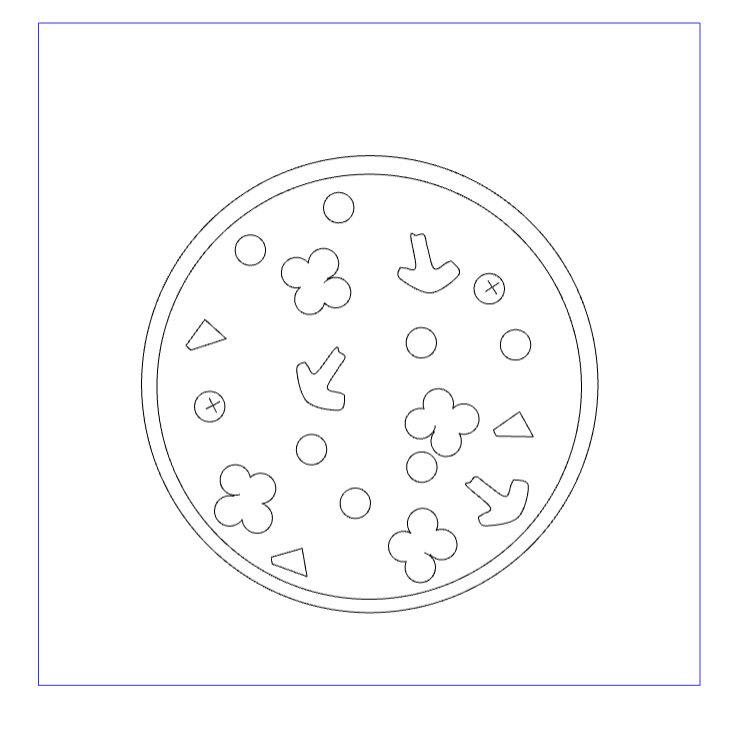
art/PizzaMaker-eminentquasar34/snapshots/perfectpizza.png
