3XAY/aPeacefulSceneBlot/art/PizzaMaker-eminentquasar34/snapshots/pizzadrawing2.png

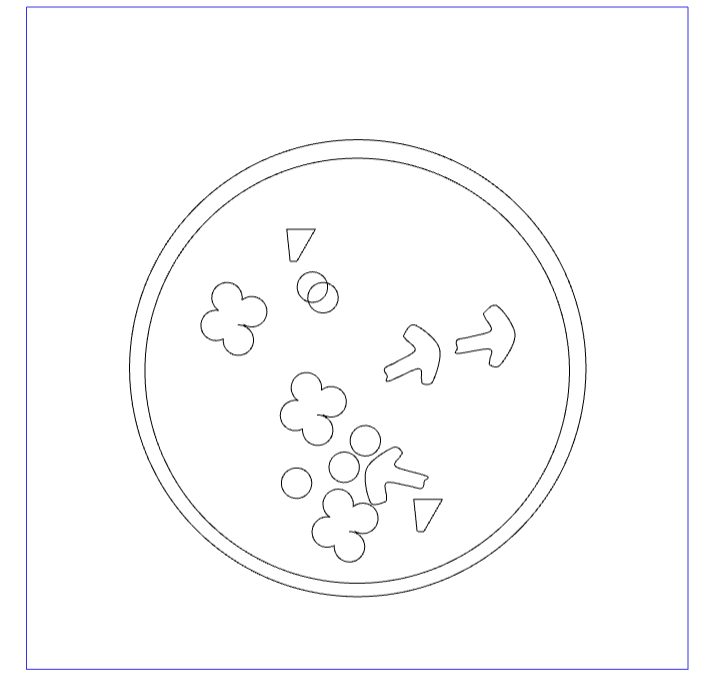
art/PizzaMaker-eminentquasar34/snapshots/pizzadrawing2.png
