3XAY/aPeacefulSceneBlot/art/PizzaMaker-eminentquasar34/snapshots/pizzadrawing3.png

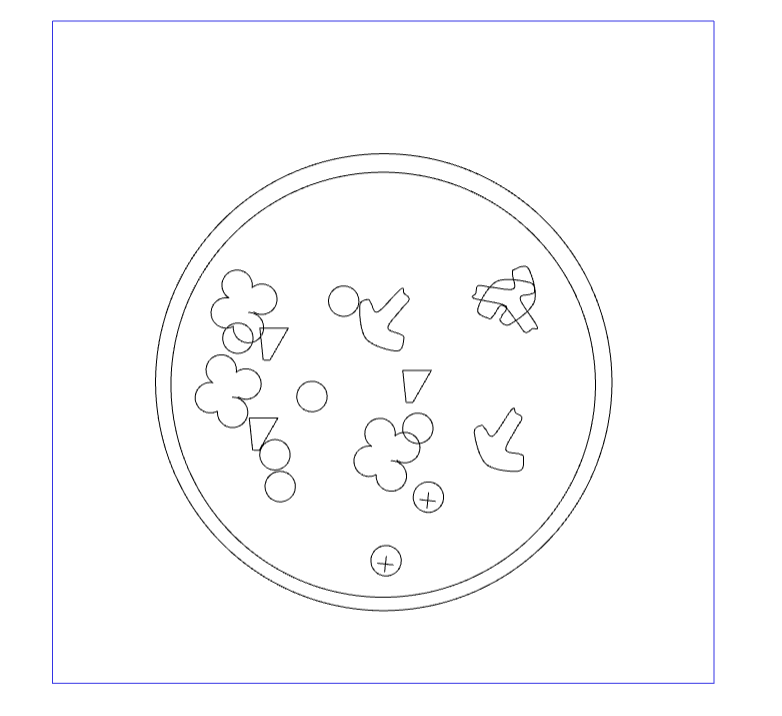
art/PizzaMaker-eminentquasar34/snapshots/pizzadrawing3.png
