3XAY/aPeacefulSceneBlot/docs/assembly/assets/PXL_20240613_152856981.jpg

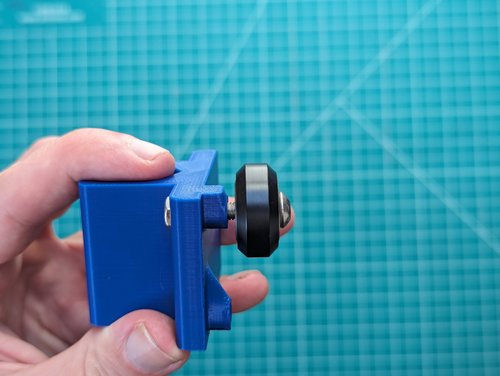
docs/assembly/assets/PXL_20240613_152856981.jpg
