3XAY/aPeacefulSceneBlot/docs/assembly/assets/Screenshot 2024-06-14 at 3.05.44 PM.png

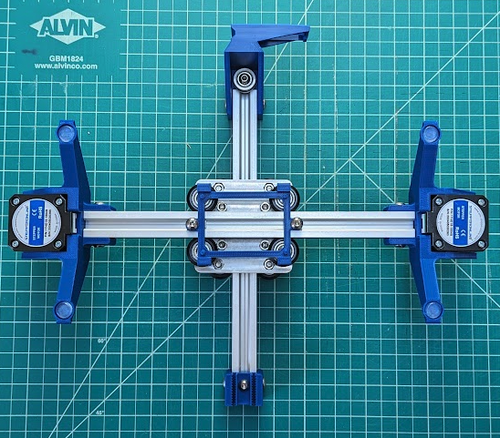
docs/assembly/assets/Screenshot 2024-06-14 at 3.05.44 PM.png
