3XAY/aPeacefulSceneBlot/docs/assembly/assets/Screenshot 2024-07-10 at 4.57.52 PM.png

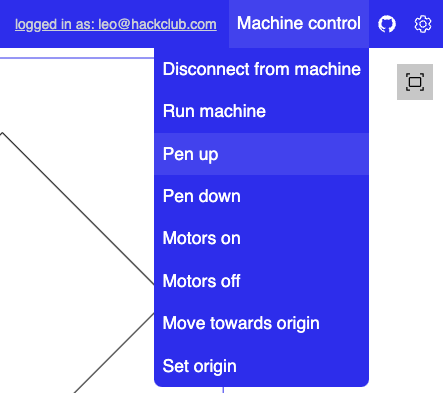
docs/assembly/assets/Screenshot 2024-07-10 at 4.57.52 PM.png
