3XAY/aPeacefulSceneBlot/docs/lesson/assets/guides.png

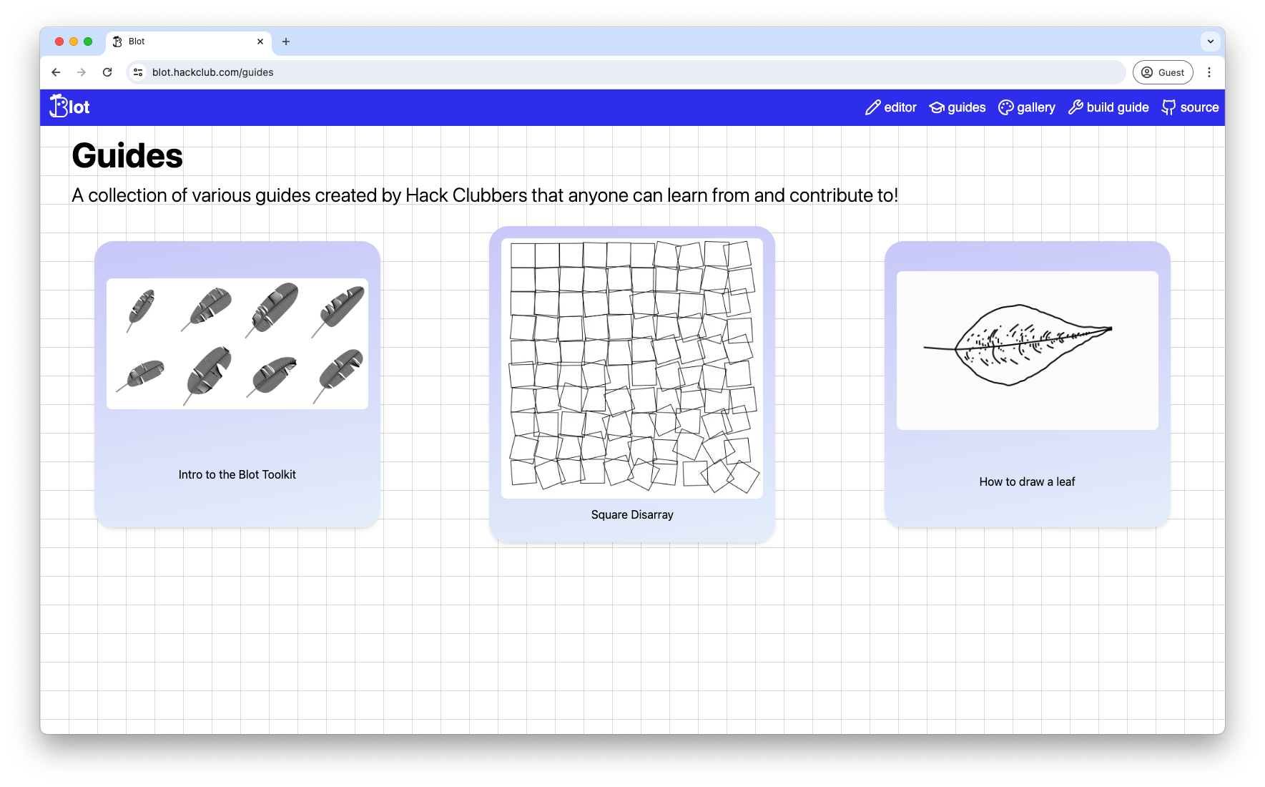
docs/lesson/assets/guides.png
