3XAY/aPeacefulSceneBlot/public/getting-started/curve.png

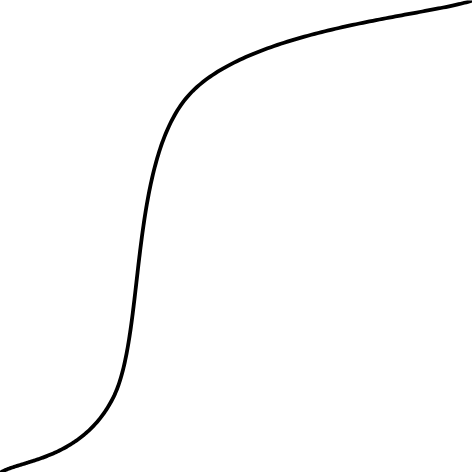
public/getting-started/curve.png
