3XAY/aPeacefulSceneBlot/public/getting-started/diagonal.png

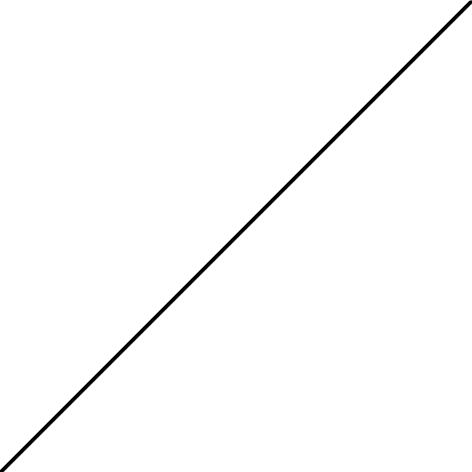
public/getting-started/diagonal.png
