3XAY/aPeacefulSceneBlot/public/getting-started/feather-1.png

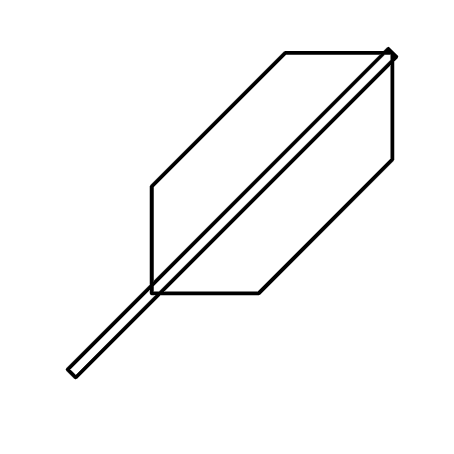
public/getting-started/feather-1.png
