3XAY/aPeacefulSceneBlot/public/getting-started/feather-2.png

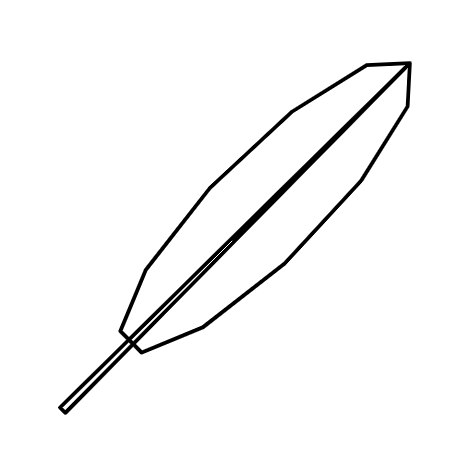
public/getting-started/feather-2.png
