3XAY/aPeacefulSceneBlot/public/getting-started/feather-3.png

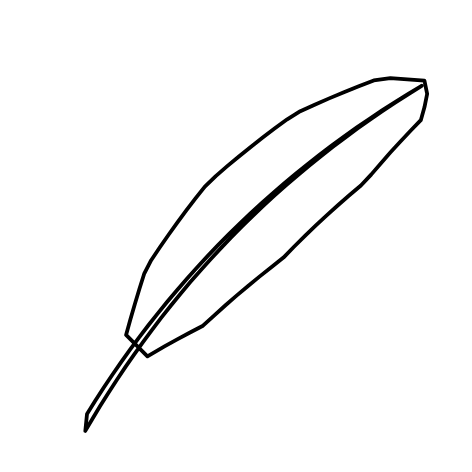
public/getting-started/feather-3.png
