3XAY/aPeacefulSceneBlot/public/getting-started/feather-4.png

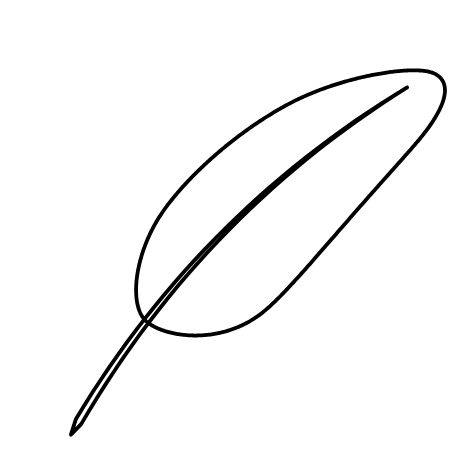
public/getting-started/feather-4.png
