3XAY/aPeacefulSceneBlot/public/getting-started/feather-5.png

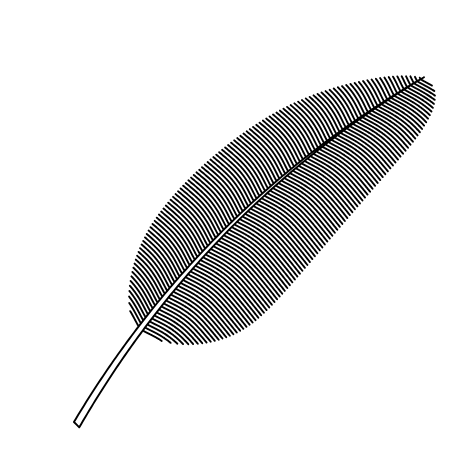
public/getting-started/feather-5.png
