3XAY/aPeacefulSceneBlot/public/getting-started/feather-montage.png

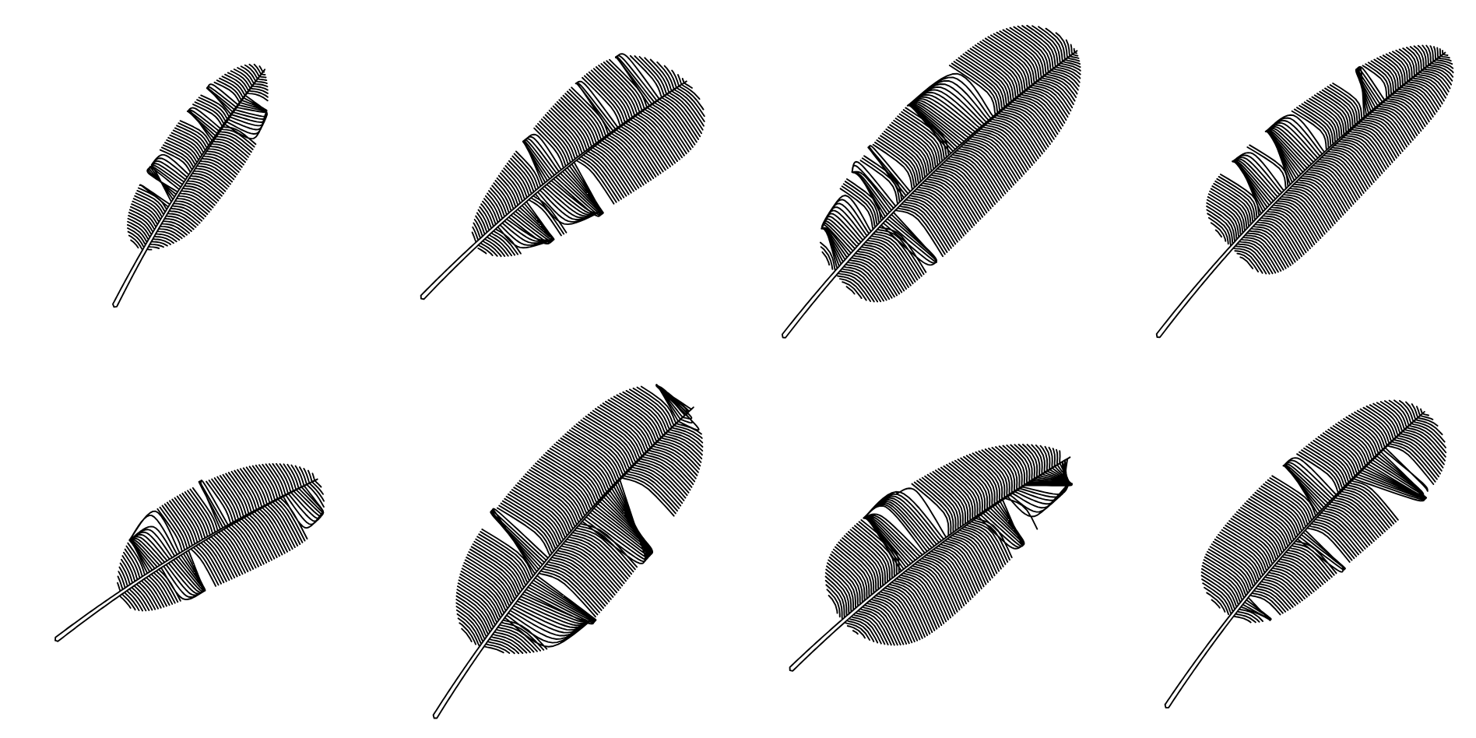
public/getting-started/feather-montage.png
